fabianhu/ueberloader/README.md

# ueberloader

A RC Battery Charger with high power output and quite small footprint.

Capable of charging 6S at 10A with 24V power supply.

Core component is a "full bridge converter" which is controlled via software.
