fabianhu/ueberloader/LipoLoader/PCB/bom.ods

Sheet: Bestellung 1
1 |  | CON_BOX_10L | SV5 | Farnell 1099245 od 835993 | 2 | 1099245 | 1099245,2, CON_BOX_10L SV5 | CON_BOX_10L SV5
1 |  | LED5MM | LED1 |  | 2 |  |  | LED5MM LED1
1 | 0.1R | R-EU_R2010 | R51 | Farnell 1100053 | 2 | 1100053 | 1100053,2, R-EU_R2010 R51 | R-EU_R2010 R51
1 | 0.005R | R-EU_R2010 | R20 | Farnell 1621986 | 25 | 1621986 | 1621986,25, R-EU_R2010 R20 | R-EU_R2010 R20
10 | 0R | R-EU_R0603 | R1, R2, R3, R5, R9, R10, R100, R101, R501, R502 |  | 20 |  |  | R-EU_R0603 R1 R2 R3 R5 R9 R10 R100 R101 R501 R502
1 | 1k - 0.1% | R-EU_R0603 | R69 | Farnell 1653252 | 0 |  |  | R-EU_R0603 R69
8 | 1u | C-EUC1206K | C11, C13, C15, C30, C31, C32, C33, C35 | Farnell 1759446 | 20 | 1759446 | 1759446,20, C-EUC1206K C11 C13 C15 C30 C31 C32 C33 C35 | C-EUC1206K C11 C13 C15 C30 C31 C32 C33 C35
1 | 2k - 0.1% | R-EU_R0603 | R68 | Farnell 1653263 | 2 |  |  | R-EU_R0603 R68
2 | 2k2 | R-EU_R0603 | R11, R24 |  | 4 |  |  | R-EU_R0603 R11 R24
8 | 4k7 | R-EU_R0603 | R43, R44, R45, R46, R47, R48, R75, R77 |  | 16 |  |  | R-EU_R0603 R43 R44 R45 R46 R47 R48 R75 R77
4 | 10µF | C-EUC1206K | C12 | Farnell 1611967 | 20 | 1611967 | 1611967,20, C-EUC1206K C12 | C-EUC1206K C12
4 | 10 | R-EU_R0603 | R4, R8, R87, R88 |  | 8 |  |  | R-EU_R0603 R4 R8 R87 R88
6 | 10 | R-EU_R2512 | R17, R18, R19, R21, R22, R32 | Farnell 9235892 od 1100110 | 12 | 9235892 | 9235892,12, R-EU_R2512 R17 R18 R19 R21 R22 R32 | R-EU_R2512 R17 R18 R19 R21 R22 R32
18 | 10k | R-EU_R0603 | R6, R38, R39, R40, R41, R42, R49, R50, R79, R80, R81, R82, R83, R84, R85, R86, R89, R90 |  | 36 |  |  | R-EU_R0603 R6 R38 R39 R40 R41 R42 R49 R50 R79 R80 R81 R82 R83 R84 R85 R86 R89 R90
2 | 10k - 0.1% | R-EU_R0603 | R29, R31 | Farnell 1653253 | 4 | 1653253 | 1653253,4, R-EU_R0603 R29 R31 | R-EU_R0603 R29 R31
2 | 10p | C-EUC0603 | C21, C22 | Farnell 1414600 | 100 | 1414600 | 1414600,100, C-EUC0603 C21 C22 | C-EUC0603 C21 C22
1 | 15V BZT55C15 | ZENER-DIODESOD80C | D5 | Farnell 1621844 | 2 | 1621844 | 1621844,2, ZENER-DIODESOD80C D5 | ZENER-DIODESOD80C D5
1 | 16MHz | CRYSTALHC49U-V | QU | Farnell 1469641 | 0 |  |  | CRYSTALHC49U-V QU
1 | 18k - 0.1% | R-EU_R0603 | R67 | Farnell 1160373 od 1400600 | 2 |  |  | R-EU_R0603 R67
12 | 20k - 0.1% | R-EU_R0603 | R2B, R27, R34, R35, R52, R60, R61, R62, R63, R64, R65, R66 | Farnell 1653264 | 24 |  |  | R-EU_R0603 R2B R27 R34 R35 R52 R60 R61 R62 R63 R64 R65 R66
12 | 27k - 0.1% | R-EU_R0603 | R1B, R25, R33, R36, R37, R53, R54, R55, R56, R57, R58, R59 | Farnell 1692500 | 24 |  |  | R-EU_R0603 R1B R25 R33 R36 R37 R53 R54 R55 R56 R57 R58 R59
1 | 27nH | R-EU_R0603 | L7 | Farnell 1457815 | 2 | 1457815 | 1457815,2, R-EU_R0603 L7 | R-EU_R0603 L7
1 | 33k - 0.1% | R-EU_R0603 | R28 | Farnell 1653270 | 2 |  |  | R-EU_R0603 R28
1 | 43k - 0.1% | R-EU_R0603 | R30 | Farnell 1400610 od 1670198 | 2 |  |  | R-EU_R0603 R30
3 | 63k4 - 0.1% | R-EU_R0603 | R70, R71, R72 | Farnell 1353179 | 6 |  |  | R-EU_R0603 R70 R71 R72
1 | 78L05SMD | 78L05SMD | IC4 | Farnell 1087098 | 10 |  |  | 78L05SMD IC4
1 | 100k | R-EU_R0603 | R26 |  | 2 |  |  | R-EU_R0603 R26
20 | 100n | C-EUC0603K | C1, C2, C3, C4, C5, C6, C9, C14, C16, C17, C18, C23, C24, C25, C26, C27, C28, C29, C36, C37 |  | 40 |  |  | C-EUC0603K C1 C2 C3 C4 C5 C6 C9 C14 C16 C17 C18 C23 C24 C25 C26 C27 C28 C29 C36 C37
2 | 100u Tan | CPOL-EUSMCC | C19, C20 | Farnell 1754066 | 4 | 1754066 | 1754066,4, CPOL-EUSMCC C19 C20 | CPOL-EUSMCC C19 C20
2 | 330µF / 25V | CPOL-EUE3.5-8 | C7, C8 | Farnell 1219469 | 50 | 1219469 | 1219469,50, CPOL-EUE3.5-8 C7 C8 | CPOL-EUE3.5-8 C7 C8
2 | 330 | R-EU_R0603 | R74, R76 |  | 4 |  |  | R-EU_R0603 R74 R76
1 | 330 | R-EU_R0805 | R12 |  | 2 |  |  | R-EU_R0805 R12
2 | 1000µF/35V | CPOL | C10, C34 | Farnell 1219476 | 4 | 1219476 | 1219476,4, CPOL C10 C34 | CPOL C10 C34
1 | AVR_XMEGA_A4_44A | AVR_XMEGA_A4_44A | IC3 | http://shop.embedit.de/product__809.php | 2 |  |  | AVR_XMEGA_A4_44A IC3
5 | BC817-25SMD | BC817-25SMD | Q7, Q8, Q9, Q10, Q11 | Farnell 1081223 | 10 |  |  | BC817-25SMD Q7 Q8 Q9 Q10 Q11
1 | COILCRAFT_D333 | COILCRAFT_D333 | L1 |  | 2 |  |  | COILCRAFT_D333 L1
3 | FDC6401N | FDC6401N | T7, T8, T9 | Farnell 1467966 | 8 | 1467966 | 1467966,8, FDC6401N T7 T8 T9 | FDC6401N T7 T8 T9
2 | Fuse 10A | R-EU_WSC2515 | F1, F2 | RS 131-505 | 4 |  |  | R-EU_WSC2515 F1 F2
1 | ILD217 | ILD217 | OK1 | Farnell 1469512 | 4 | 1469512 | 1469512,4, ILD217 OK1 | ILD217 OK1
2 | IR2181=NCP5181 | IR2181=NCP5181 | U$5, U$6 | Farnell 1547140 | 10 | 1547140 | 1547140,10, IR2181=NCP5181 U$5 U$6 | IR2181=NCP5181 U$5 U$6
4 | LL43-GS08 | DIODE-SOD80C | D1, D2, D3, D4 | Farnell 1779222 oder alt. 9804226 | 25 | 1779222 | 1779222,25, DIODE-SOD80C D1 D2 D3 D4 | DIODE-SOD80C D1 D2 D3 D4
2 | LM224D | LM324D | IC1, IC2 | Farnell 1426352 Reichelt | 25 | 1426352 | 1426352,25, LM324D IC1 IC2 | LM324D IC1 IC2
1 | LM1117 | LM1117 | U$1 |  | 2 |  |  | LM1117 U$1
7 | MOSFET-NIRLR8743 | MOSFET-NIRLR8743 | T1, T2, T3, T4, T5, T6, T11 | Farnell 1551908 | 100 | 1551908 | 1551908,100, MOSFET-NIRLR8743 T1 T2 T3 T4 T5 T6 T11 | MOSFET-NIRLR8743 T1 T2 T3 T4 T5 T6 T11
2 | NB12K00103JBB | R-EU_R0603 | R7, R23 | Farnell 9528075 | 5 | 9528075 | 9528075,5, R-EU_R0603 R7 R23 | R-EU_R0603 R7 R23
6 | SOLPAD3MM | SOLPAD3MM | BATT+, BATT-, COIL1, COIL2, SUPP+, SUPP- |  | 12 |  |  | SOLPAD3MM BATT+ BATT- COIL1 COIL2 SUPP+ SUPP-
4 | TPTP15R | TPTP15R | TP1, TP2, TP3, TP4 |  | 8 |  |  | TPTP15R TP1 TP2 TP3 TP4
1 | aux1 | MA04-1 | SV2 |  | 2 |  |  | MA04-1 SV2
1 | comm | ML6L | SV4 | Farnell 1096979 Bu 1097021 | 2 | 1096979 | 1096979,2, ML6L SV4 | ML6L SV4
1 | encoder | MA04-1 | AUX2 |  | 2 |  |  | MA04-1 AUX2
1 | spare | MA07-1 | SV1 |  | 2 |  |  | MA07-1 SV1
 |  | IRLR8726PBF |  |  | 1 | 1698305 | 1698305,1, IRLR8726PBF | IRLR8726PBF
 |  | IRLR8721 |  |  | 1 | 1551907 | 1551907,1, IRLR8721 | IRLR8721
 |  | bu 6 |  |  | 4 | 1097021 | 1097021,4, bu 6 | bu 6
 |  | Bu10 |  |  | 3 | 1099236 | 1099236,3, Bu10 | Bu10
 |  | 100nf |  |  | 1000 | 1692286 (http://de.farnell.com/kemet/c0603c104k5rac-tu/capacitor-mlcc-0603-50v-0-1uf/dp/1692286) | 1692286,1000, 100nf | 100nf

Sheet: Bestellung 2
 |  |  |  |  |  | 4
Qty | Value | Device | Parts | BEST | vorhanden | zu Bestellen | Farnell importer
0 | aux | MA04-1 | AUX1 |  |  | 0 |  | aux
0 | encoder | MA04-1 | AUX2 |  |  | 0 |  | encoder
0 | SOLPAD3MM | SOLPAD3MM | BATT+, BATT-, COIL1, COIL2, SUPP+, SUPP- |  |  | 0 |  | SOLPAD3MM
21 | 100n | C-EUC0603K | C1, C2, C3, C4, C5, C6, C9, C13, C14, C16, C17, C18, C23, C24, C25, C26, C27, C28, C29, C36, C37 |  | 1000 | 0 |  | 100n
2 | 1000µF/35V | CPOL | C10, C34 | Farnell 1219476 | 8 | 0 |  | 1000µF/35V
9 | 1u | C-EUC1206K | C11, C15, C30, C31, C32, C33, C38, C39, C40 | Farnell 1759446 | 40 | 0 |  | 1u
5 | 10µF | C-EUC1206K | C12, C35, C41, C42, C43 | Farnell 1611967 | 20 | 0 |  | 10µF
2 | 100u Tan | CPOL-EUSMCC | C19, C20 | Farnell 1754066 | 10 | 0 |  | 100u Tan
2 | 10p | C-EUC0603 | C21, C22 | Farnell 1414600 | 100 | 0 |  | 10p
2 | 330µF / 25V | CPOL-EUE3.5-8 | C7, C8 | Farnell 1219469 | 50 | 0 |  | 330µF / 25V
6 | LL43-GS08 | DIODE-SOD80C | D1, D2, D3, D4, D6, D7 | Farnell 9804226 oder alt. 1779222 | 25 | 0 |  | LL43-GS08
1 | 15V BZT55C15 | ZENER-DIODESOD80C | D5 | Farnell 1621844 | 10 | 0 |  | 15V BZT55C15
0 | Fuse 10A | R-EU_WSC2515 | F1, F2 | RS 131-505 | 0 | 0 |  | Fuse 10A
2 | LM224D | LM324D | IC1, IC2 | Farnell 1426352 | 25 | 0 |  | LM224D
1 | AVR_XMEGA_A4_44A | AVR_XMEGA_A4_44A | IC3 | http://shop.embedit.de/product__809.php | 24 | 0 |  | AVR_XMEGA_A4_44A
1 | 78L10SMD | 78L10SMD | IC5 | Reichelt µA 78L10 SMD | 4 | 0 |  | 78L10SMD
1 | COILCRAFT_D333 | COILCRAFT_D333 | L1 |  | 5 | 0 |  | COILCRAFT_D333
1 | 27nH | R-EU_R0603 | L7 | Farnell 1457815 | 5 | 0 |  | 27nH
1 |  | LED5MM | LED1 |  | 10 | 0 |  | 0
1 | ILD217 | ILD217 | OK1 | Farnell 1469512 | 4 | 0 |  | ILD217
7 | BC817-25SMD | BC817-25SMD | Q1, Q2, Q7, Q8, Q9, Q10, Q11 | Reichelt BC 817-25 SMD |  | 28 | BC 817,28, BC817-25SMD | BC817-25SMD
1 | 16MHz | CRYSTALHC49U-V | QU | Farnell 1469641 | 4 | 0 |  | 16MHz | Achtung, Quarz ist für SMD, aber Thru hole im Design!
4 | 2k2 | R-EU_R0603 | R1, R11, R14, R24 | Farnell 1469765 | 50 | 0 |  | 2k2
1 | 330 | R-EU_R0805 | R12 | Farnell 1469803 | 50 | 0 |  | 330
6 | 10 | R-EU_R2512 | R17, R18, R19, R21, R22, R32 | Farnell 9235892 od 1100110 | 30 | 0 |  | 10
12 | 47k - 0.1% | R-EU_R0603 | R1B, R25, R33, R36, R37, R53, R54, R55, R56, R57, R58, R59 | Farnell 1653309 | 50 | 0 |  | 47k - 0.1% | Achtung, Widerstand ist 0806
23 | 10k | R-EU_R0603 | R2, R6, R38, R39, R40, R41, R42, R49, R50, R73, R77, R79, R80, R81, R82, R83, R84, R85, R86, R90, R91, R92, R100 | Farnell 1469749 | 100 | 0 |  | 10k
1 | 0.005R | R-EU_R2010 | R20 | Farnell 1621986 | 25 | 0 |  | 0.005R
1 | 100k | R-EU_R0603 | R26 | Farnell 1469649 | 50 | 0 |  | 100k
3 | 10k - 0.1% | R-EU_R0603 | R29, R31, R67 | Farnell 1653253 | 12 | 0 |  | 10k - 0.1%
12 | 22k - 0.1% | R-EU_R0603 | R2B, R27, R34, R35, R52, R60, R61, R62, R63, R64, R65, R66 | Farnell 1653299 | 50 | 0 |  | 22k - 0.1% | Achtung, Widerstand ist 0806
9 | 0R | R-EU_R0603 | R3, R5, R9, R10, R13, R15, R16, R101, R502 | Farnell 1469739 | 50 | 0 |  | 0R
4 | 4r7 | R-EU_R0603 | R4, R8, R87, R88 | Farnell 9332189 | 50 | 0 |  | 4r7
7 | 4k7 | R-EU_R0603 | R43, R44, R45, R46, R47, R48, R78 | Farnell 1469807 | 50 | 0 |  | 4k7
1 | 0.1R | R-EU_R2010 | R51 | Farnell 1100053 | 5 | 0 |  | 0.1R
3 | 2k - 0.1% | R-EU_R0603 | R68, R69, R95 | Farnell 1653263 | 12 | 0 |  | 2k - 0.1%
2 | NB12K00103JBB | R-EU_R0603 | R7, R23 | Farnell 9528075 | 10 | 0 |  | NB12K00103JBB
1 | 36k - 0.1% | R-EU_R0603 | R70 | Farnell 1400608 | 5 | 0 |  | 36k - 0.1%
3 | 120k - 0.1% | R-EU_R0603 | R71, R72, R97 | Farnell 1612041 | 12 | 0 |  | 120k - 0.1%
2 | 820 | R-EU_R0603 | R74, R76 | Farnell 1469841 | 50 | 0 |  | 820
0 | spare | MA07-1 | SV1 |  |  | 0 |  | spare
1 | comm | ML6L | SV4 | Farnell 1096979 Bu 1097021 | 4 | 0 |  | comm
1 |  | CON_BOX_10L | SV5 | Farnell 1099245 od 835993 | 2 | 2 | 1099245,2, 0 | 0
7 | MOSFET-NIRLR8743 | MOSFET-NIRLR8743 | T1, T2, T3, T4, T5, T6, T11 | Farnell 1551908 | 99 | 0 |  | MOSFET-NIRLR8743
1 | FDC6401N | FDC6401N | T10 | Farnell 1467966 | 8 | 0 |  | FDC6401N
3 | QS6J1=FDC6312P | QS6J1=FDC6312P | T8, T9, T14 | Farnell 1525470 od 1700713 | 12 | 0 |  | QS6J1=FDC6312P
0 | TPTP15R | TPTP15R | TP1, TP2, TP3, TP4, TP5, TP6 |  |  | 0 |  | TPTP15R
1 | LM1117 | LM1117 | U$1 |  | 80 | 0 |  | LM1117
2 | LM5106 | LM5106 | U$3, U$4 | Farnell 1312793 | 10 | 0 |  | LM5106
1 | bu 6 |  |  | Farnell 1097021 | 4 | 0 |  | bu 6
1 | Bu10 | Buchse 8! |  | Fischer s.u. | 4 | 0 |  | Bu10
 |  |  |  |  |  | 0 |  | 0
2 | L4941 | DPAK |  | Farnell 1703361 | 8 | 0 |  | L4941
 |  |  |  | Farnell 1324703 | 1 | 0
 | lm317 |  |  | Farnell 1469087 | 10 | 0
 | Gehäuse Lader |  |  | Fischer AKG 55 24 100 SA | 2
 | Gehäuse Display |  |  | Fischer AKG 55 16 80 SA | 1
 | Gehäuse Combi |  |  | Fischer AKG 55 28 100 SA | 2
 | Winkelstecker 8 Pol |  |  | Fischer ASLA 08 G | 10
 | Winkelstecker 6 Pol |  |  | Fischer ASLA 06 G | 15
 | Buchsen 8 Pol |  |  | Fischer FLMP 08 G | 20
 | Buchsen 6 Pol |  |  | Fischer FLMP 06 G | 15
 | Ringkern |  |  | http://www.spulen.com Artikelnummer:T24/011/9 Hersteller:Magnetics (55350-A2)
 | Draht | Durchmesser 1,4mm 25 Windungen |  | www.spulen.com
