fabianhu/ueberloader/LipoDisp/GEH.DXF

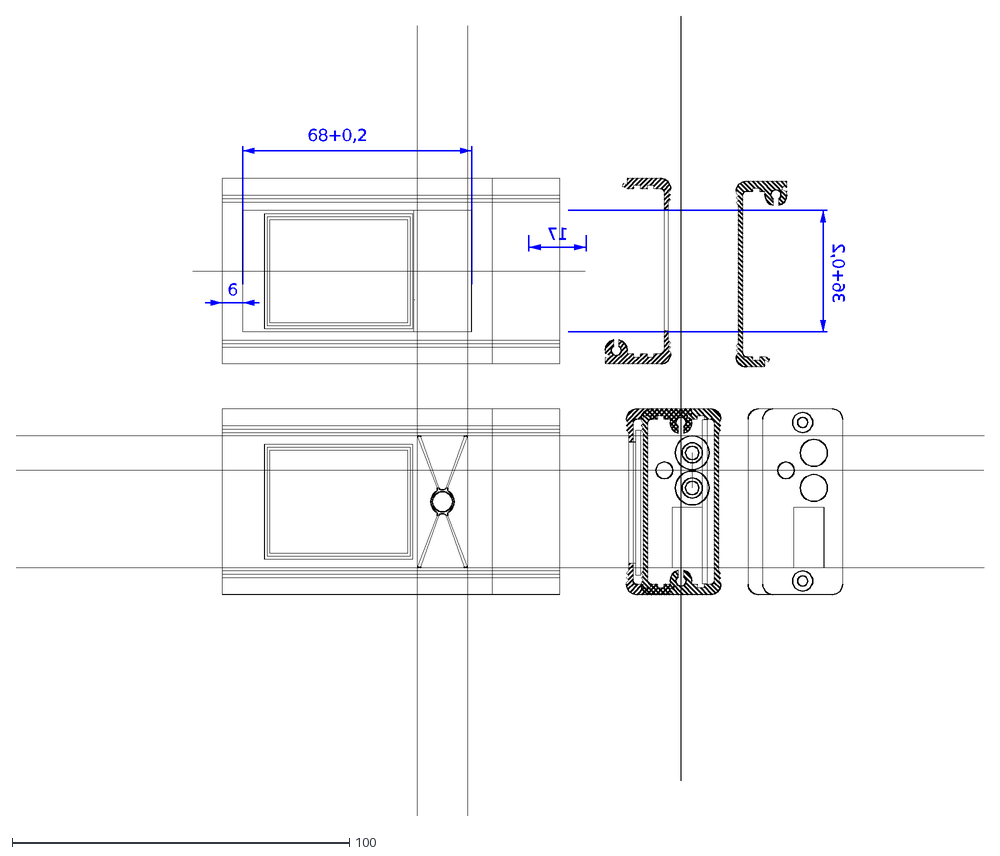
[picture p1: CAD file, 2011-10-27]
LipoDisp/GEH.DXF
68+0,2
36+0,2
6
17
