fabianhu/ueberloader/Calc/Voltage Measurement.ods

Adc-max-U | 2,06
ADC-Offset | 185
R1 | 120000
R2 | 10000
Uin | 12 | 1 | 20 | 24 | 26,8 | 0
Uout | 0,92307692 | 0,07692308 | 1,53846154 | 1,84615385 | 2,06153846 | 0,00000000 | 0,00000000
ADC | 0,45 | 0,04 | 0,75 | 0,9 | 1 | 0
 | 2018,17 | 337,76 | 3240,29 | 3851,35 | 4279,09 | 185
 | 1,96
 | 4,2
factor for cell measure | 2,13958
