fabianhu/ueberloader/Calc/NTC measure.ods

Type: | NB 12 K 0 0103, Farnell 1672286
R @25°C | 10000
B | 3630
alfa | -4
Rpar | 3300
Rvor | 2200
Usupp | 3,3
Theta | R | U2 | Bits | Rpar | U2 par
0 | 30475,01 | 3,08 | 3820,22 | 2977,57 | 1,9
2 | 27668,91 | 3,06 | 3794,31 | 2948,36 | 1,89
4 | 25156,24 | 3,03 | 3766,6 | 2917,31 | 1,88
6 | 22902,98 | 3,01 | 3737,03 | 2884,4 | 1,87
8 | 20879,39 | 2,99 | 3705,56 | 2849,62 | 1,86
10 | 19059,5 | 2,96 | 3672,13 | 2812,96 | 1,85
12 | 17420,5 | 2,93 | 3636,73 | 2774,43 | 1,84
14 | 15942,4 | 2,9 | 3599,31 | 2734,06 | 1,83
16 | 14607,62 | 2,87 | 3559,86 | 2691,88 | 1,82
18 | 13400,68 | 2,83 | 3518,38 | 2647,93 | 1,8
20 | 12307,94 | 2,8 | 3474,88 | 2602,28 | 1,79
22 | 11317,35 | 2,76 | 3429,36 | 2554,99 | 1,77
24 | 10418,24 | 2,72 | 3381,86 | 2506,17 | 1,76
26 | 9601,18 | 2,68 | 3332,42 | 2455,89 | 1,74
28 | 8857,81 | 2,64 | 3281,08 | 2404,28 | 1,72
30 | 8180,68 | 2,6 | 3227,93 | 2351,45 | 1,7
32 | 7563,2 | 2,56 | 3173,02 | 2297,53 | 1,69
34 | 6999,48 | 2,51 | 3116,47 | 2242,66 | 1,67
36 | 6484,26 | 2,46 | 3058,35 | 2186,99 | 1,65
38 | 6012,88 | 2,42 | 2998,8 | 2130,65 | 1,62
40 | 5581,15 | 2,37 | 2937,92 | 2073,81 | 1,6
42 | 5185,31 | 2,32 | 2875,85 | 2016,61 | 1,58
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
