fabianhu/ueberloader/doc/6300_RM-217_RM-222_schematics.pdf

# Customer Care / Service Operations / Content Creation Team

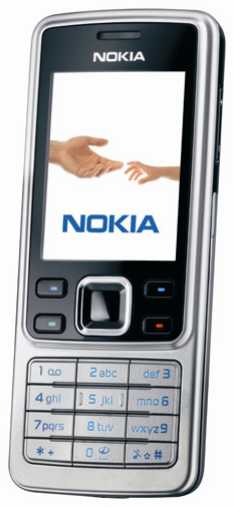
[picture p2: figure]

Confidential Copyright © 2006 NOKIA Only for training purposes | Version: 2.0 | | 19.12.2006 | 6300 | | Board version: 1ywa_32 | | | | Page (11)

# Service Schematics

# Introduction

# RM-217/RM-222

# Important:

This document is intended for use by authorized service centers only.

“Service Schematics“ was created with focus on customer care.

# The purpose of this document is to provide further technical repair information for

NOKIA mobile phones on Level 3/4 service activities.
It contains additional information such as e.g. “Component finder”,
“Frequency band table” or “Antenna switch table”.

# The “Signal overview” page gives a good and fast overview about the most

important signals and voltages on board.
Saving process time and improving the repair quality is the aim of this document.

# It is to be used additionaly to the service manual and other training

or service information such as Service Bulletins.

# All measurements were made using following equipment:

Nokia repair SW | : | Phoenix version 2006.34.2.156
Oscilloscope | : | Fluke PM 3380A/B
Spectrum Analyzer | : | Advanced R3162 with an analog probe
RF-Generator/GSM Tester : | Rhode & Schwarz CMU 200
Multimeter | : | Fluke 73 Series II

# While every endeavour has been made to ensure the accuracy of this document, some

errors may exist. If the reader finds any errors, NOKIA should be notified in writing.

# Please send E-Mail to: training.sace@nokia.com

# Table of contents

# Copyright © NOKIA This material , including documentation and any related computer programs is

protected by copyright, controlled by NOKIA. All rights are reserved. Copying,

# including reproducing, modifying, storing, adapting or translating any or all of this material requires the prior written consent of NOKIA. This material also contains confidential information, which may not be disclosed to others whitout the prior written

consent of NOKIA.

# Frontpage

Frontpage | 1

# AV connector, Mini USB, Charger jack 2

RETU, SIM, Audio | 3
TAHVO | 4
RAPGSM, Combo, microSD | 5
FM radio, Bluetooth | 6
User Interface | 7
Camera | 8
RF Part | 9
Signal overview | 10
Component finder | 11

# Charger jack

# AV connector

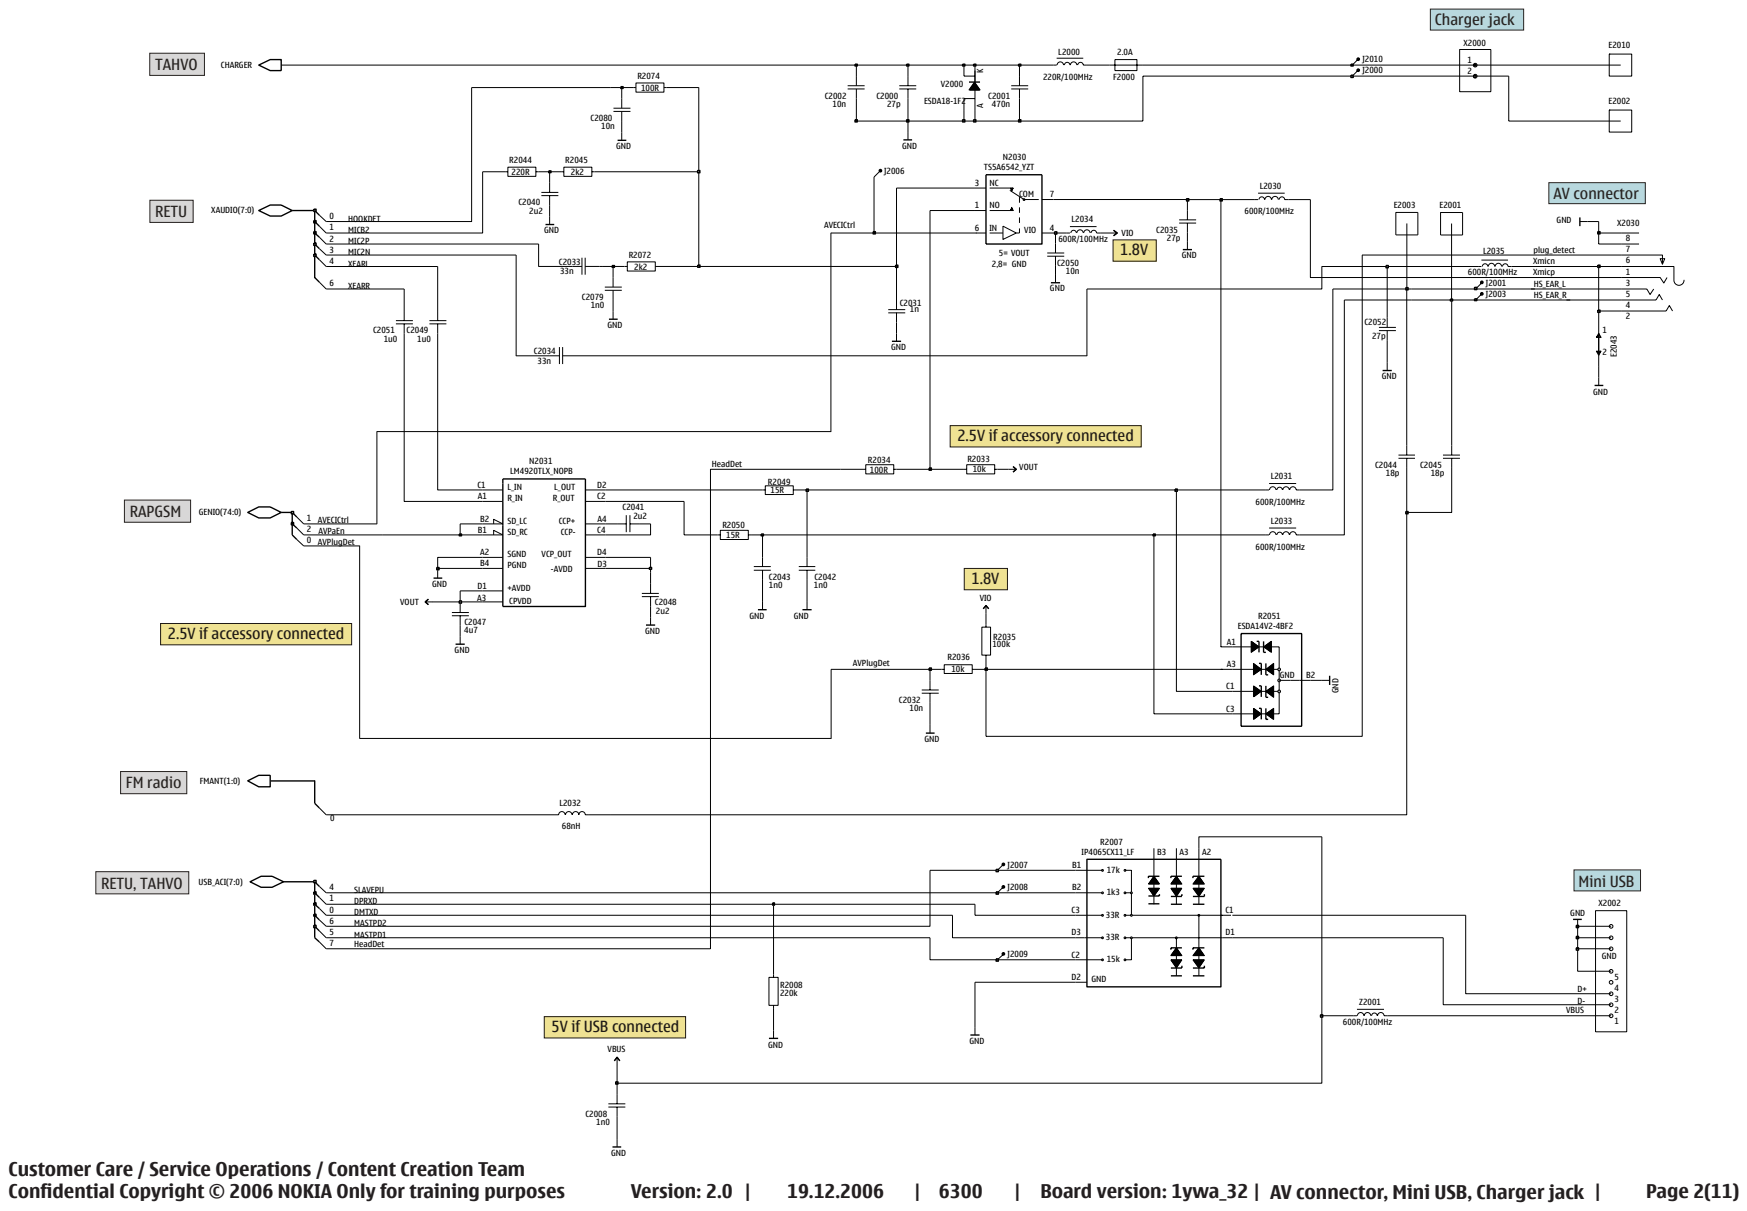
[picture p3: page 2]

L2270
L2102

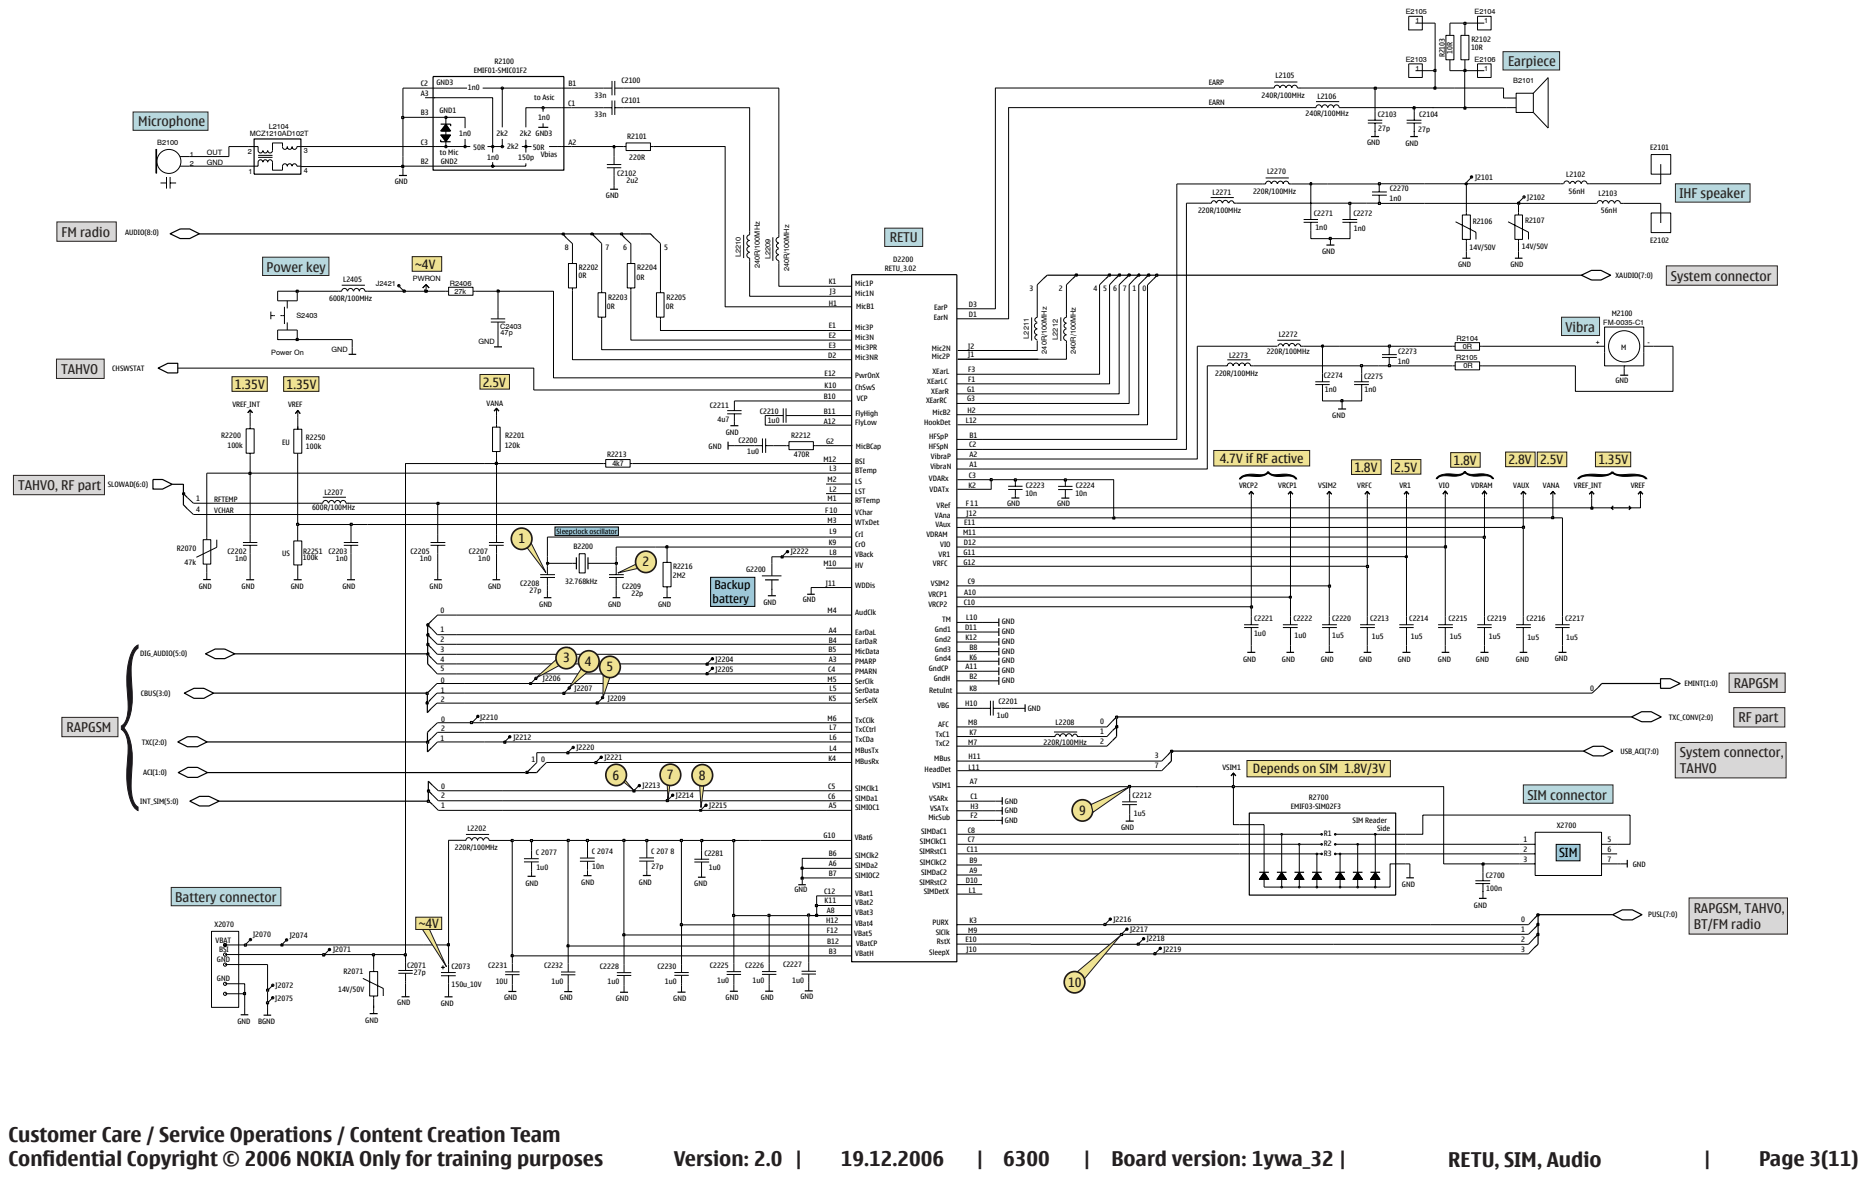
[picture p4: page 3]

VBat4 H12
F12

N2300

# TAHVO_V5.2_LF

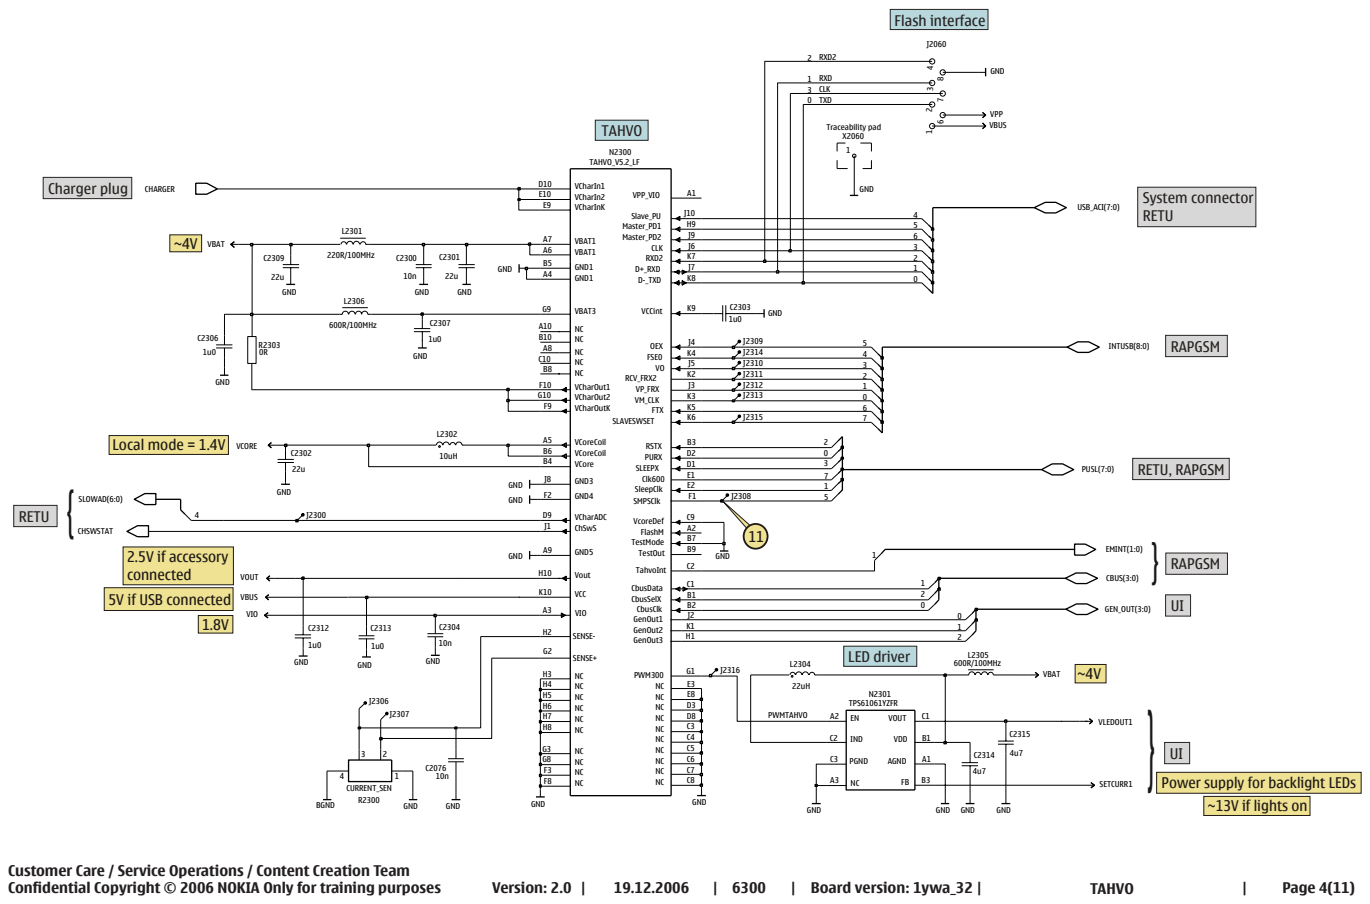
[picture p5: page 4]

Power supply for backlight LEDs
~13V if lights on

# microSD connector

# RAPGSM

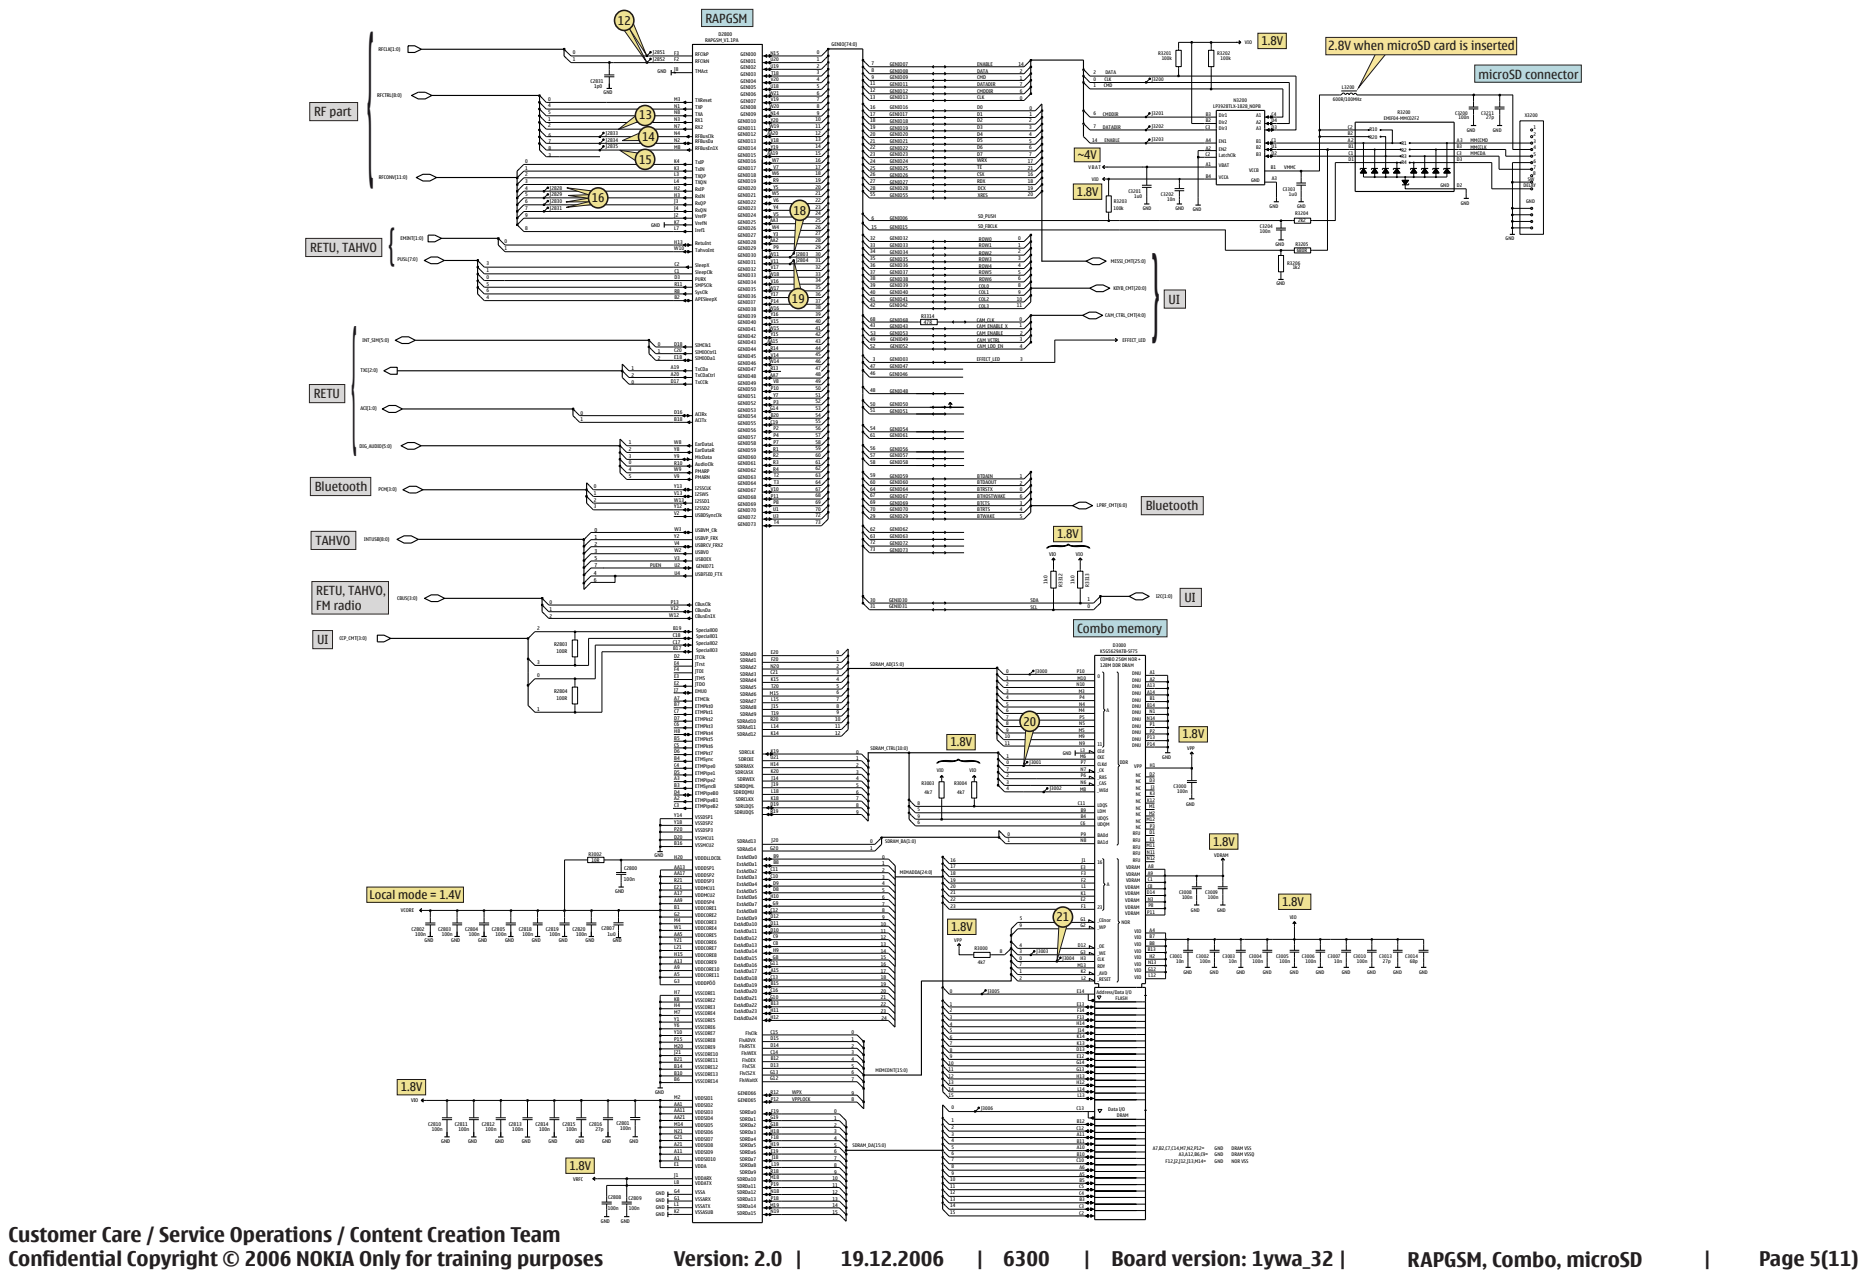
[picture p6: page 5]

2.8V when microSD card is inserted

# FM radio

# RAPGSM

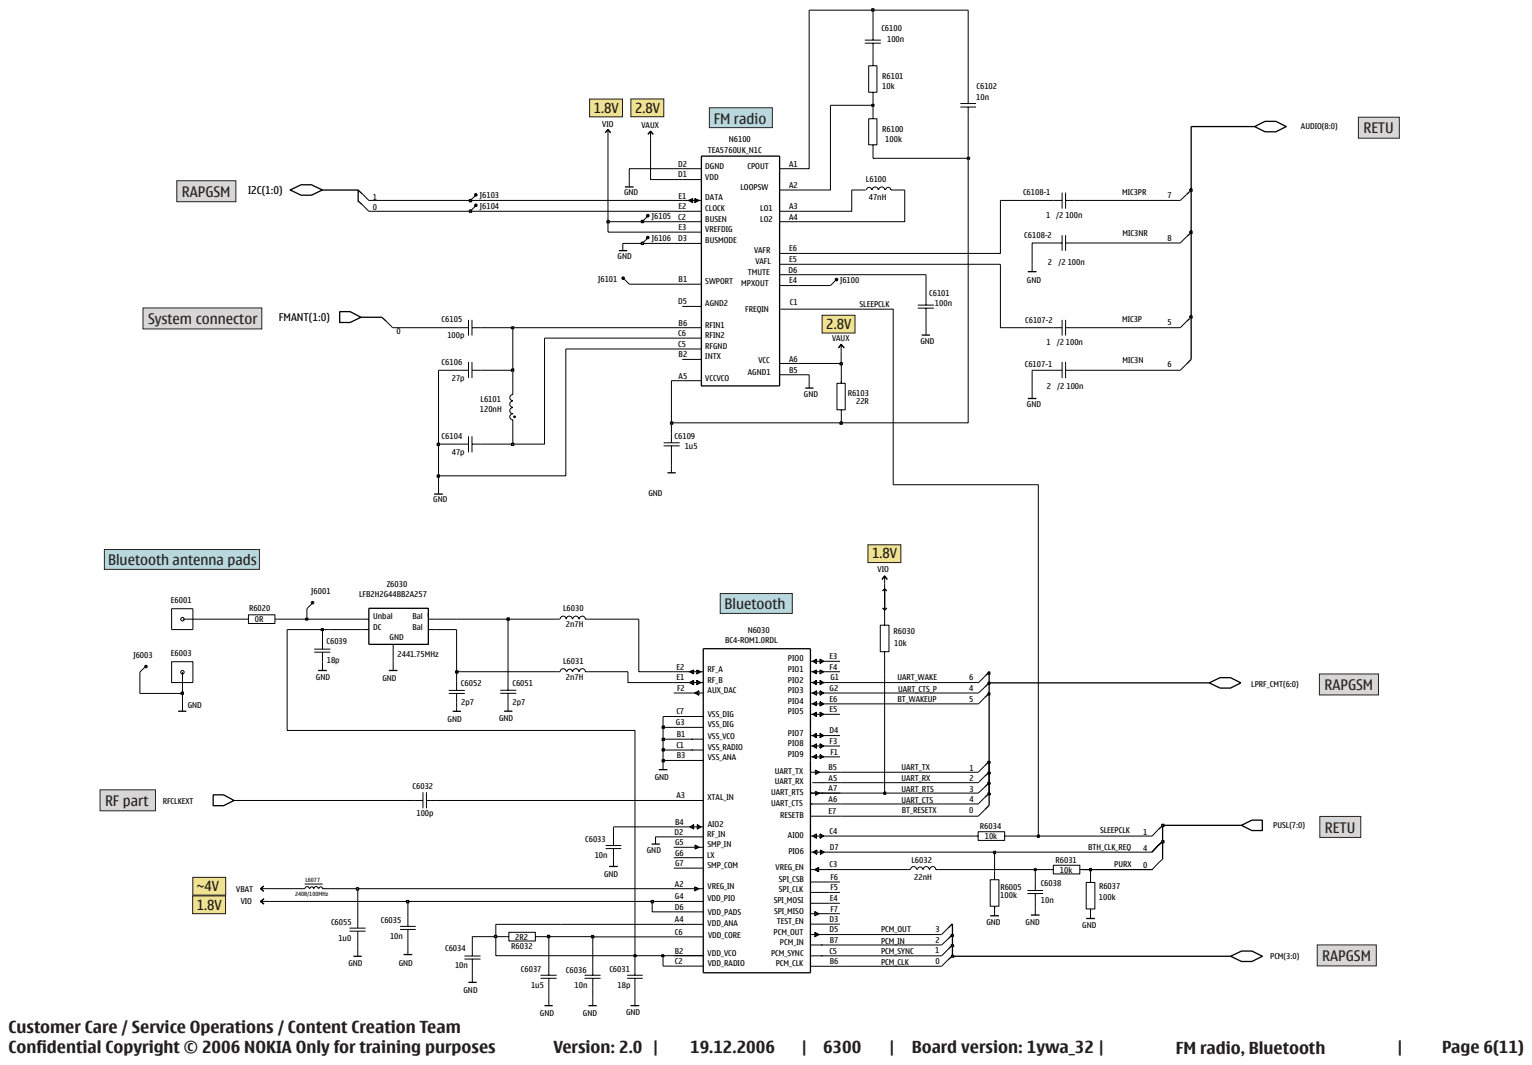
[picture p7: page 6]

# RAPGSM

# EMI filter

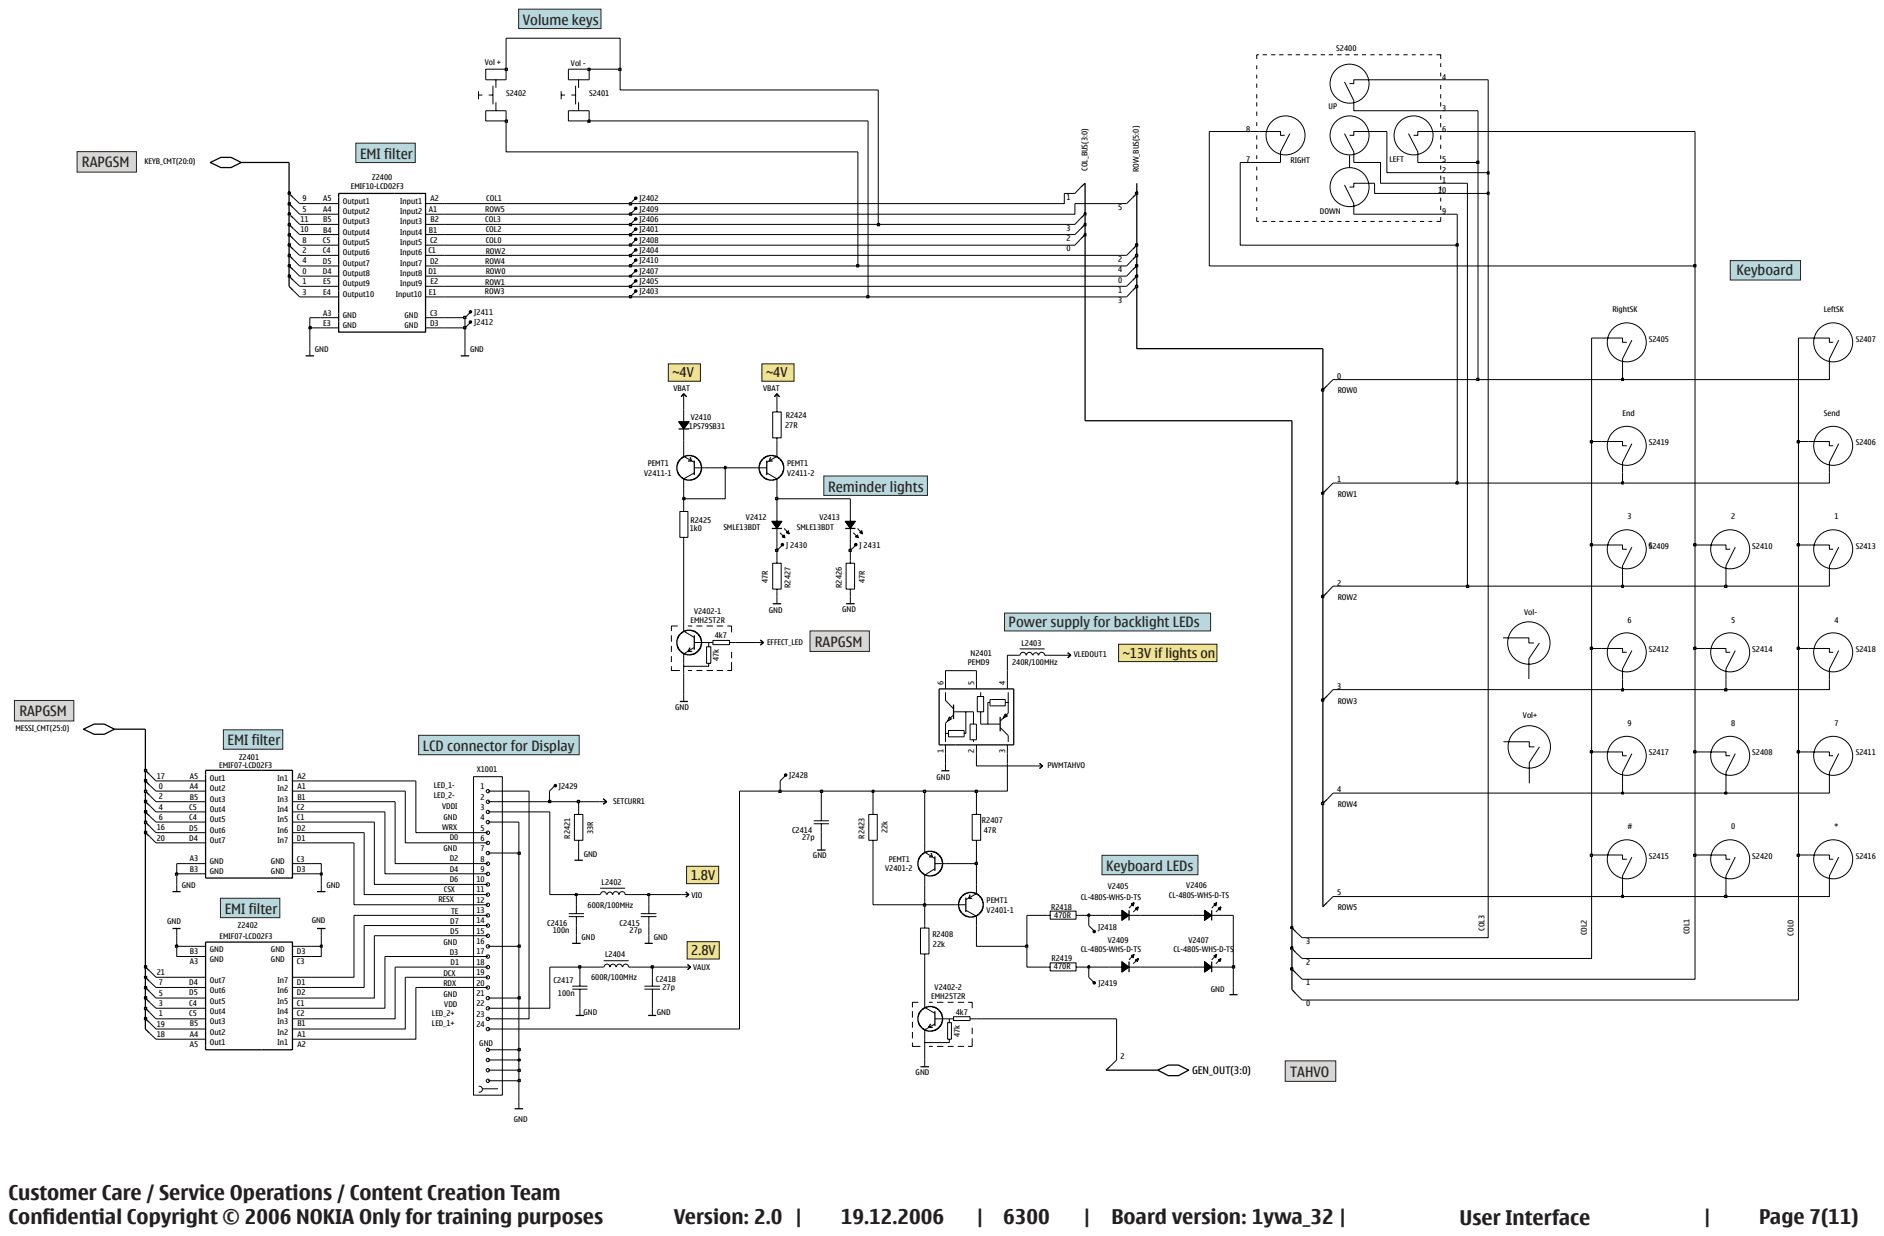
[picture p8: page 7]

Power supply for backlight LEDs

LCD connector for Display

3

# CAM_CTRL_CMT(4:0)

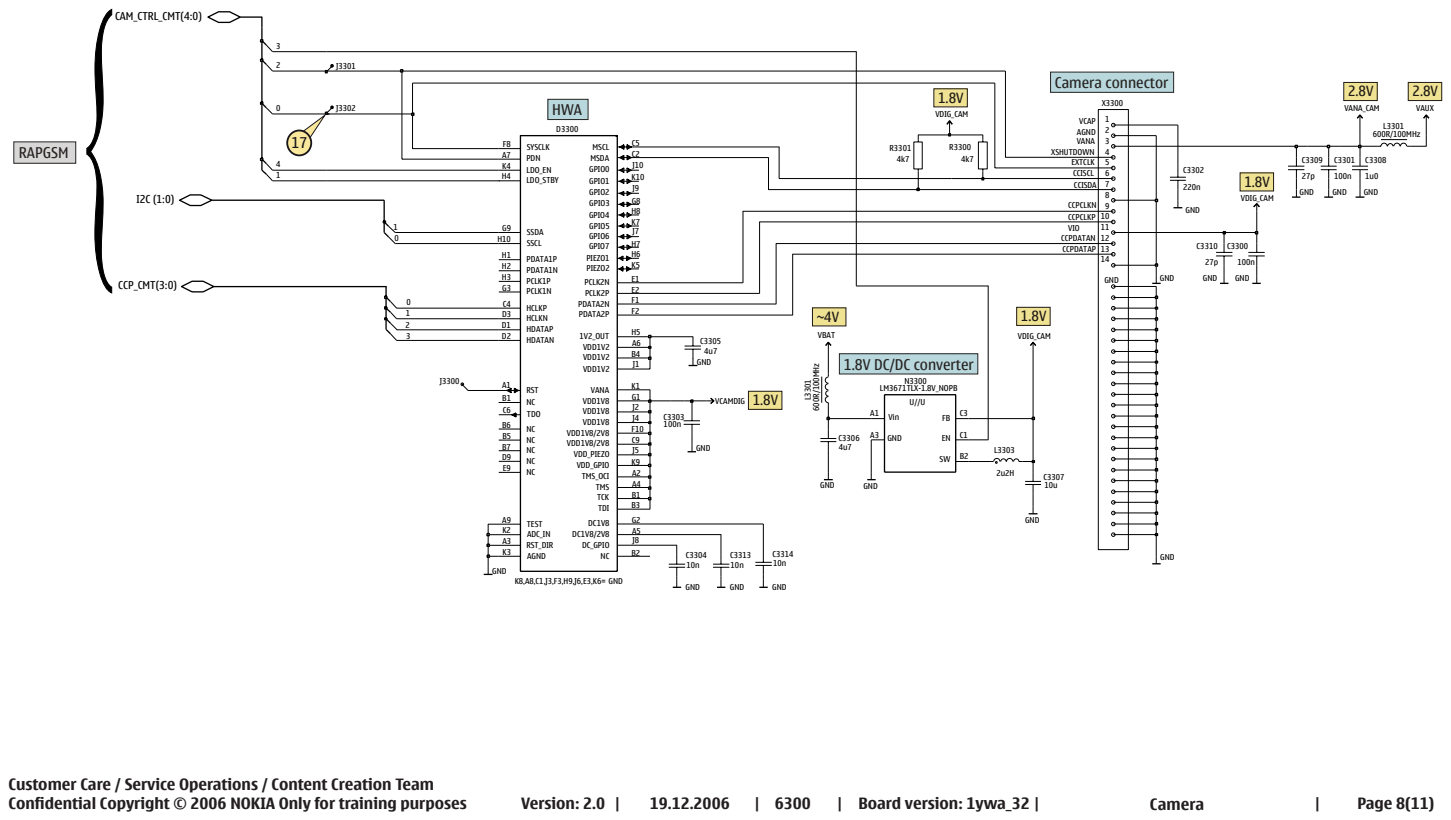
[picture p9: page 8]

## M11 VR2_TX

## M2 VCP

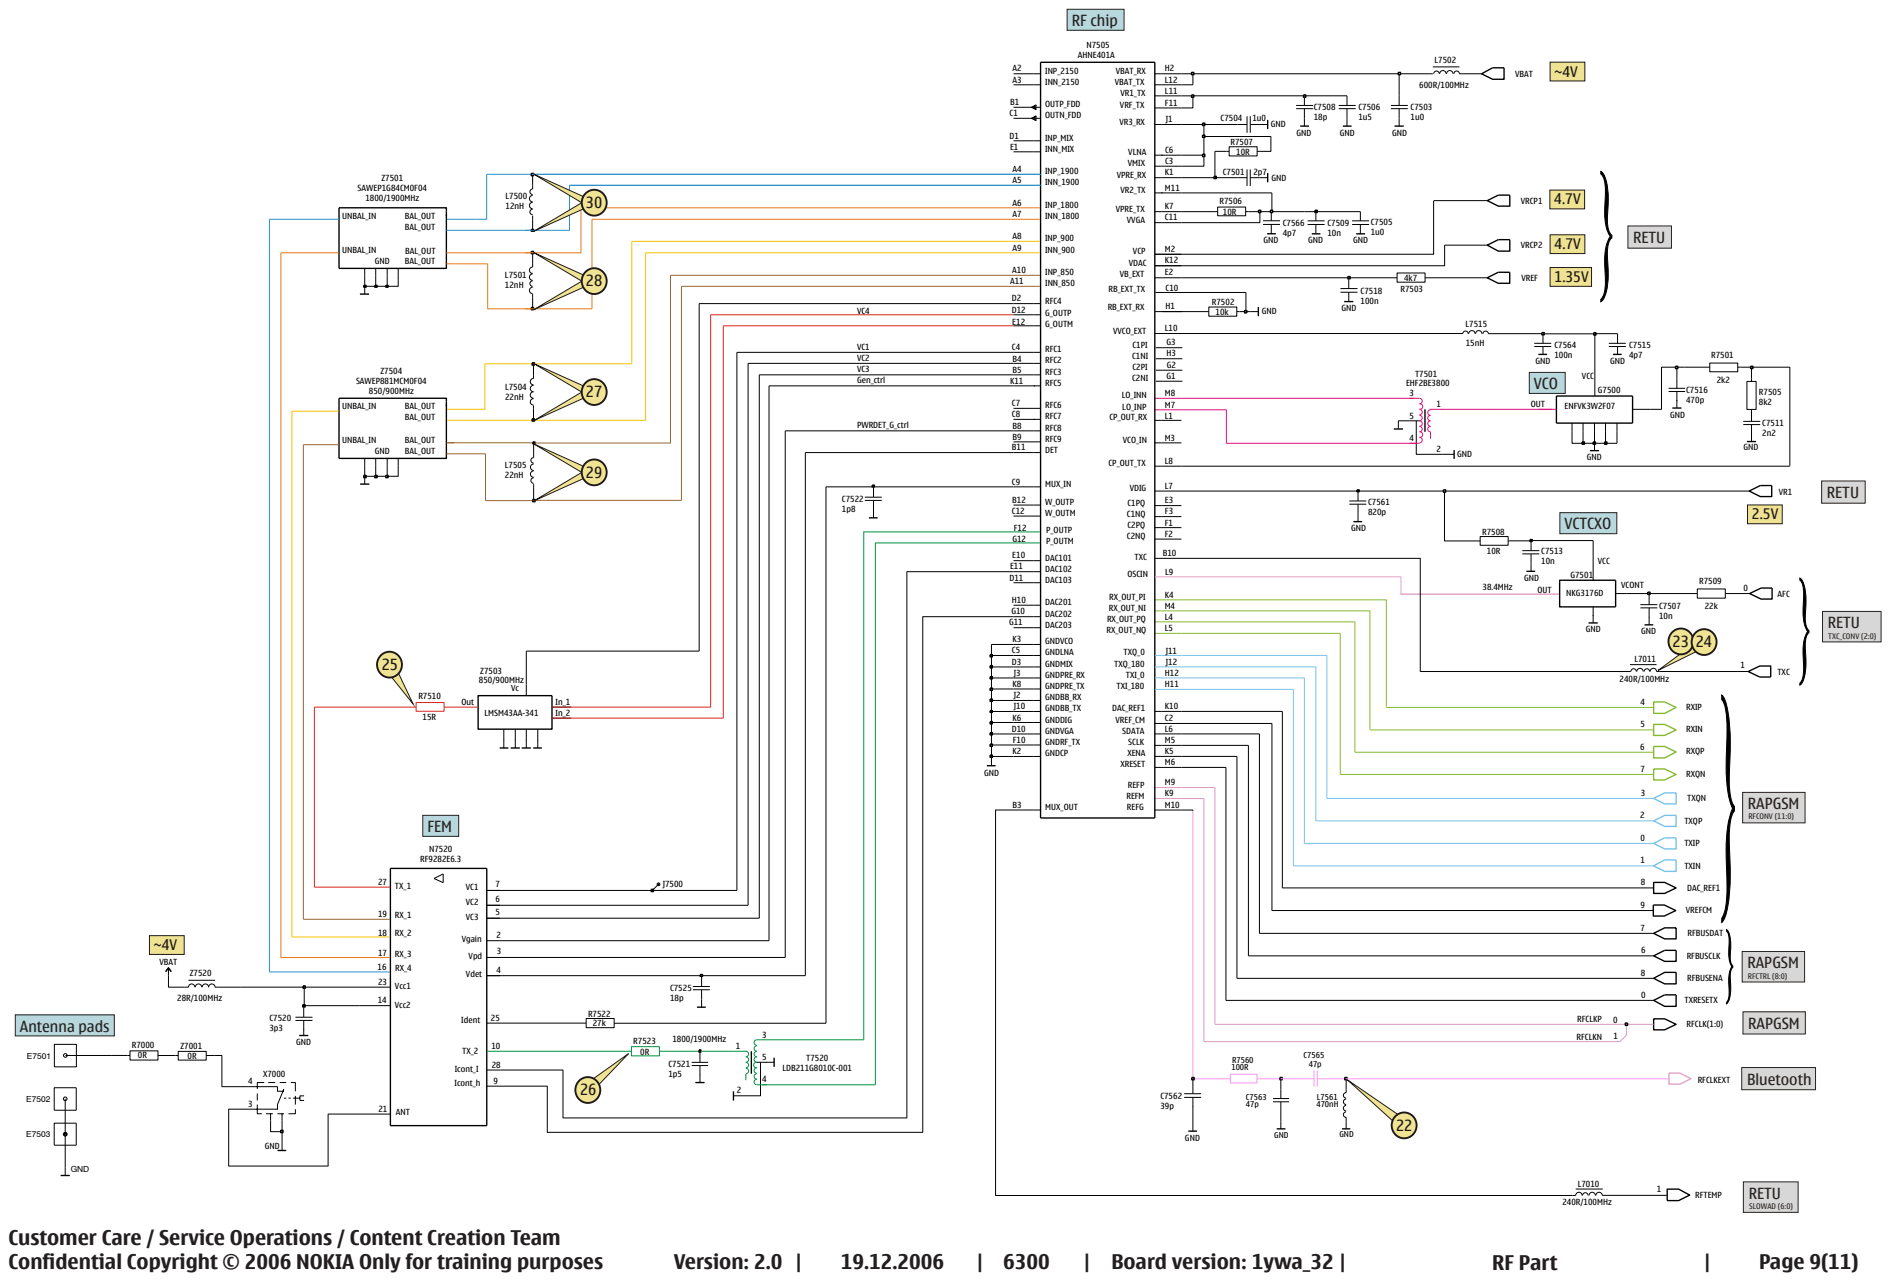
[picture p10: page 9]

# 5) SerSelX at J2209

1) 32kHz at C2208 in | 4) SerData at J2207

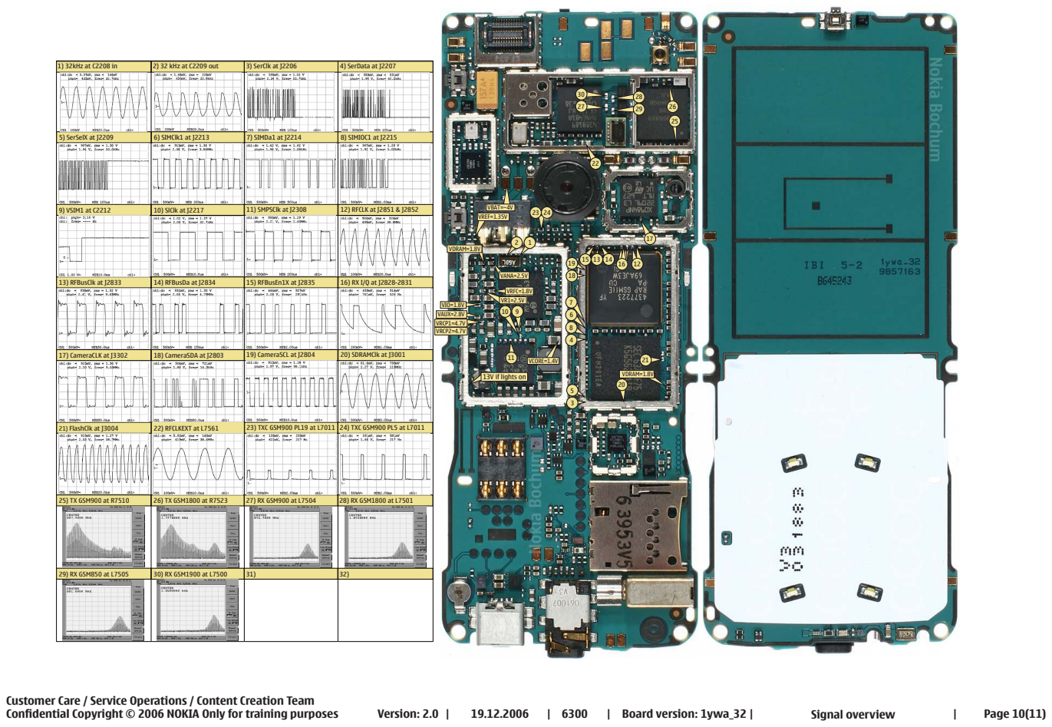
[picture p11: page 10]

B | C2272 | L5 | C3300 | P6 | D3300 | O7 | J2310 | J3 | J7500 | T8 | R2035 | D5 | R6100 | G7
B2100 | B8 | C2273 | K4 | C3301 | N5 | E | J2311 | K3 | L | R2036 | D5 | R6101 | G7

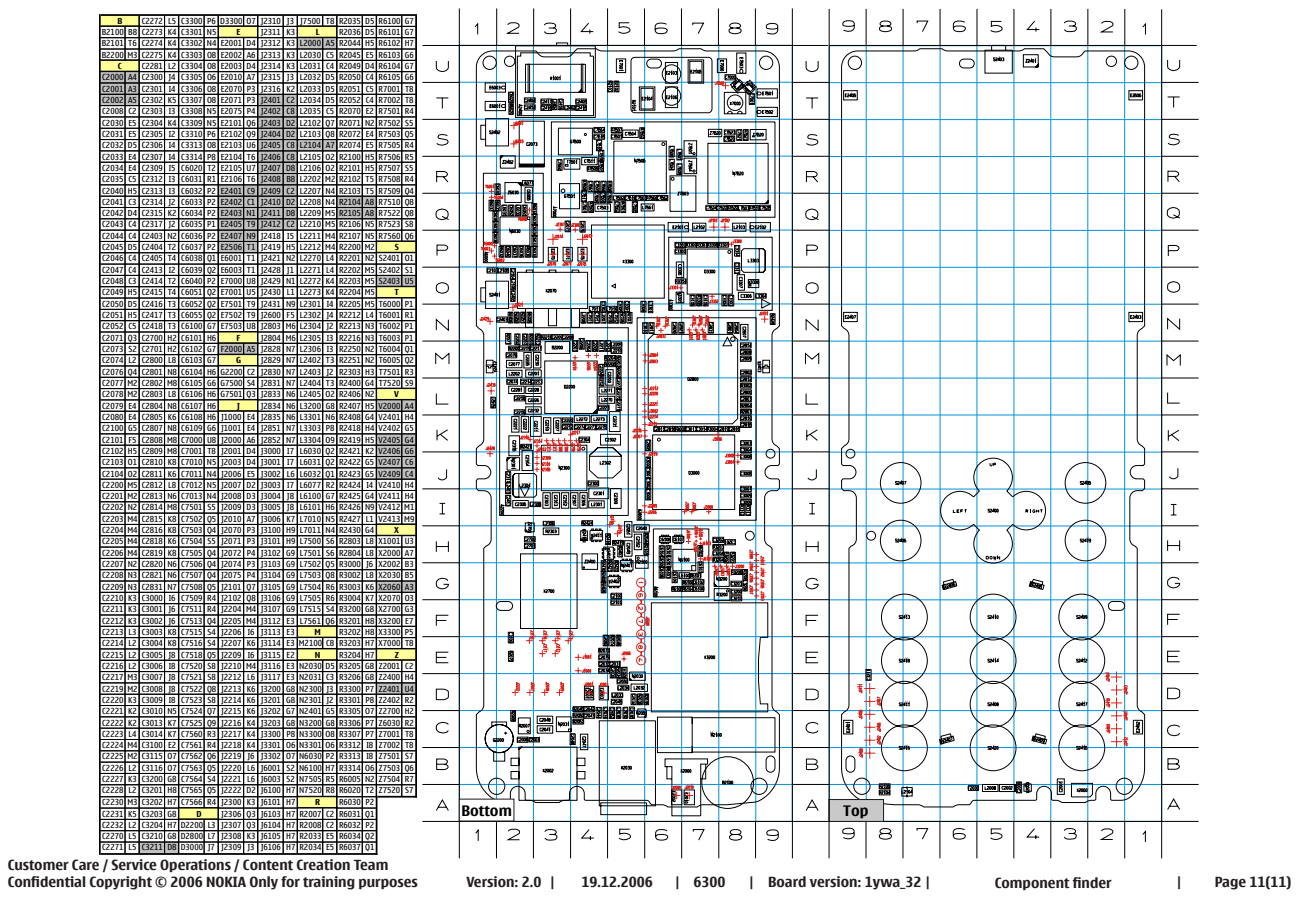
[picture p12: page 11]

B2101 | T6 | C2274 | K4 | C3302 | N4 | E2001 | D4 | J2312 | K3 | L2000 | A5 | R2044 | H5 | R6102 | H7
B2200 | M3 | C2275 | K4 | C3303 | O8 | E2002 | A6 | J2313 | K3 | L2030 | C5 | R2045 | E5 | R6103 | G6
C | | C2281 | L2 | C3304 | O8 | E2003 | D4 | J2314 | K3 | L2031 | C4 | R2049 | D4 | R6104 | G7
C2000 | A4 | C2300 | J4 | C3305 | O6 | E2010 | A7 | J2315 | J3 | L2032 | D5 | R2050 | C4 | R6105 | G6
C2001 | A3 | C2301 | I4 | C3306 | O8 | E2070 | P3 | J2316 | K2 | L2033 | D5 | R2051 | C5 | R7001 | T8
C2002 | A5 | C2302 | K5 | C3307 | O8 | E2071 | P3 | J2401 | C2 | L2034 | D5 | R2052 | C4 | R7002 | T8
C2008 | C2 | C2303 | I3 | C3308 | N5 | E2075 | P4 | J2402 | C8 | L2035 | C5 | R2070 | E2 | R7501 | R4
C2030 | E5 | C2304 | K4 | C3309 | N5 | E2101 | Q6 | J2403 | D2 | L2102 | Q7 | R2071 | N2 | R7502 | S5
C2031 | E5 | C2305 | I2 | C3310 | P6 | E2102 | Q9 | J2404 | D2 | L2103 | Q8 | R2072 | E4 | R7503 | Q5
C2032 | D5 | C2306 | I4 | C3313 | O8 | E2103 | U6 | J2405 | C8 | L2104 | A7 | R2074 | E5 | R7505 | R4
C2033 | E4 | C2307 | I4 | C3314 | P8 | E2104 | T6 | J2406 | C8 | L2105 | O2 | R2100 | H5 | R7506 | R5
C2034 | E4 | C2309 | I5 | C6020 | T2 | E2105 | U7 | J2407 | D8 | L2106 | O2 | R2101 | H5 | R7507 | S5
C2035 | C5 | C2312 | I3 | C6031 | R1 | E2106 | T6 | J2408 | B8 | L2202 | M2 | R2102 | T5 | R7508 | R4
C2040 | H5 | C2313 | I3 | C6032 | P2 | E2401 | C9 | J2409 | C2 | L2207 | N4 | R2103 | T5 | R7509 | Q4
C2041 | C3 | C2314 | J2 | C6033 | P2 | E2402 | C1 | J2410 | D2 | L2208 | N4 | R2104 | A8 | R7510 | Q8
C2042 | D4 | C2315 | K2 | C6034 | P2 | E2403 | N1 | J2411 | D8 | L2209 | M5 | R2105 | A8 | R7522 | Q8
C2043 | C4 | C2317 | J2 | C6035 | P1 | E2405 | T9 | J2412 | C2 | L2210 | M5 | R2106 | N5 | R7523 | S8
C2044 | C4 | C2403 | N2 | C6036 | P2 | E2407 | N9 | J2418 | I5 | L2211 | M4 | R2107 | N5 | R7560 | Q6
C2045 | D5 | C2404 | T2 | C6037 | P2 | E2506 | T1 | J2419 | H5 | L2212 | M4 | R2200 | M2 | S
C2046 | C4 | C2405 | T4 | C6038 | Q1 | E6001 | T1 | J2421 | N2 | L2270 | L4 | R2201 | N2 | S2401 | O1
C2047 | C4 | C2413 | I2 | C6039 | Q2 | E6003 | T1 | J2428 | J1 | L2271 | L4 | R2202 | M5 | S2402 | S1
C2048 | C3 | C2414 | T2 | C6040 | P2 | E7000 | U8 | J2429 | N1 | L2272 | K4 | R2203 | M5 | S2403 | U5
C2049 | H5 | C2415 | T4 | C6051 | Q2 | E7001 | U5 | J2430 | L1 | L2273 | K4 | R2204 | M5 | T
C2050 | D5 | C2416 | T3 | C6052 | Q2 | E7501 | T9 | J2431 | N9 | L2301 | I4 | R2205 | M5 | T6000 | P1
C2051 | H5 | C2417 | T3 | C6055 | Q2 | E7502 | T9 | J2600 | F5 | L2302 | J4 | R2212 | L4 | T6001 | R1
C2052 | C5 | C2418 | T3 | C6100 | G7 | E7503 | U8 | J2803 | M6 | L2304 | J2 | R2213 | N3 | T6002 | P1
C2071 | Q3 | C2700 | H2 | C6101 | H6 | F | | J2804 | M6 | L2305 | I3 | R2216 | N3 | T6003 | P1
C2073 | S2 | C2701 | H2 | C6102 | G7 | F2000 | A5 | J2828 | N7 | L2306 | I3 | R2250 | N2 | T6004 | Q1
C2074 | L2 | C2800 | L8 | C6103 | G7 | G | | J2829 | N7 | L2402 | T3 | R2251 | N2 | T6005 | Q2
C2076 | Q4 | C2801 | N8 | C6104 | H6 | G2200 | C2 | J2830 | N7 | L2403 | J2 | R2303 | H3 | T7501 | R3
C2077 | M2 | C2802 | M8 | C6105 | G6 | G7500 | S4 | J2831 | N7 | L2404 | T3 | R2400 | G4 | T7520 | S9
C2078 | M2 | C2803 | L8 | C6106 | H6 | G7501 | Q3 | J2833 | N6 | L2405 | O2 | R2406 | N2 | V
C2079 | E4 | C2804 | N8 | C6107 | H6 | J | | J2834 | N6 | L3200 | G8 | R2407 | H5 | V2000 | A4
C2080 | E4 | C2805 | K6 | C6108 | H6 | J1000 | E4 | J2835 | N6 | L3301 | N6 | R2408 | G4 | V2401 | H4
C2100 | G5 | C2807 | N8 | C6109 | G6 | J1001 | E4 | J2851 | N7 | L3303 | P8 | R2418 | H4 | V2402 | G5
C2101 | F5 | C2808 | M8 | C7000 | U8 | J2000 | A6 | J2852 | N7 | L3304 | O9 | R2419 | H5 | V2405 | G4
C2102 | H5 | C2809 | M8 | C7001 | T8 | J2001 | D4 | J3000 | I7 | L6030 | Q2 | R2421 | K2 | V2406 | G6
C2103 | O1 | C2810 | K8 | C7010 | N5 | J2003 | D4 | J3001 | I7 | L6031 | Q2 | R2422 | G5 | V2407 | C6
C2104 | O2 | C2811 | K6 | C7011 | N4 | J2006 | E5 | J3002 | L6 | L6032 | Q1 | R2423 | G5 | V2409 | C4
C2200 | M5 | C2812 | L8 | C7012 | N5 | J2007 | D2 | J3003 | I7 | L6077 | R2 | R2424 | I4 | V2410 | H4
C2201 | M2 | C2813 | N6 | C7013 | N4 | J2008 | D3 | J3004 | J8 | L6100 | G7 | R2425 | G4 | V2411 | H4
C2202 | N2 | C2814 | M8 | C7501 | S5 | J2009 | D3 | J3005 | J8 | L6101 | H6 | R2426 | N9 | V2412 | M1
C2203 | M4 | C2815 | K8 | C7502 | Q5 | J2010 | A7 | J3006 | K7 | L7010 | N5 | R2427 | L1 | V2413 | M9
C2204 | M4 | C2816 | K8 | C7503 | Q4 | J2070 | P3 | J3100 | H9 | L7011 | N4 | R2430 | G4 | X
C2205 | M4 | C2818 | K6 | C7504 | S5 | J2071 | P3 | J3101 | H9 | L7500 | S6 | R2803 | L8 | X1001 | U3
C2206 | M4 | C2819 | K8 | C7505 | Q4 | J2072 | P4 | J3102 | G9 | L7501 | S6 | R2804 | L8 | X2000 | A7
C2207 | N2 | C2820 | N6 | C7506 | Q4 | J2074 | P3 | J3103 | G9 | L7502 | Q5 | R3000 | J6 | X2002 | B3
C2208 | N3 | C2821 | N6 | C7507 | Q4 | J2075 | P4 | J3104 | G9 | L7503 | Q8 | R3002 | L8 | X2030 | B5
C2209 | N3 | C2831 | N7 | C7508 | Q5 | J2101 | Q7 | J3105 | G9 | L7504 | R6 | R3003 | K6 | X2060 | A3
C2210 | K3 | C3000 | I6 | C7509 | R4 | J2102 | Q8 | J3106 | G9 | L7505 | R6 | R3004 | K7 | X2070 | O3
C2211 | K3 | C3001 | J6 | C7511 | R4 | J2204 | M4 | J3107 | G9 | L7515 | S4 | R3200 | G8 | X2700 | G3
C2212 | K3 | C3002 | J6 | C7513 | Q4 | J2205 | M4 | J3112 | E3 | L7561 | Q6 | R3201 | H8 | X3200 | E7
C2213 | L3 | C3003 | K8 | C7515 | S4 | J2206 | I6 | J3113 | E3 | M | | R3202 | H8 | X3300 | P5
C2214 | L2 | C3004 | K8 | C7516 | S4 | J2207 | K6 | J3114 | E3 | M2100 | C8 | R3203 | H7 | X7000 | T8
C2215 | L2 | C3005 | J8 | C7518 | Q5 | J2209 | I6 | J3115 | E2 | N Z | | R3204 | H7
C2216 | L2 | C3006 | I8 | C7520 | S8 | J2210 | M4 | J3116 | E3 | N2030 | D5 | R3205 | G8 | Z2001 | C2
C2217 | M3 | C3007 | J8 | C7521 | S8 | J2212 | L6 | J3117 | E3 | N2031 | C3 | R3206 | G8 | Z2400 | H4
C2219 | M2 | C3008 | J8 | C7522 | Q8 | J2213 | K6 | J3200 | G8 | N2300 | J3 | R3300 | P7 | Z2401 | U4
C2220 | K3 | C3009 | I8 | C7523 | S8 | J2214 | K6 | J3201 | G8 | N2301 | J2 | R3301 | P8 | Z2402 | R2
C2221 | K2 | C3010 | N5 | C7524 | Q7 | J2215 | K6 | J3202 | G7 | N2401 | G5 | R3305 | O7 | Z2700 | H2
C2222 | K2 | C3013 | K7 | C7525 | Q9 | J2216 | K4 | J3203 | G8 | N3200 | G8 | R3306 | P7 | Z6030 | R2
C2223 | L4 | C3014 | K7 | C7560 | R3 | J2217 | K4 | J3300 | P8 | N3300 | O8 | R3307 | P7 | Z7001 | T8
C2224 | M4 | C3100 | E2 | C7561 | R4 | J2218 | K4 | J3301 | O6 | N3301 | O6 | R3312 | I8 | Z7002 | T8
C2225 | M2 | C3115 | O7 | C7562 | Q6 | J2219 | J6 | J3302 | O7 | N6030 | P2 | R3313 | I8 | Z7501 | S7
C2226 | L2 | C3116 | O7 | C7563 | Q5 | J2220 | L6 | J6001 | S2 | N6100 | H7 | R3314 | O6 | Z7503 | Q6
C2227 | K3 | C3200 | G8 | C7564 | S4 | J2221 | L6 | J6003 | S2 | N7505 | R5 | R6005 | N2 | Z7504 | R7
C2228 | L2 | C3201 | H8 | C7565 | Q5 | J2222 | D2 | J6100 | H7 | N7520 | R8 | R6020 | T2 | Z7520 | S7
C2230 | M3 | C3202 | H7 | C7566 | R4 | J2300 | K3 | J6101 | H7 | R | | R6030 | P2
C2231 | K5 | C3203 | G8 | D | | J2306 | Q3 | J6103 | H7 | R2007 | C2 | R6031 | Q1
C2232 | L2 | C3204 | H7 | D2200 | L3 | J2307 | Q3 | J6104 | H7 | R2008 | C2 | R6032 | P2
C2270 | L5 | C3210 | G8 | D2800 | L7 | J2308 | K3 | J6105 | H7 | R2033 | E5 | R6034 | Q2
C2271 | L5 | C3211 | D8 | D3000 | J7 | J2309 | J3 | J6106 | H7 | R2034 | E5 | R6037 | Q1
