fabianhu/ueberloader/doc/Schematic.pdf

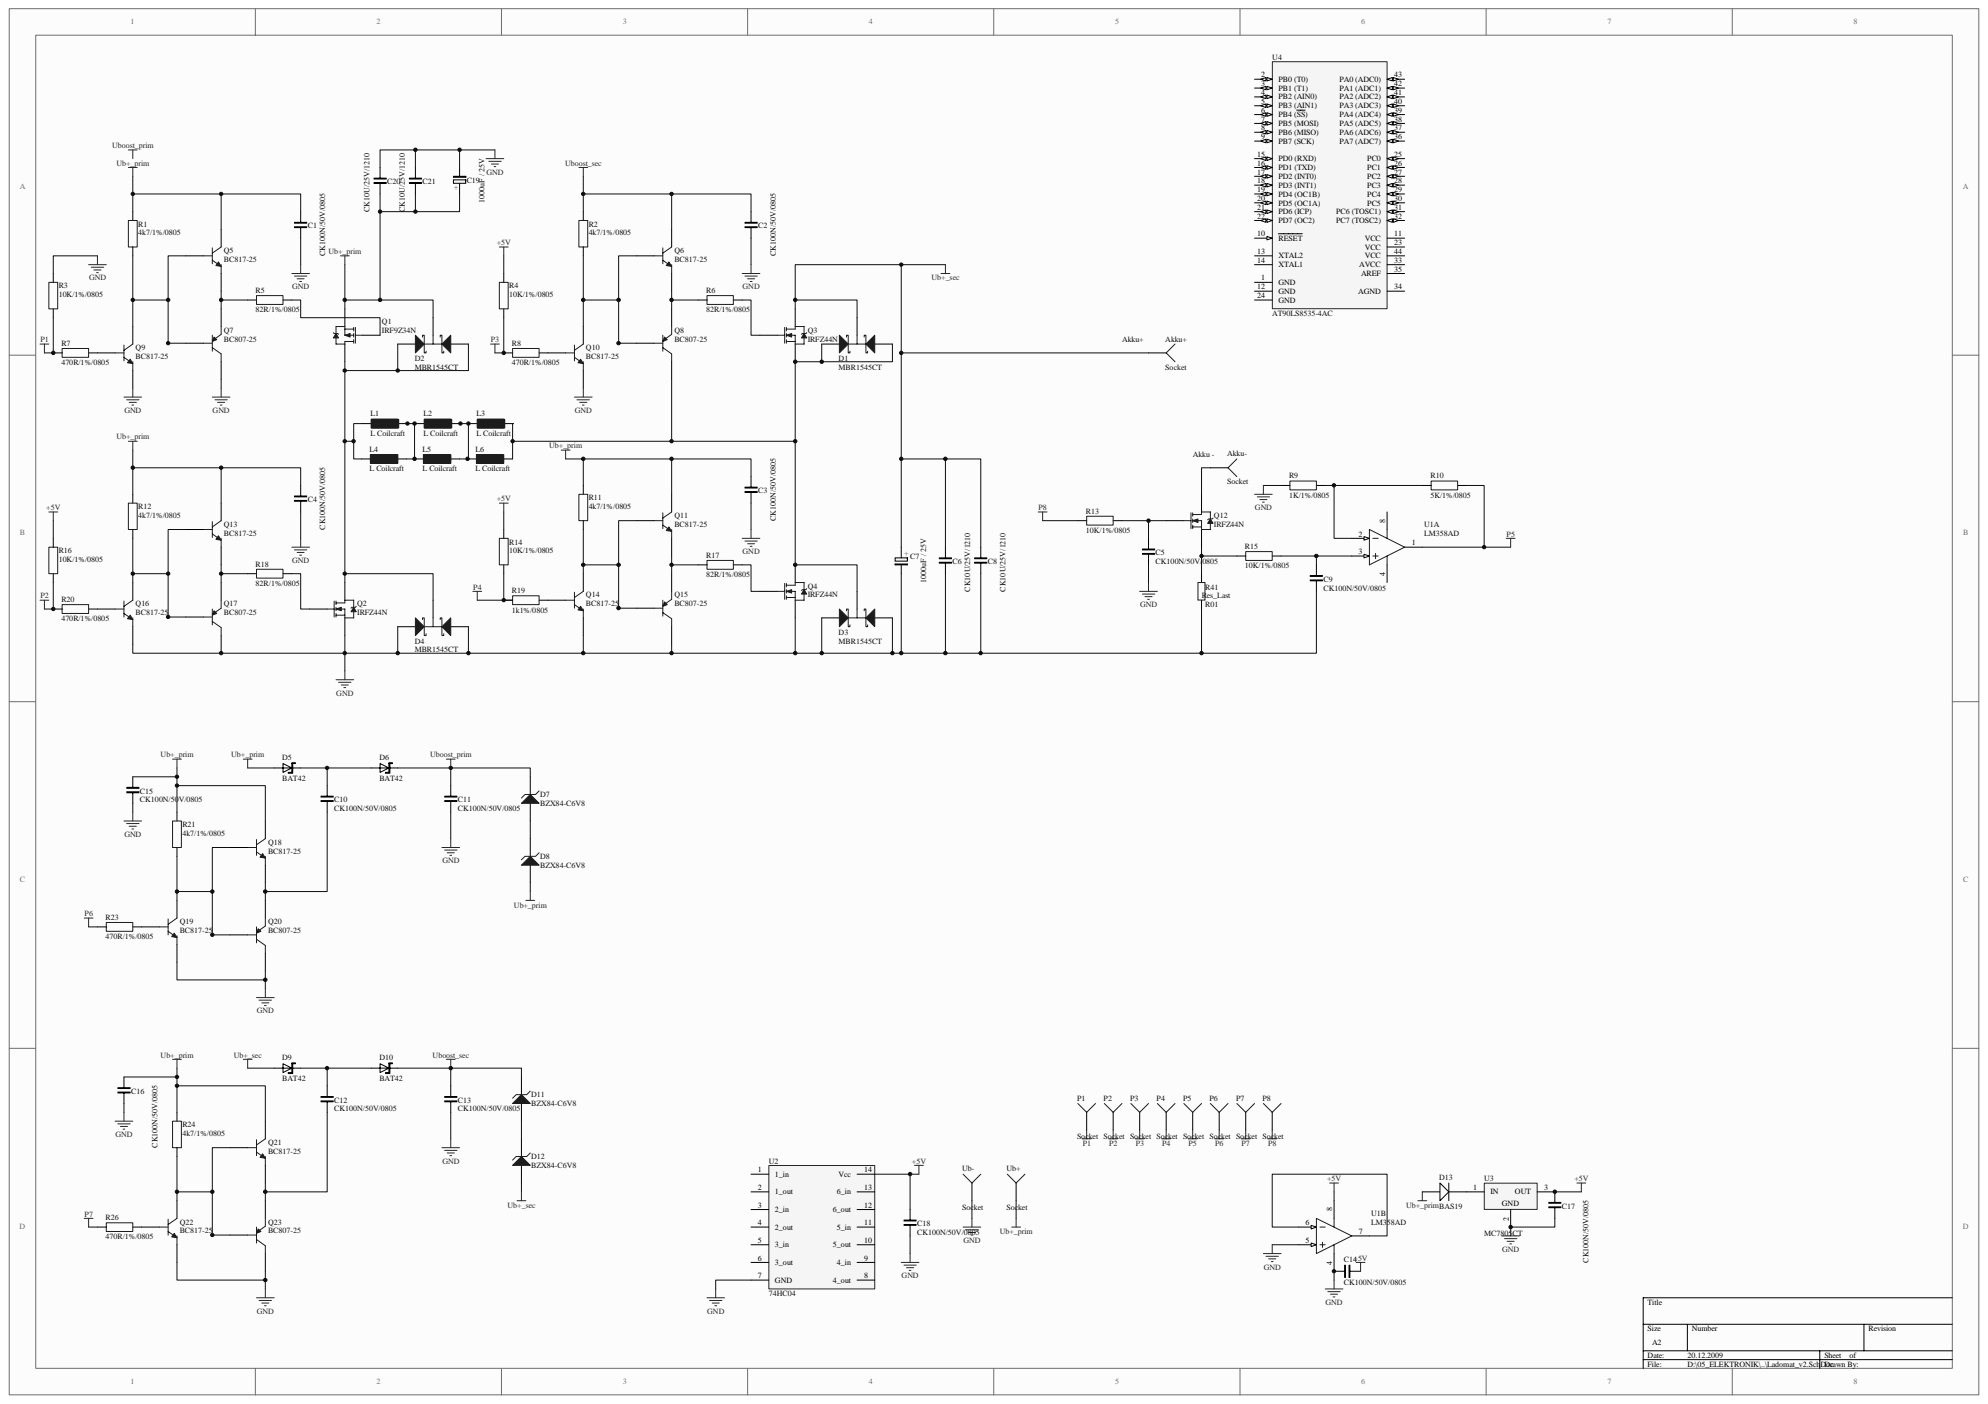
[picture p13: page 1]

Uboost_prim | Uboost_sec | | Akku+ | U4

Ub+_sec

B | | D2 MBR1545CT | D1 | Socket Akku -Akku-Socket | R9 R10 | P5 | B

Size A2 | Number | | Revision

Date: 20.12.2009 | | Sheet of
File: D:\05_ELEKTRONIK\..\Ladomat_v2.SchDoc Drawn By:
