fabianhu/ueberloader/LipoDisp/PCB/LiPoDisp_td.pdf

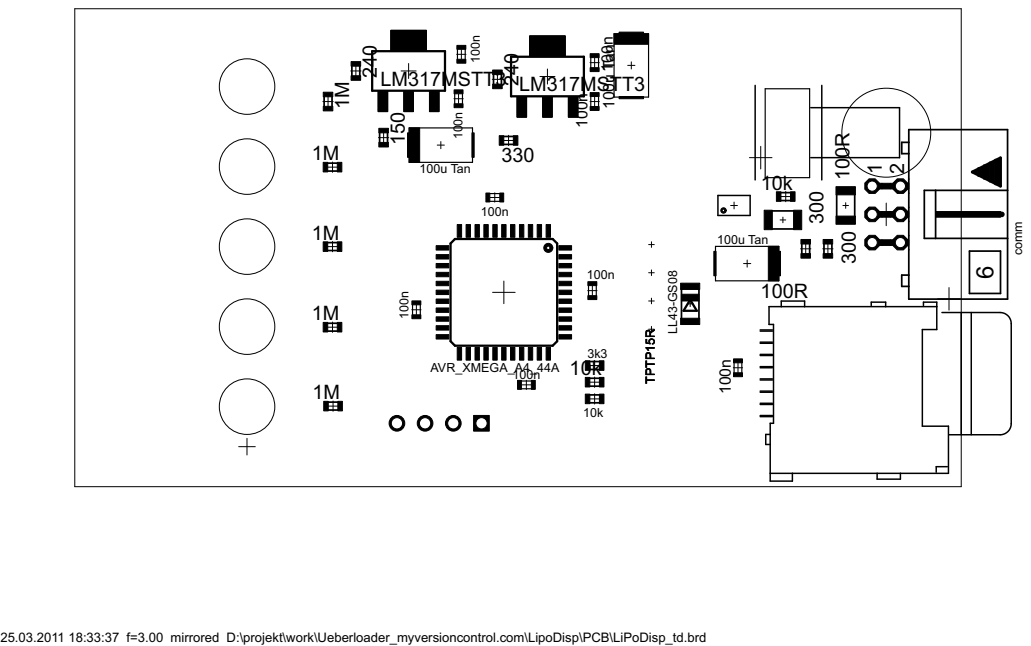
[picture p14: page 1]

25.03.2011 18:33:37 f=3.00 mirrored D:\projekt\work\Ueberloader_myversioncontrol.com\LipoDisp\PCB\LiPoDisp_td.brd
