fabianhu/ueberloader/LipoLoader/PCB/LiPoLoader_td_B.pdf

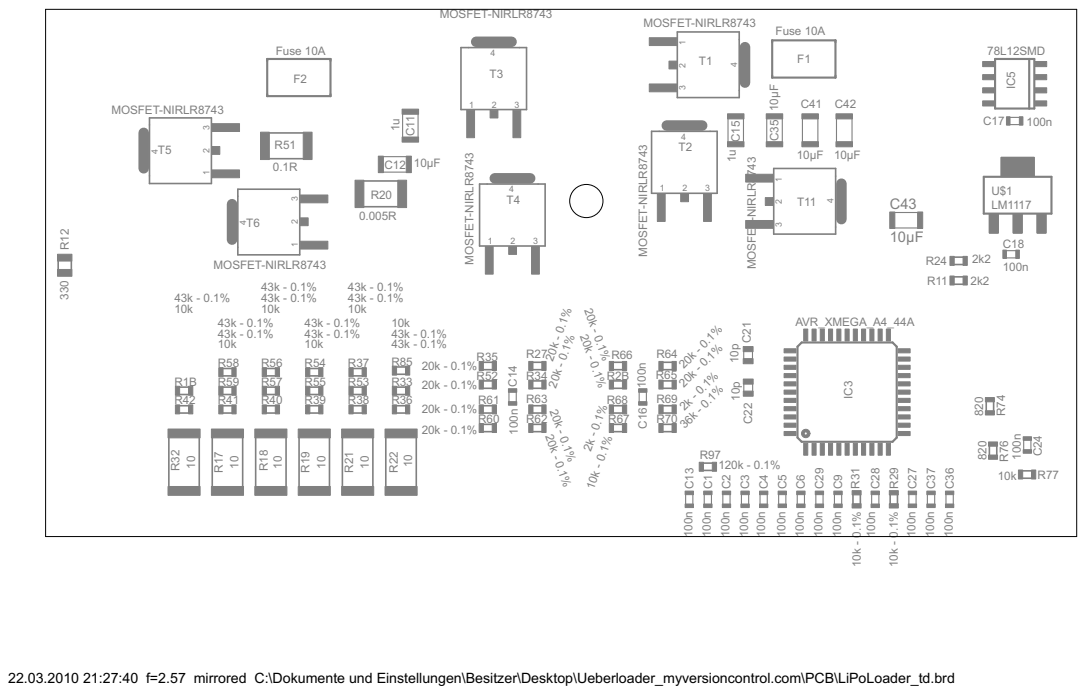
[picture p15: page 1]

22.03.2010 21:27:40 f=2.57 mirrored C:\Dokumente und Einstellungen\Besitzer\Desktop\Ueberloader_myversioncontrol.com\PCB\LiPoLoader_td.brd
