fabianhu/ueberloader/LipoLoader/PCB/LiPoLoader_td_T.pdf

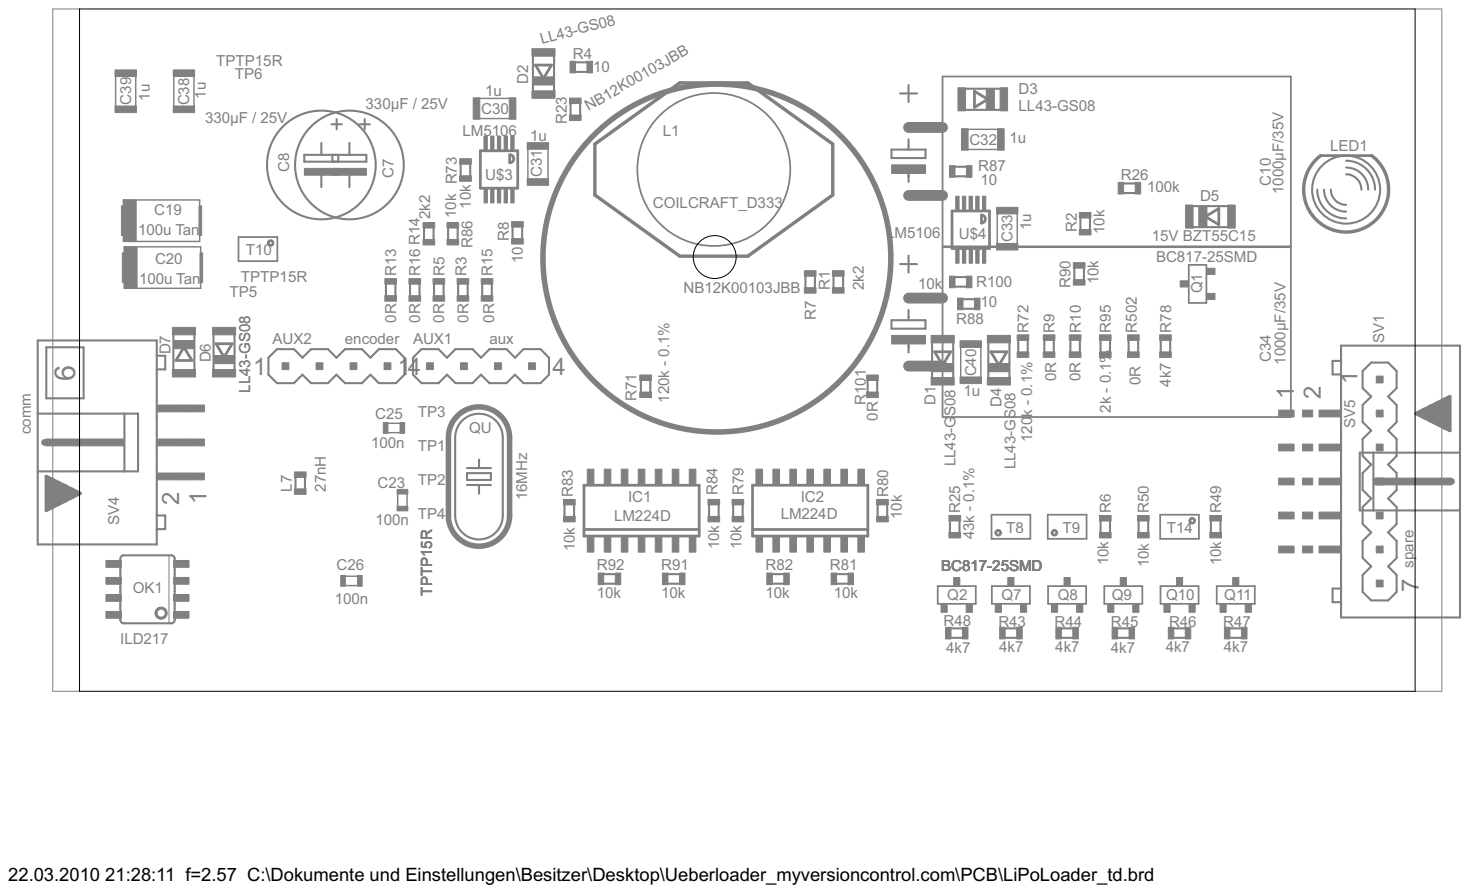
[picture p16: page 1]

22.03.2010 21:28:11 f=2.57 C:\Dokumente und Einstellungen\Besitzer\Desktop\Ueberloader_myversioncontrol.com\PCB\LiPoLoader_td.brd
