fabianhu/ueberloader/LipoDisp/PCB/disp_adapter.pdf

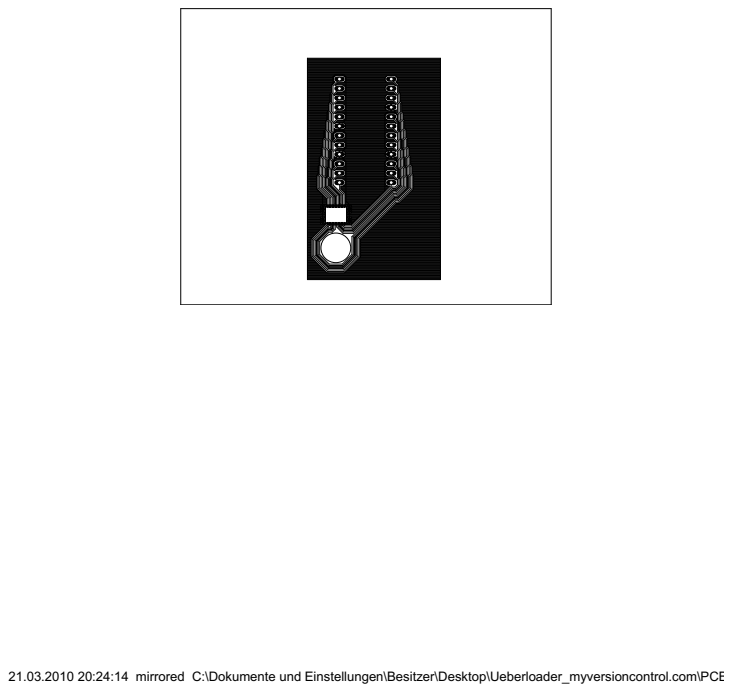
[picture p17: page 1]

21.03.2010 20:24:14 mirrored C:\Dokumente und Einstellungen\Besitzer\Desktop\Ueberloader_myversioncontrol.com\PCB\disp_adapter.brd
