fabianhu/ueberloader/LipoLoader/PCB/xmegaproto.pdf

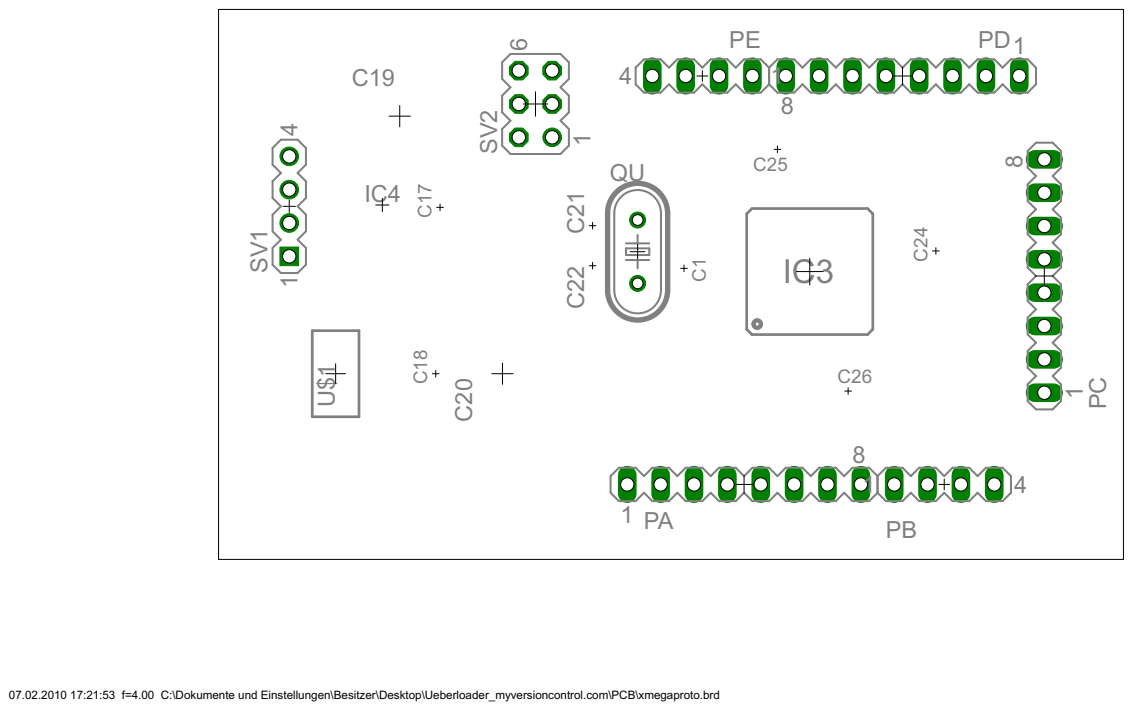
[picture p18: page 1]

07.02.2010 17:21:53 f=4.00 C:\Dokumente und Einstellungen\Besitzer\Desktop\Ueberloader_myversioncontrol.com\PCB\xmegaproto.brd
