fabianhu/ueberloader/LipoLoader/PCB/xmegaprotobk_mirr.pdf

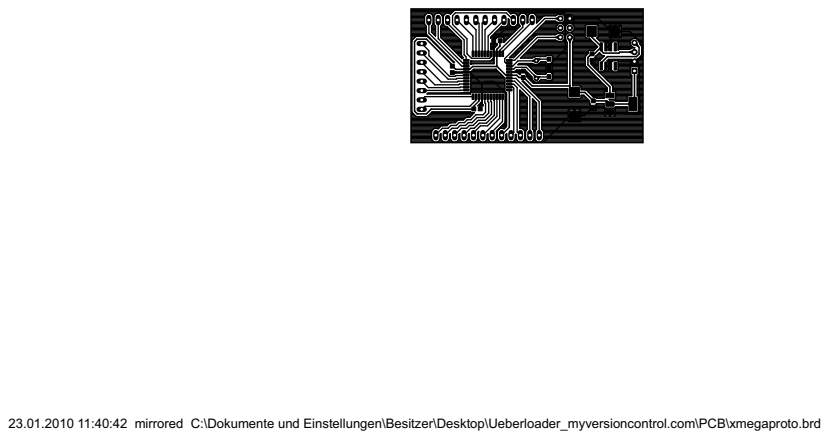
[picture p19: page 1]

23.01.2010 11:40:42 mirrored C:\Dokumente und Einstellungen\Besitzer\Desktop\Ueberloader_myversioncontrol.com\PCB\xmegaproto.brd
