fabianhu/ueberloader/doc/GEH.VLM.pdf

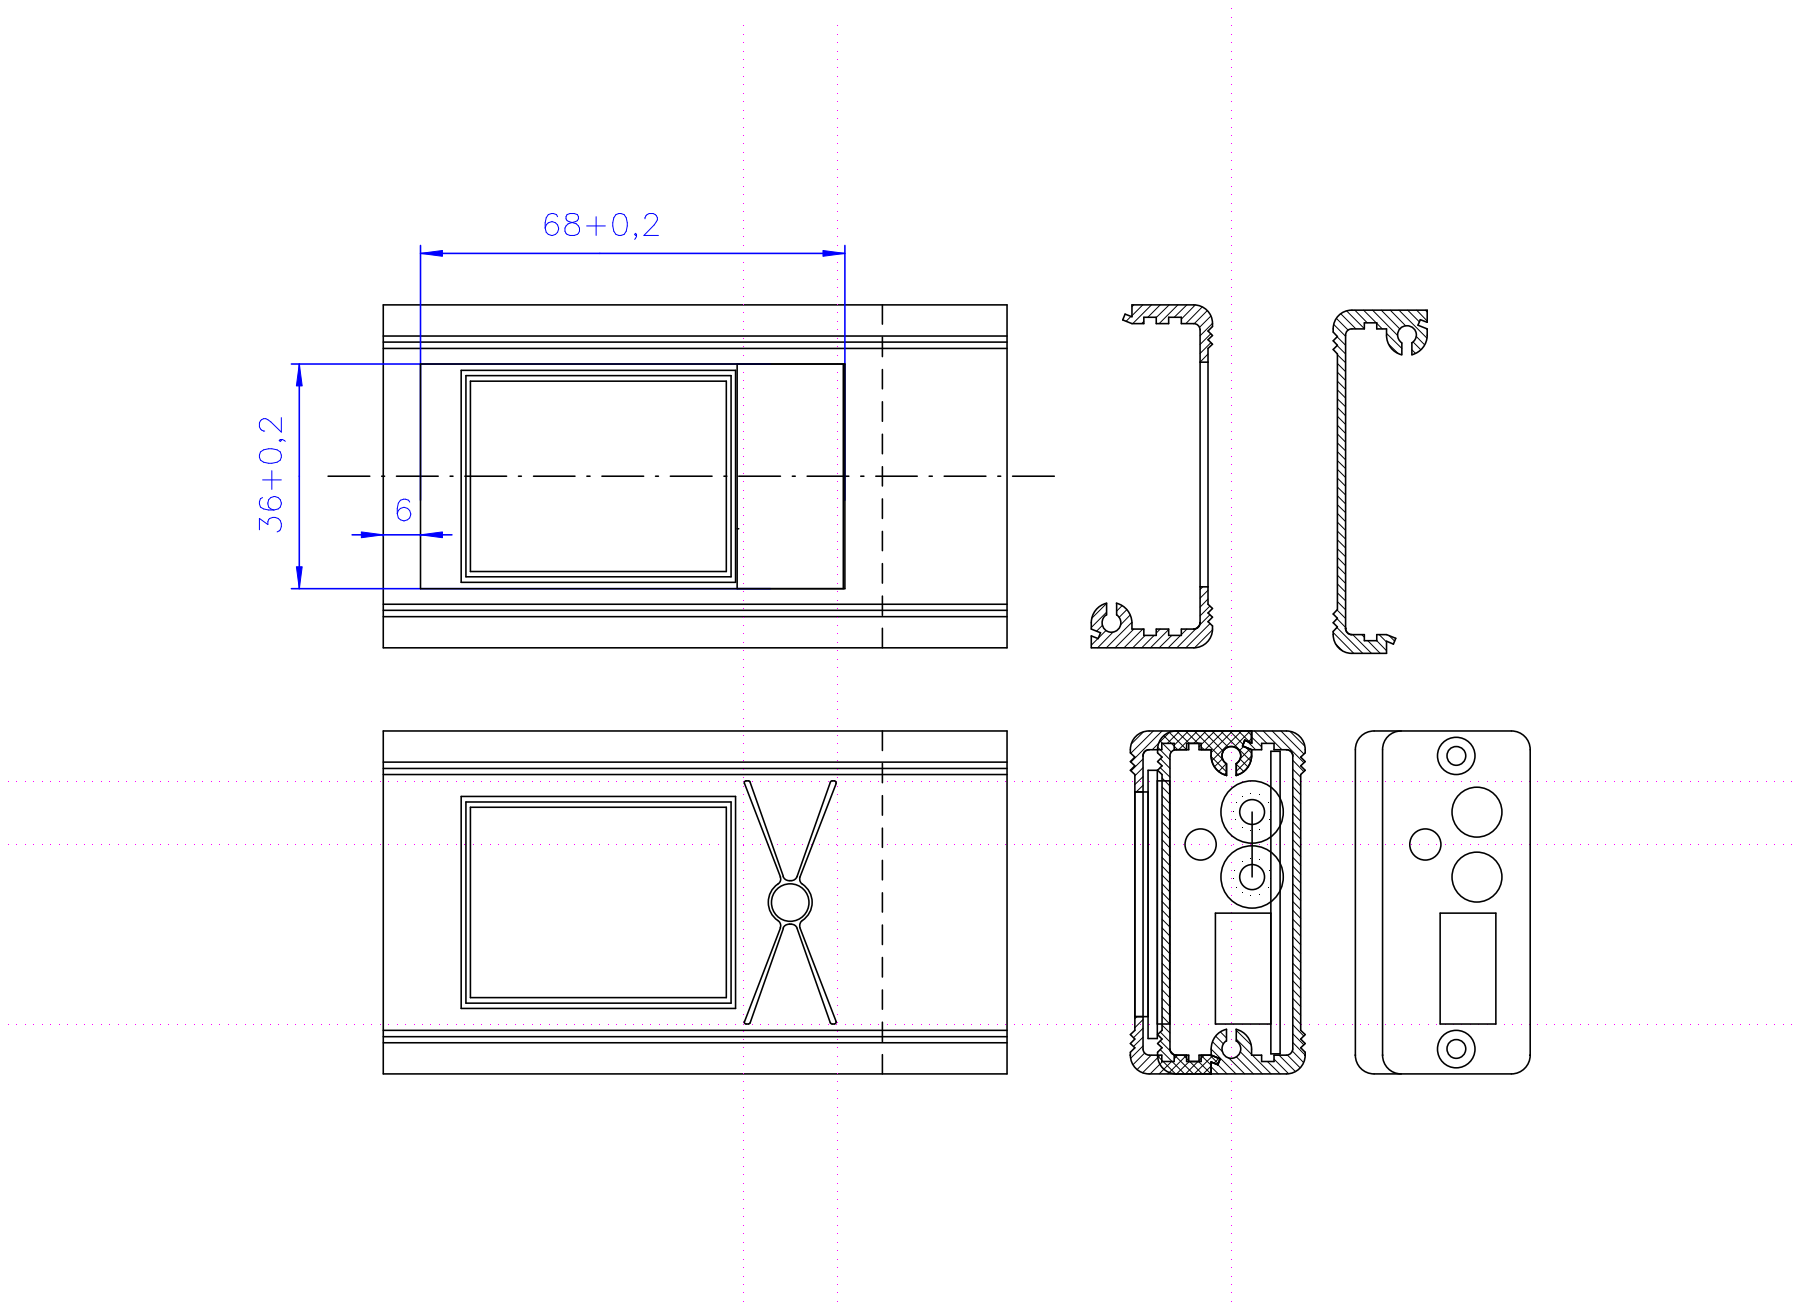
[picture p20: page 1]
