fabianhu/ueberloader/doc/top.pdf

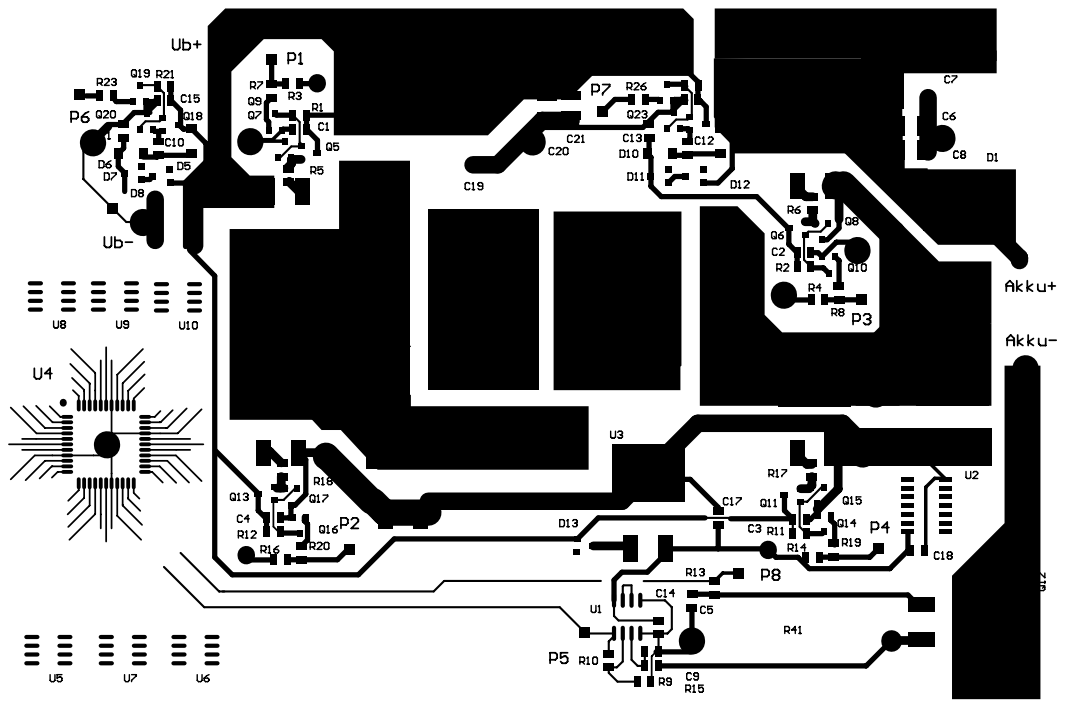
[picture p21: page 1]
