fabianhu/ueberloader/LipoDisp/PCB/touch.pdf

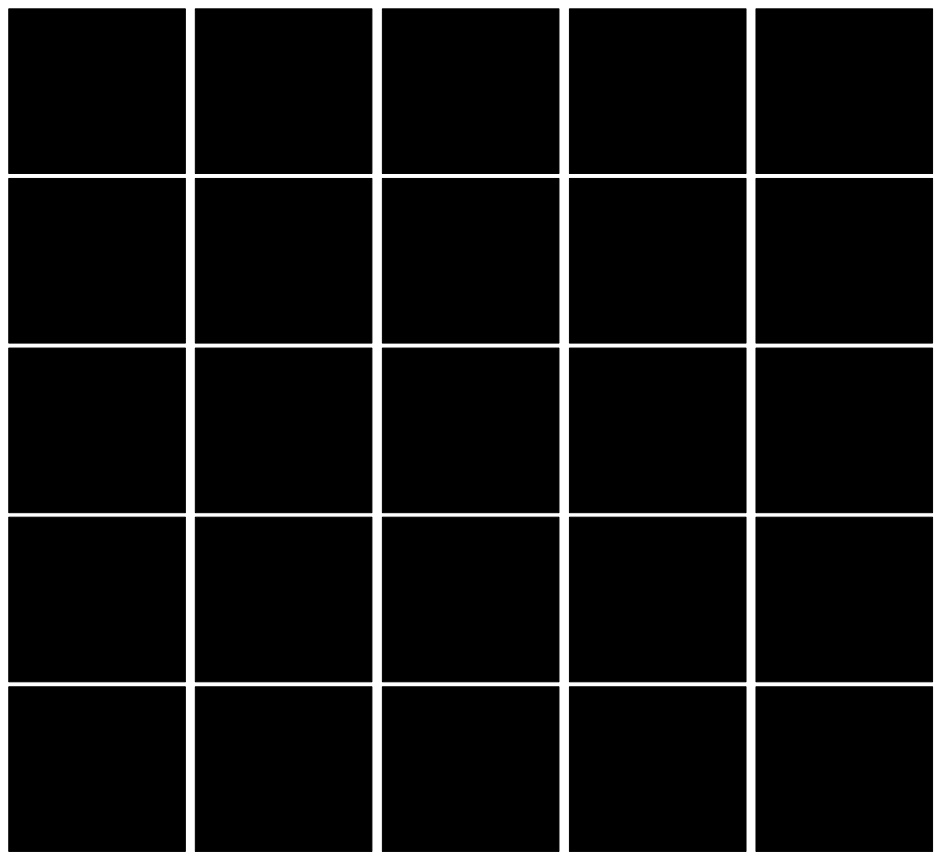
[picture p22: page 1]
