fabianhu/ueberloader/doc/kalibrator.asc

R1: res; 1k
R2: res; 4k7
R3: res; 1k
R4: res; 4k7
R5: res; 1k
R6: res; 4k7
R7: res; 1k
R8: res; 4k7
R9: res; 1k
R10: res; 4k7
R11: res; 1k
R12: res; 4k7
R13: res; 15k
R14: res; 15k
R15: res; 10k
R16: res; 4k7
R17: res; 2k2
U1: opamp
U2: opamp
U3: opamp
U4: opamp
U5: opamp
U6: opamp
U7: LT1021-5
U8: LT1021-5
U9: LT1021-5
U10: LT1021-5
U11: LT1021-5
U12: LT1021-5
V1: voltage; 30
Named nets: 0
.lib opamp.sub
.tran 1
