fabianhu/ueberloader/Calc/Differential measure.asc

R1: res; 47k
R2: res; 22k
R3: res; 47k
R4: res; 22k
U1: opamp
V1: voltage; SINE(2.1 2.1 10)
V2: voltage; SINE(5 4 3)
Named nets: 0
.lib opamp.sub
.tran 1
