fabianhu/ueberloader/Calc/Current measure.asc

I1: current; SINE(3 0.01 10)
I2: current; SINE(0 10 10)
R1: res; 0.105
R2: res; 10k
R3: res; 0.005
R4: res; 2k
R5: res; 36k
R6: res; 2k
R7: res; 2k
R8: res; 120k
U1: opamp
U2: opamp
V1: voltage; 3.3
Named nets: 0
.lib opamp.sub
.tran 1
