fabianhu/ueberloader/Calc/Volt measure.asc

R1: res; 120k
R2: res; 10k
R3: res; 120k
R4: res; 10k
V1: voltage; PWL(0 12 0.1 21.5)
V2: voltage; PWL(0 26 0.1 26.5)
Named nets: 0
.tran .1
