fabianhu/ueberloader/Calc/serial bus.asc

R1: res; 10k
R2: res; 820
U1: PC817A
V1: voltage; 3
V2: voltage; SINE(1.5 1.5 20)
Named nets: 0
.tran .1
