fabianhu/ueberloader/Calc/LTC3780.asc

C1: cap; 4.7µ
C2: cap; 100µ
C3: cap; .1µ
C4: cap; .1µ
C5: cap; .001µ
C6: cap; 2200p
C7: cap; .01µ
D1: schottky; BAT54
D2: schottky; BAT54
D3: schottky; 1N5817
D4: schottky; 1N5817
L1: ind; 2µ
Q1: nmos; IRF7831
Q2: nmos; IRF7831
Q3: nmos; IRF7831
Q4: nmos; IRF7831
R1: res; 7.5K
R2: res; 105K
R3: res; 10m
R4: res; 20K
R5: res; 10K
Rload: res; 5
U1: LTC3780
V1: voltage; PWL(0 0 0.2ms 5 1.0ms 5 1.4ms 15)
V2: voltage; SIN(1 1 250K)
V3: voltage; 10
Named nets: 0, IN, OUT
.tran 2m startup
