fabianhu/ueberloader/Calc/FET driver.asc

M1: pmos; IRF9Z24S_L
M2: nmos; IRF7832
Q1: pnp; BC807-25
Q2: npn; BC817-25
Q3: npn; BC817-25
Q4: pnp; BC807-25
Q5: npn; BC817-25
Q6: npn; BC817-25
R1: res; 4k7
R2: res; 470
R3: res; 3
R4: res; 4k7
R5: res; 470
R6: res; 3
V1: voltage; 12
V2: voltage; PULSE(0 5 0.01 10n 10n 0.01 .02)
V3: voltage; 12
V4: voltage; PULSE(0 5 0.01 10n 10n 0.01 .02)
Named nets: 0
.tran .1
