fabianhu/ueberloader/Calc/balancer_p.asc

M3: nmos; IRLR3802
M4: pmos; IRF7220
M5: pmos; IRF7220
Q1: npn
Q2: npn
R1: res; 10
R2: res; 10
R3: res; 10
R4: res; 10k
R5: res; 10k
R7: res; 4k7
R8: res; 4k7
V1: voltage; 3.8; Rser=0.1
V2: voltage; 3.8; Rser=0.1
V3: voltage; 3.8; Rser=0.1
V4: voltage; PULSE(0 5 0.05); Rser=0.1
Named nets: 0
.tran 0.1
