fabianhu/ueberloader/LipoLoader/PCB/LiPoLoader.brd

## EAGLE design LipoLoader/PCB/LiPoLoader.brd (2015-10-18)

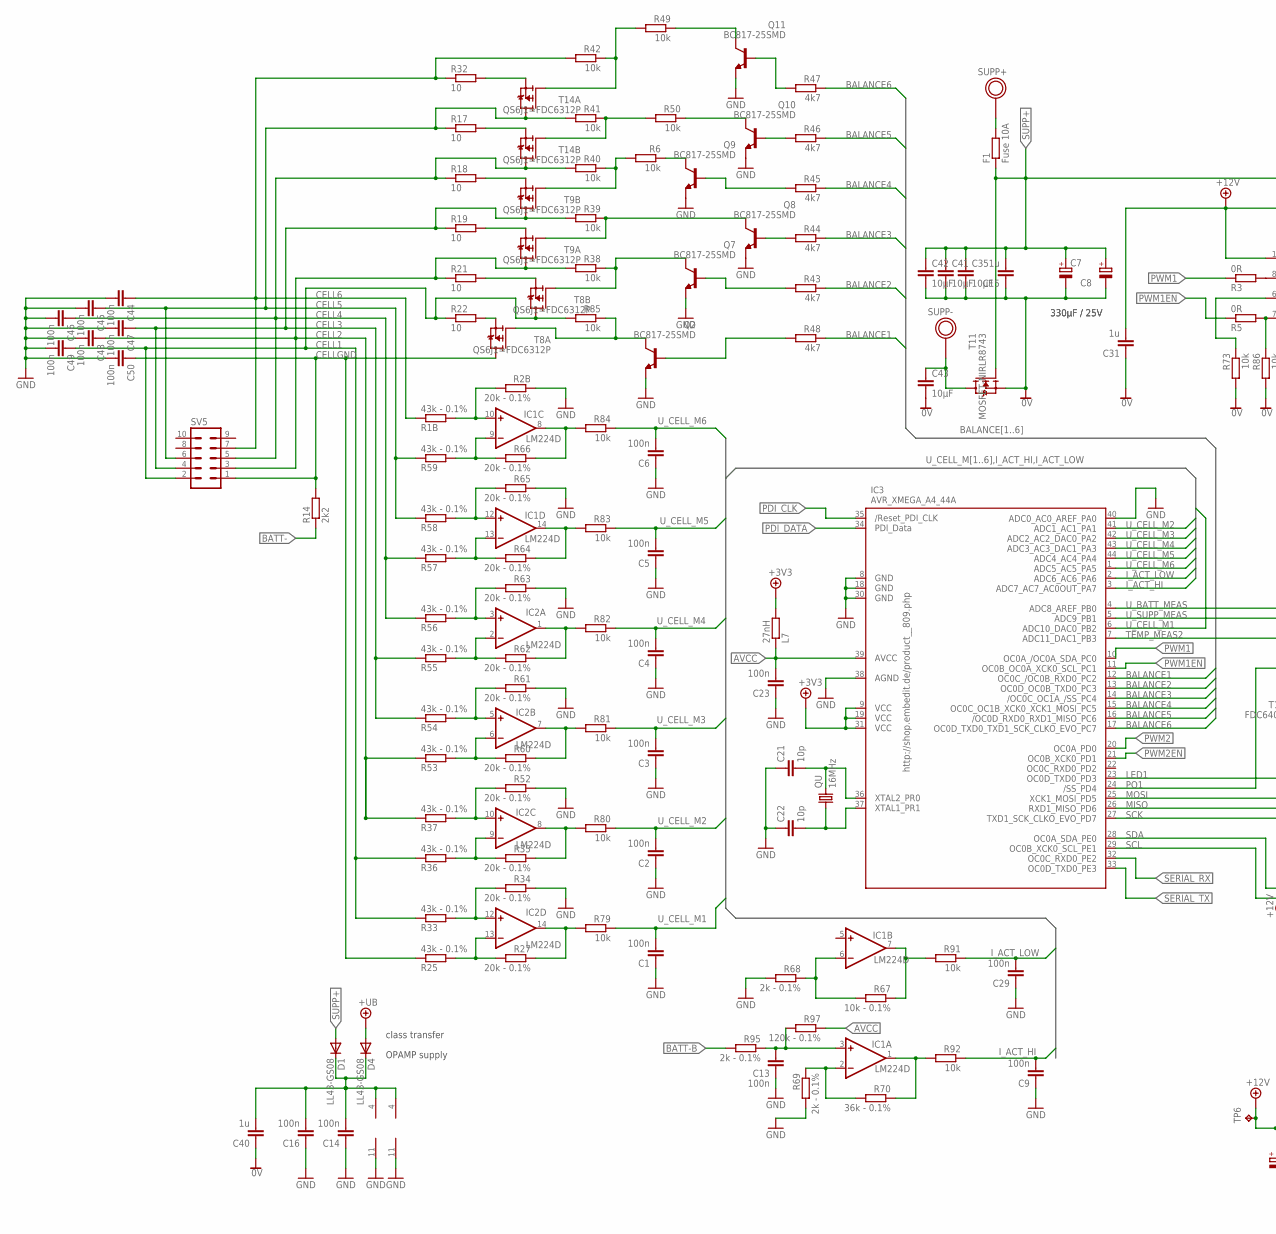
[picture p23: schematic LiPoLoader.sch, part in row 1, column 1]

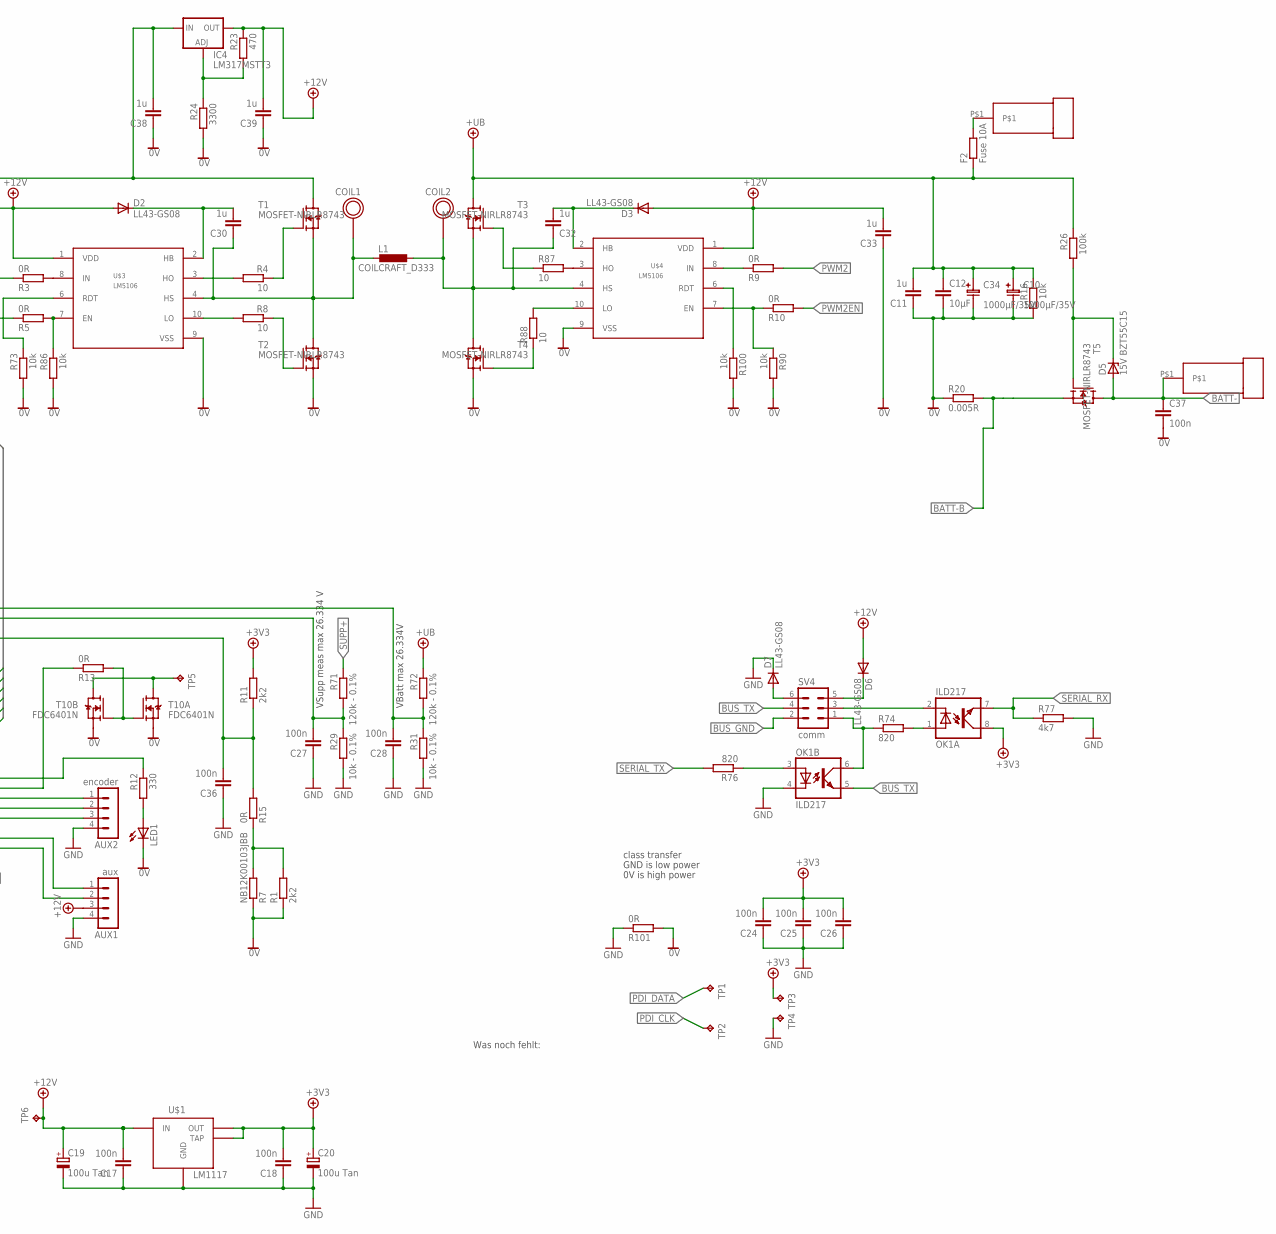
[picture p24: schematic LiPoLoader.sch, part in row 1, column 2]

Parts:
AUX1: aux; MA04-1
AUX2: encoder; MA04-1
C1, C2, C3, C4, C5, C6, C9, C13, C14, C16, C17, C18, C23, C24, C25, C26, C27, C28, C29, C36, C37, C44, C45, C46, C47, C48, C49, C50: 100n; C0603K
C7, C8: 330µF / 25V; E3,5-8
C10, C34: 1000µF/35V; E5-13-L
C11, C15, C30, C31, C32, C33, C38, C39, C40: 1u; C1206K
C12, C35, C41, C42, C43: 10µF; C1206K
C19, C20: 100u Tan; SMC_C
C21, C22: 10p; C0603
COIL1, COIL2: SOLPAD3MM
D1, D2, D3, D4, D6, D7: LL43-GS08; SOD80C
D5: 15V BZT55C15; SOD80C
F1, F2: Fuse 10A; WSC2515
IC1, IC2: LM224D; SO14
IC3: AVR_XMEGA_A4_44A; TQFP44
IC4: LM317MSTT3; SOT223
L1: COILCRAFT_D333; D333
L7: 27nH; R0603
LED1: LED5MM
OK1: ILD217; SOIC08
Q2, Q7, Q8, Q9, Q10, Q11: BC817-25SMD; SOT23-BEC
QU: 16MHz; HC49U-V
R1, R11, R14: 2k2; R0603
R1B, R25, R33, R36, R37, R53, R54, R55, R56, R57, R58, R59: 43k - 0.1%; R0603
R2B, R27, R34, R35, R52, R60, R61, R62, R63, R64, R65, R66: 20k - 0.1%; R0603
R3, R5, R9, R10, R13, R15, R101: 0R; R0603
R4, R8, R87, R88: 10; R0603
R6, R16, R38, R39, R40, R41, R42, R49, R50, R73, R79, R80, R81, R82, R83, R84, R85, R86, R90, R91, R92, R100: 10k; R0603
R7: NB12K00103JBB; R0603
R12: 330; R0805
R17, R18, R19, R21, R22, R32: 10; R2512
R20: 0.005R; R2010
R23: 470; R0603
R24: 3300; R0603
R26: 100k; R0603
R29, R31, R67: 10k - 0.1%; R0603
R43, R44, R45, R46, R47, R48, R77: 4k7; R0603
R68, R69, R95: 2k - 0.1%; R0603
R70: 36k - 0.1%; R0603
R71, R72, R97: 120k - 0.1%; R0603
R74, R76: 820; R0603
SUPP+: SOLPAD3MM
SUPP-: SOLPAD3MM
SV4: comm; ML6L
SV5: CON_BOX_10L; ML10L
T1, T2, T3, T4, T5, T11: MOSFET-NIRLR8743; DPAK
T8, T9, T14: QS6J1=FDC6312P; SUPERSOT-6
T10: FDC6401N; SUPERSOT-6
TP1, TP2, TP3, TP4, TP5, TP6: TPTP15R; TP15R
U$1: LM1117; SOT223
U$3, U$4: LM5106; MSOP10W
U$5, U$6: BUCHSE4MM; BUCHSE4MML

Connections:
0V: C7.-, C8.-, C10.-, C11.1, C12.2, C15.1, C31.1, C33.1, C34.-, C35.2, C37.2, C38.1, C39.1, C40.1, C41.2, C42.2, C43.2, LED1.K (C), R1.1, R7.1, R16.2, R20.1, R24.2, R73.2, R86.2, R90.2, R100.2, R101.2, T2.3 (S), T4.3 (S), T10.P$2 (S), T10.P$5 (S), T11.3 (S), U$3.9 (VSS), U$4.9 (VSS)
+3V3: C18.2, C20.+, C24.2, C25.2, C26.2, IC3.9 (VCC1), IC3.19 (VCC2), IC3.31 (VCC3), L7.2, OK1.8 (COL), R11.2, TP3.TP, U$1.MID (OUT), U$1.TAP
+12V: AUX1.3, C17.2, C19.+, C31.2, C33.2, C39.2, D2.A, D3.A, D6.A, IC4.4 (OUT), R23.1, TP6.TP, U$1.RIGHT (IN), U$3.1 (VDD), U$4.1 (VDD)
+UB: C10.+, C11.2, C12.1, C34.+, D4.A, F2.1, R16.1, R26.1, R72.1, T3.4 (D)
AVCC: C23.2, IC3.39 (AVCC), L7.1, R97.1
BALANCE1: IC3.12 (PC2), R48.1
BALANCE2: IC3.13 (PC3), R43.1
BALANCE3: IC3.14 (PC4), R44.1
BALANCE4: IC3.15 (PC5), R45.1
BALANCE5: IC3.16 (PC6), R46.1
BALANCE6: IC3.17 (PC7), R47.1
BATT-: C37.1, D5.A, R14.1, T5.4 (D), U$6.P$1
BATT-B: R20.2, R95.2, T5.3 (S)
BUS_GND: SV4.2
BUS_RX: OK1.2 (C), SV4.3
BUS_SUPP: OK1.6 (COL), R74.1, SV4.1
BUS_TX: OK1.5 (EMIT), SV4.4
CELL1: C49.1, R22.1, R33.1, R36.1, R85.2, SV5.2, T8.P$4 (D)
CELL2: C48.1, R21.1, R37.1, R38.2, R53.1, SV5.3, T9.P$6 (D)
CELL3: C47.1, R19.1, R39.2, R54.1, R55.1, SV5.4, T9.P$4 (D)
CELL4: C46.1, R18.1, R40.2, R56.1, R57.1, SV5.5, T14.P$4 (D)
CELL5: C45.1, R17.1, R41.2, R58.1, R59.1, SV5.6, T14.P$6 (D)
CELL6: C44.1, R1B.1, R32.1, R42.2, SV5.7
CELLGND: C50.1, R14.2, R25.1, SV5.1, T8.P$6 (D)
GND: AUX1.4, AUX2.4, C1.1, C2.1, C3.1, C4.1, C5.1, C6.1, C9.1, C13.1, C14.1, C16.1, C17.1, C18.1, C19.-, C20.-, C21.1, C22.1, C23.1, C24.1, C25.1, C26.1, C27.1, C28.1, C29.1, C36.1, C44.2, C45.2, C46.2, C47.2, C48.2, C49.2, C50.2, D7.C, IC1.11 (V-), IC2.11 (V-), IC3.8 (GND1), IC3.18 (GND2), IC3.30 (GND3), IC3.38 (AGND), IC3.40 (PA0), OK1.4 (C), Q2.E, Q7.E, Q8.E, Q9.E, Q10.E, Q11.E, R2B.1, R29.2, R31.2, R34.1, R52.1, R61.1, R63.1, R65.1, R68.2, R69.2, R77.2, R101.1, TP4.TP, U$1.LEFT (GND)
I_ACT_HI: C9.2, IC3.3 (PA7), R92.1
I_ACT_LOW: C29.2, IC3.2 (PA6), R91.1
I_RAW_HI_R: C13.2, IC1.3 (+IN), R95.1, R97.2
LED1: IC3.23 (PD3), R12.1
MISO: AUX2.2, IC3.26 (PD6)
MOSI: AUX2.1, IC3.25 (PD5)
unnamed: IC1.10 (+IN), R1B.2, R2B.2
unnamed: IC1.12 (+IN), R58.2, R65.2
unnamed: IC1.9 (-IN), R59.2, R66.2
unnamed: R8.1, T2.1 (G)
unnamed: R87.2, U$4.3 (HO)
unnamed: IC1.13 (-IN), R57.2, R64.2
unnamed: IC1.6 (-IN), R67.2, R68.1
unnamed: R100.1, U$4.6 (RDT)
unnamed: OK1.3 (A), R76.1
unnamed: IC2.3 (+IN), R56.2, R63.2
unnamed: IC2.2 (-IN), R55.2, R62.2
unnamed: R88.1, T4.1 (G)
unnamed: F2.2, U$5.P$1
unnamed: R4.2, U$3.3 (HO)
unnamed: IC2.5 (+IN), R54.2, R61.2
unnamed: IC2.6 (-IN), R53.2, R60.2
unnamed: IC2.12 (+IN), R33.2, R34.2
unnamed: D7.A, SV4.6
unnamed: LED1.A, R12.2
unnamed: IC2.10 (+IN), R37.2, R52.2
unnamed: IC2.9 (-IN), R35.2, R36.2
unnamed: IC2.13 (-IN), R25.2, R27.2
unnamed: OK1.1 (A), R74.2
unnamed: C32.1, COIL2.P$1, L1.2, T3.3 (S), T4.4 (D), U$4.4 (HS)
unnamed: R22.2, T8.P$5 (S)
unnamed: IC4.1 (ADJ), R23.2, R24.1
unnamed: IC1.2 (-IN), R69.1, R70.2
unnamed: IC1.8 (OUT), R66.1, R84.2
unnamed: C21.2, IC3.36 (PR0), QU.2
unnamed: C22.2, IC3.37 (PR1), QU.1
unnamed: T10.P$4 (D), T10.P$6 (D), TP5.TP
unnamed: IC1.7 (OUT), R67.1, R91.2
unnamed: C30.1, COIL1.P$1, L1.1, T1.3 (S), T2.4 (D), U$3.4 (HS)
unnamed: F1.2, SUPP+.P$1
unnamed: D5.C, R26.2, T5.1 (G)
unnamed: Q8.C, R39.1, T9.P$1 (G)
unnamed: Q9.C, R6.1
unnamed: R5.2, R86.1, U$3.7 (EN)
unnamed: R9.1, U$4.8 (IN)
unnamed: R13.2, T10.P$1 (G), T10.P$3 (G)
unnamed: R21.2, T8.P$2 (S)
unnamed: R19.2, T9.P$5 (S)
unnamed: IC1.14 (OUT), R64.1, R83.2
unnamed: R18.2, T9.P$2 (S)
unnamed: R17.2, T14.P$2 (S)
unnamed: R32.2, T14.P$5 (S)
unnamed: Q2.C, R85.1, T8.P$1 (G)
unnamed: Q7.B, R43.2
unnamed: Q8.B, R44.2
unnamed: Q9.B, R45.2
unnamed: Q10.B, R46.2
unnamed: Q11.B, R47.2
unnamed: IC2.1 (OUT), R62.1, R82.2
unnamed: R6.2, R40.1, T9.P$3 (G)
unnamed: R41.1, R50.2, T14.P$3 (G)
unnamed: R42.1, R49.2, T14.P$1 (G)
unnamed: Q7.C, R38.1, T8.P$3 (G)
unnamed: IC2.7 (OUT), R60.1, R81.2
unnamed: Q11.C, R49.1
unnamed: Q10.C, R50.1
unnamed: IC2.8 (OUT), R35.1, R80.2
unnamed: IC2.14 (OUT), R27.1, R79.2
unnamed: R1.2, R7.2, R15.1
unnamed: R8.2, U$3.10 (LO)
unnamed: R4.1, T1.1 (G)
unnamed: R3.2, U$3.8 (IN)
unnamed: R73.1, U$3.6 (RDT)
unnamed: C30.2, D2.C, U$3.2 (HB)
unnamed: IC1.1 (OUT), R70.1, R92.2
unnamed: R88.2, U$4.10 (LO)
unnamed: R87.1, T3.1 (G)
unnamed: R10.1, R90.1, U$4.7 (EN)
unnamed: C32.2, D3.C, U$4.2 (HB)
unnamed: D6.C, SV4.5
unnamed: Q2.B, R48.2
OPAMP_SUPP: C14.2, C16.2, C40.2, D1.C, D4.C, IC1.4 (V+), IC2.4 (V+)
PDI_CLK: IC3.35 (RESET), TP2.TP
PDI_DATA: IC3.34 (PDI_DATA), TP1.TP
PO1: IC3.24 (PD4), R13.1
PWM1: IC3.10 (PC0), R3.1
PWM1EN: IC3.11 (PC1), R5.1
PWM2: IC3.20 (PD0), R9.2
PWM2EN: IC3.21 (PD1), R10.2
SCK: AUX2.3, IC3.27 (PD7)
SCL: AUX1.2, IC3.29 (PE1)
SDA: AUX1.1, IC3.28 (PE0)
SERIAL_RX: IC3.32 (PE2), OK1.7 (EMIT), R77.1
SERIAL_TX: IC3.33 (PE3), R76.2
SUPP+: C7.+, C8.+, C15.2, C35.1, C38.2, C41.1, C42.1, D1.A, F1.1, IC4.3 (IN), R71.1, T1.4 (D), T11.1 (G)
SUPP-A: C43.1, SUPP-.P$1, T11.4 (D)
TEMP_MEAS2: C36.2, IC3.7 (PB3), R11.1, R15.2
U_BATT_MEAS: C28.2, IC3.4 (PB0), R31.1, R72.2
U_CELL_M1: C1.2, IC3.6 (PB2), R79.1
U_CELL_M2: C2.2, IC3.41 (PA1), R80.1
U_CELL_M3: C3.2, IC3.42 (PA2), R81.1
U_CELL_M4: C4.2, IC3.43 (PA3), R82.1
U_CELL_M5: C5.2, IC3.44 (PA4), R83.1
U_CELL_M6: C6.2, IC3.1 (PA5), R84.1
U_SUPP_MEAS: C27.2, IC3.5 (PB1), R29.1, R71.2

Notes on the sheet:
class transfer
0V is high power
GND is low power
OPAMP supply
Was noch fehlt:
VSupp meas max 26.334 V
VBatt max 26.334V

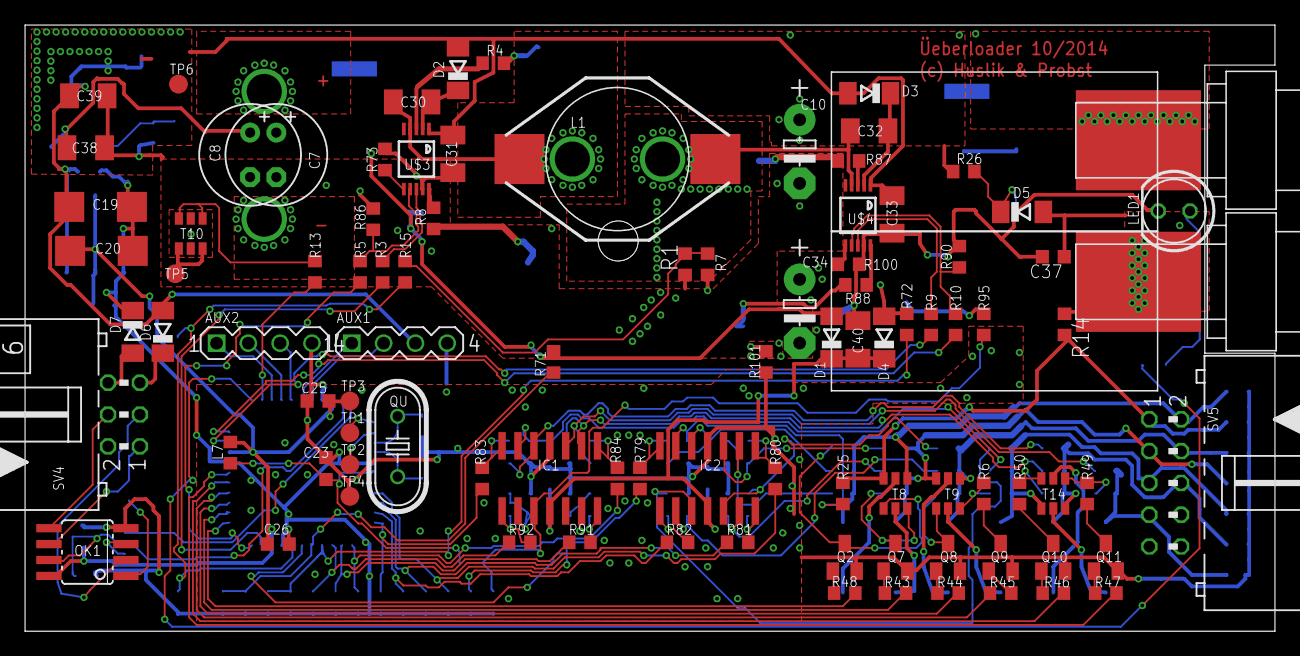
[picture p25: board LiPoLoader.brd from above]

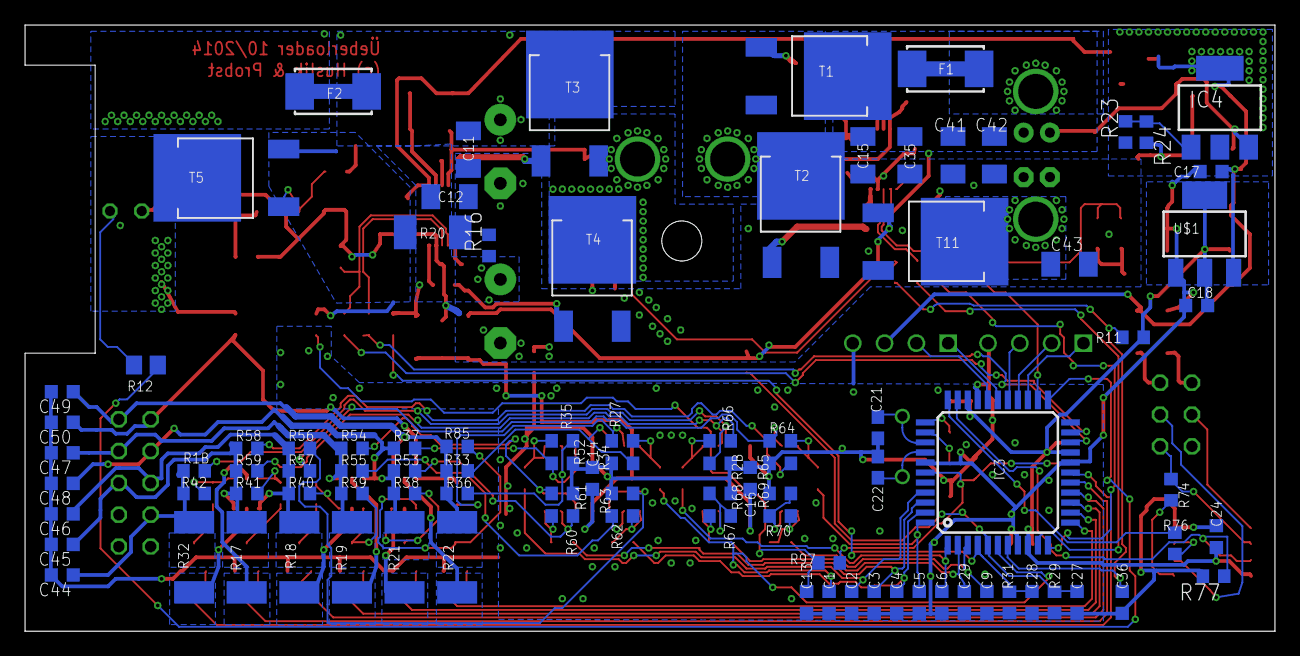
[picture p26: board LiPoLoader.brd from below]

Board: 2 copper layers, 99.8 x 48.4 mm, 195 parts (95 on the bottom side), 129 nets.

Other parts of the board:
U$2: GEH_FISCHER_AKG55XX100_BODEN
