fabianhu/ueberloader/LipoDisp/AVR/FabOS_config.h

/*
	FabOS for ATMEL AVR user configuration file
	
	(c) 2008-2010 Fabian Huslik
*/

// *********  USER Configurable Block BEGIN

#define OS_NUMTASKS 3 // Number of (OS_Create)Tasks ; never >8 (idle task is not counted here!)
#define OS_NUMMUTEX 3 // Number of Mutexes
#define OS_NUMALARMS 6 // Number of Alarms

#if defined (__AVR_ATmega32__)
	#define OS_ScheduleISR 			TIMER1_COMPA_vect // Interrupt Vector used for OS-tick generation (check out CustomOS_ISRCode if you want to add isr code)
	#define OS_ALLOWSCHEDULING 		TIMSK |= (1<<OCIE1A);	// turn Timer Interrupt ON
	#define OS_PREVENTSCHEDULING 	TIMSK &= ~(1<<OCIE1A); // turn Timer Interrupt OFF
#elif defined (__AVR_ATmega644P__)
	#define OS_ScheduleISR 			TIMER1_COMPA_vect
	#define OS_ALLOWSCHEDULING 		TIMSK1 |= (1<<OCIE1A);	// turn Timer Interrupt ON
	#define OS_PREVENTSCHEDULING 	TIMSK1 &= ~(1<<OCIE1A); // turn Timer Interrupt OFF
#elif defined (__AVR_ATxmega32A4__)
	#define OS_ScheduleISR 			TCC1_CCA_vect
//	#define OS_ALLOWSCHEDULING 		TCC1_INTCTRLB |= 3 ;//;	// turn Timer Interrupt ON
//	#define OS_PREVENTSCHEDULING 	TCC1_INTCTRLB &= ~3 ; // turn Timer Interrupt OFF
	#define OS_ALLOWSCHEDULING 		sei();//glTest = 0; TCC1.INTCTRLB |= 3 ;//;	// turn Timer Interrupt ON
	#define OS_PREVENTSCHEDULING 	cli();//glTest = 1; TCC1.INTCTRLB &= ~3 ; // turn Timer Interrupt OFF
	#define OS_XMEGA_OPT 0// only for larger (>128k parts)
#else
	#error "MCU Timer ISR not defined. Set correct ISR vector in FabOS_config.h"
#endif

#define OS_USECLOCK 1 		// Use "OS_GetTicks()" which returns a 32bit timer tick
#define OS_USECOMBINED 1 	// Use "OS_WaitEventTimeout()" which is easier to use, than combining alarms and events to get the functionality.
#define OS_USEEXTCHECKS 1	// prevent false use of API -> does not work, but no damage to OS stability.
#define OS_USEMEMCHECKS 1 	// Enable "OS_get_unused_Stack()" and "OS_GetQueueSpace()"
#define OS_UNUSEDMASK 0xAA  // unused Stack RAM will be filled with this byte, if OS_USEMEMCHECKS == 1.
#define OS_TRACE_ON  0 		// enable trace to OS_Tracebuffer[]
#define OS_TRACESIZE 100	// size of OS_Tracebuffer[] (depending on memory left ;-)

#define OS_TypeAlarmTick_t uint16_t // change this type to uint32_t, if you need longer wait time than 65535 OS ticks.

// Task definitions

#define OSTSKTouch  0
#define OSTSKCommand  1
#define OSTSKDisplay   2

// Event Names

#define OSEVTDataRecvd 1

// Mutex Names

#define OSMTXBattInfo 0
#define OSMTXCommand  1
#define OSMTXMENU	  2

// Alarm Names

#define OSALMWaitDisp     	0
#define OSALMCommandRepeat	1
#define OSALMCommandTimeout	2
#define OSALTouchRepeat 	3
#define OSALTouchPause	 	4


// *********  USER Configurable Block END 

#define OS_DO_TESTSUITE 0	// compile and execute the automated software tests. set to 0 for production use of OS.
