fabianhu/ueberloader/LipoLoader/AVR/ueberloader.c

/*
 This is the Üeberloader
 with N-channel high side driver

 (c) 2010 Fabian Huslik
 */

// Festlegung auf 25 Windungen bei 60kHz mit Spule aus BOM

// fixme Strommessung / Bereichsumschaltung HI ist FALSCH!
// fixme Beim Abschalten den Strom auf der Low-Side im Kreis laufen lassen, nicht alles abschalten
// fixme over voltage / disconnect of battery muss schneller abregeln!
// fixme Spannungs/strommessung über ISR - richtig schnell.
// fixme brown out fuse???
// fixme refresh erzeugt ripple auf dem EIngangsstrom. (sync und/oder shiften)

// todo kalibrierung der Gesamtspannungsmessung / Spannungsabfall über Shunt berücksichtigen -> war schon drin, checken.
// todo Frequenz auf 60kHz festnageln
// todo Leistungslimitierung auf 100W Ladeleistung / 10A
// todo Temperaturmessung / Limit
// todo balance only mode

// check refresh kürzer
// check Spannungs plausibilisierung unempfindlicher : OK
// check Balancer Limit aktiviert:
// check Balancer Algo verbessert:
// check refresh periode einstellbar
// check keine Kommandos während dem Laden möglich.
#include "OS/FabOS.h"
#include "ueberloader.h"
#include "adc.h"
#include "cal.h"
#include "pwm.h"
#include "usart.h"
#include "serial.h"
#include "eeprom.h"
#include "crc.h"
#include "filter.h"
#include "balancer.h"

//OS_DeclareQueue(DemoQ,10,4);
// Prototypes

// ******** Globals

Command_t g_tCommand;
Battery_Info_t g_tBattery_Info;

//uint16_t I_Max_ABS = 25000;
//volatile uint16_t g_I_filt;
extern uint8_t g_ParReady;
extern uint16_t pwm_us_period_H;
extern volatile uint8_t ADCwatchdog;

ChargerMode_t g_eChargerMode = eModeAuto;

// *********  Prototypes
uint8_t GetCellcount(void);
extern void emstop(uint8_t e);


#define GOVTEST 0



// ********* Stuff
void TaskGovernor(void)
{
	int16_t sU_in_act, sU_out_act;
	static int16_t sU_in_act_flt,sU_out_act_flt;
	static int16_t sI_out_act, sI_out_act_flt; // mV / mA
	static int16_t sZeroHiMeas;

	if(sizeof(Command_t) % 2 == 1) // Uli: fixme das scheint nicht zu funktionieren, weil unQ_max_mAs 32 bit war und deshalb nicht richtig gespeichert wurde
	{
		emstop( 4 ); // Command_t is not 16bit aligned. Not checkable at compile time.
	}

	if(eeprom_ReadBlockWCRC( (uint8_t*)&g_tCommand, EEPROM_COMMAND_START,
			sizeof(Command_t) ))
	{
		// set defaults: todo fill with useful values
		g_eChargerMode = eModeAuto;
		
		g_tCommand.sCurrentSetpoint = 1000;
		g_tCommand.ucUserCellCount = 6;
		g_tCommand.usVoltageSetpoint_mV = 3850;
		g_tCommand.unQ_max_mAh = 10000;
		g_tCommand.usT_max_min = 6000;
		g_tCommand.usMinBalanceVolt_mV = 3000;
		g_tCommand.refreshrate = 10;
		g_tCommand.SuppMin_mV = 10000;
	}

	g_ParReady = 1;

	vPWM_Init();
	ADCinit(); // call only in governor task

	OS_WaitTicks( OSALMWaitGov, 1 );
	// wait during timer sync

	PORTD.PIN1CTRL = 0b01000000; // invert Waveform at PORTD Pin1
	PORTC.DIRSET = 0b00000011; // set Port C as output
	PORTD.DIRSET = 0b00001011; // set Port D as output with LED

	ADC_ActivateHiCurrentMeas();

	//EVSYS.STROBE = ( 1 << 7 ); //fire event 7, which triggers the ADC
	OS_WaitTicks( OSALMWaitGov, 100 );
	// wait during first ADC conversion

	sZeroHiMeas = ADC_GetISRValue(2); // todo filter over several samples

	//ADC_ActivateLoCurrentMeas();
	Cal_init();

	OS_WaitTicks( OSALMWaitGov, 200 );
	// wait for first slow ADC loop...

	while(1)
	{
		if(ADCwatchdog == 0)
		{
			// re-enable the adc, which is (not) re-triggered by dma-isr
			EVSYS.STROBE = ( 1 << 7 ); //fire event 7, which triggers the ADC
			// or
			emstop(5);
		}
		ADCwatchdog = 0;


		OS_WaitTicks( OSALMWaitGov, 1 ); 
		// wait during ADC conversion

		sU_in_act = ADC_ScaleVolt_mV( ADC_GetISRValue(0) );
		sU_out_act = ADC_ScaleVolt_mV( ADC_GetISRValue(1) ); // corrected below!

						

						
		
		if(( ADCA.CH2.MUXCTRL & ( 0xf << 3 ) ) == ADC_CH_MUXPOS_PIN7_gc) // is high current config...
		{
			if (g_tBattery_Info.eState == eBattWaiting)		// zero wert setzen, wenn kein strom fließt
			sZeroHiMeas = ((sZeroHiMeas*5) + ADC_GetISRValue(2) +3)/6;
			
			// high current
			sI_out_act = ADC_ScaleHighAmp_mA( ADC_GetISRValue(2), sZeroHiMeas );
			// voltage measurement correction
			sU_out_act -= sI_out_act * 1 / 125; // High current resistor value (0.005R)(+3mR MosFet) * Current
			
		}
		else
		{
			// low current
			sI_out_act = ADC_ScaleLowAmp_mA( ADC_GetISRValue(2) )/2;
			// voltage measurement correction
			sU_out_act -= sI_out_act * 6 / 19; // Low current resistor value (0.105R) * Current
		}
		
		sFilterVar( &sU_out_act_flt, &sU_out_act, 16 );
		sFilterVar( &sU_in_act_flt, &sU_in_act, 16 );
		
//		if(sI_out_act > 2500)
			ADC_ActivateHiCurrentMeas();  
	//	else
		//	if(sI_out_act < 2000)
			//	ADC_ActivateLoCurrentMeas();

		sFilter( &sI_out_act_flt, &sI_out_act );

		int32_t nConverterPower_mW = ( ( sI_out_act )
				* ( sU_out_act /*- usU_in_act*/) ) / 1000;

		OS_MutexGet( OSMTXBattInfo );
		g_tBattery_Info.sActVoltage_mV = sU_out_act_flt;
		g_tBattery_Info.sActCurrent_mA = sI_out_act_flt;
		g_tBattery_Info.sSupplyVolt_mV = sU_in_act_flt;
		g_tBattery_Info.usConverterPower_W = (uint16_t)abs(nConverterPower_mW/1000);
		OS_MutexRelease( OSMTXBattInfo );

		// just in case...

		// supply undervoltage
		if(sU_in_act < 7000)
			emstop( 6 );
		// supply overvoltage
		if(sU_in_act > 24000)
			emstop( 7 );

		if(g_tBattery_Info.eState == eBattCharging)
		{
			if(sI_out_act > 10000 && abs(sI_out_act_flt) > 100)
				emstop( 8 );
		}

		static uint8_t errcntOverVolt = 0;
		if(sU_out_act > 4350 * g_tBattery_Info.ucNumberOfCells // FIXME war vorher auf 4250 aber mein Lader misst dermaßen falsch, wert auf 4350
				&& g_tBattery_Info.ucNumberOfCells >0
				&& g_tBattery_Info.eState == eBattCharging)
			errcntOverVolt++;
		else
			errcntOverVolt = 0;

		if(errcntOverVolt > 10)
			emstop( 9 ); // after 10 ms...

		OS_DISABLEALLINTERRUPTS;
//		int16_t myISetpoint = g_tCommand.sCurrentSetpoint;
		uint16_t myUSetpoint = g_tCommand.usVoltageSetpoint_mV	* g_tBattery_Info.ucNumberOfCells;
		g_tBattery_Info.sVSetpoint = myUSetpoint;
		OS_ENABLEALLINTERRUPTS;


		vGovernor( BalancerGetCurrentSetp(), sI_out_act );
		
	}
}

// do the stuff, which is to be done every second.
void TaskMonitor(void)
{

	OS_WaitTicks( OSALMonitorRepeat, 100 );
	// wait for ADC init

	OS_SetAlarm( OSALMonitorRepeat, 1000 );
	while(1)
	{
		OS_WaitAlarm( OSALMonitorRepeat );
		OS_SetAlarm( OSALMonitorRepeat, 1000 );
		// count the charged total Q
		if(g_tBattery_Info.eState == eBattCharging)
		{
			OS_MutexGet( OSMTXBattInfo );
			g_tBattery_Info.unCharge_mAs += g_tBattery_Info.sActCurrent_mA;
			g_tBattery_Info.unTimeCharging_s++;
			OS_MutexRelease( OSMTXBattInfo );
		}
	}
}

#define CELLDIFF_mV 300 // millivolt tolerance per cell to total voltage
#define MINCELLVOLTAGE_mV 2000 // minimum cell voltage
// Calculate cell count ; Return cell count. 0 = error
uint8_t GetCellcount(void) // fixme irgendwas, um zu erkennen, dass der Balancer-Stecker verrutscht ist.
{
	uint8_t i, ucCellCount = 0;
	uint16_t usUges_mV;
	int16_t diff;
	int16_t myCellVoltage[6];
	int16_t myBattVoltage;

	usUges_mV = 0;

	OS_MutexGet( OSMTXBattInfo );
	myBattVoltage = g_tBattery_Info.sActVoltage_mV;
	for(i = 0; i < 6 ; i++)
	{
		myCellVoltage[i] = g_tBattery_Info.Cells[i].sVoltage_mV;
	}
	OS_MutexRelease( OSMTXBattInfo );

	for(i = 0; i < 6 ; i++) // 0..5 iterate over possible cell count
	{
		if(myCellVoltage[i] > MINCELLVOLTAGE_mV)
		{
			if(ucCellCount < i) return 0; // there was a cell missing.
			usUges_mV += myCellVoltage[i]; // sum up cell voltage
			ucCellCount++;
		}
	}

	diff = usUges_mV - myBattVoltage;
	if(abs(diff) < CELLDIFF_mV * ucCellCount)
	{
		// correct!
		return ucCellCount;
	}
	else
	{
		// voltage error -> no exact match
		return 0;
	}

}

void ResetLastBatteryInfo(void)
{
	uint8_t i;
	OS_MutexGet( OSMTXBattInfo );
	g_tBattery_Info.unCharge_mAs = 0;
	g_tBattery_Info.unCharge_mWs = 0;
	g_tBattery_Info.unTimeCharging_s = 0;
	for(i = 0; i < 6 ; ++i)
	{
		g_tBattery_Info.Cells[i].unDisCharge_mAs = 0;
		g_tBattery_Info.Cells[i].unDisCharge_mWs = 0;
	}

	OS_MutexRelease( OSMTXBattInfo );
}

#define CHARGEDELAY 5 // equals 0,5s
void TaskState(void)
{
	uint8_t i, j, t, to, offsetRestart;
	static uint8_t BattFullDelayCounter;

	OS_WaitTicks( OSALMStateWait, 500 );

	while(1)
	{
		OS_WaitEvent( OSEVTState );

		uint8_t NumberOfCells = 0;

		OS_MutexGet( OSMTXBattInfo );
//		uint16_t myBattVoltage = g_tBattery_Info.sActVoltage_mV;
		int16_t myBattCurrent = g_tBattery_Info.sActCurrent_mA;
		int16_t mySuppVoltage = g_tBattery_Info.sSupplyVolt_mV;

		uint16_t myBattSumVoltage=0;
		uint16_t myBattMaxCellVoltage=0;
		for(i=0;i<g_tBattery_Info.ucNumberOfCells;i++)
		{
			myBattSumVoltage+= g_tBattery_Info.Cells[i].sVoltage_mV;									// Ermittlung der Akku-Gesamtspannung
			myBattMaxCellVoltage = max(g_tBattery_Info.Cells[i].sVoltage_mV,myBattMaxCellVoltage);		// Ermittlung der höchsten Zellspannung
		}
		OS_MutexRelease( OSMTXBattInfo );


		OS_MutexGet( OSMTXCommand );
		uint16_t usCommandCurrent = g_tCommand.sCurrentSetpoint;
		OS_MutexRelease( OSMTXCommand );


		if (mySuppVoltage < g_tCommand.SuppMin_mV )
			g_tBattery_Info.eState = eBattSupplyUntervolt;
		

		switch(g_tBattery_Info.eState)
		{
			case eBattWaiting:
				// nicht vollständig angesteckt

				switch(g_eChargerMode)
				{
					case eModeAuto:
						// charge if ok.
						j = 0;
						to = GetCellcount();
						for(i = 0; i < CHARGEDELAY ; i++)
						{
							OS_WaitTicks( OSALMStateWait, 100 );
							// sums up to 1s
							t = GetCellcount();
							if(t == to)
								j++;
							to = t;
						}

						NumberOfCells = GetCellcount();
						if(NumberOfCells > 0 && j == CHARGEDELAY) // it was equal for 1s...
						{
							// safe the actual setting, which is used to charge
							eeprom_WriteBlockWCRC((uint8_t*)&g_tCommand, EEPROM_COMMAND_START, sizeof(Command_t));

							PWM_Setfrequency(60); // in kHz!!!
							PWM_SetRatio(g_tCommand.refreshrate);
							
							OS_WaitTicks( OSALMStateWait, 100 );
							g_tBattery_Info.ucNumberOfCells = NumberOfCells;
							g_tBattery_Info.eState = eBattCharging;
							ResetLastBatteryInfo();
						}
						break;
					case eModeManual:
						// Manual mode
						if(GetCellcount() == g_tCommand.ucUserCellCount
								&& g_tCommand.ucUserCellCount > 0) // todo manual mode aktivieren
						{
							OS_WaitTicks( OSALMStateWait, 100 );
							g_tBattery_Info.ucNumberOfCells =
									g_tCommand.ucUserCellCount;
							g_tBattery_Info.eState = eBattCharging;
							ResetLastBatteryInfo();
						}
						else
						{
							g_tBattery_Info.eState = eBattError; // set Error for Display
						}
						break;
					case eModeStop:
						// Manual Stop mode
						// how to get out of here? -> the mode is set manually to another.
						break;
					default:
						break;
				}
				break;
			case eBattCharging:
				// Charging!
				switch(g_eChargerMode)
				{
					case eModeManual: // todo NOT YET IMPEMENTED
					case eModeAuto:
						if (g_tCommand.usMinBalanceVolt_mV < g_tCommand.usVoltageSetpoint_mV)
						{	// wenn balanced geladen wird
							if(myBattSumVoltage	>= ((g_tCommand.usVoltageSetpoint_mV - 1)	* g_tBattery_Info.ucNumberOfCells)		// Wenn Abschaltspannung erreicht
								&& Balancer_GetFinished()																			// wenn der Balancer fertig ist --> es kann abgeschalten werden
								&& (myBattCurrent < usCommandCurrent / 20 || myBattCurrent < 30))									// wenn Iist < Isoll / 20
							{
								BattFullDelayCounter++;
							}
							else
							{
								BattFullDelayCounter = 0;						
							}
						}
						else
						{	// wenn unbalanced geladen wird
							if(myBattMaxCellVoltage	>= (g_tCommand.usVoltageSetpoint_mV - 1)					// Wenn die Zelle mit der höchsten Spannung die Abschaltspannung erreicht
							&& (myBattCurrent < usCommandCurrent / 20 || myBattCurrent < 30))					// wenn Iist < Isoll / 20
							{
								BattFullDelayCounter++;
							}
							else
							{
								BattFullDelayCounter = 0;
							}
						}
						if (BattFullDelayCounter >= 10)										// Zeitverzögerung
						{
							g_tBattery_Info.eState = eBattFull;								// Akku voll
							BattFullDelayCounter = 0;
						}

						if (g_tBattery_Info.unCharge_mAs / 3600 >= g_tCommand.unQ_max_mAh)	//Maximale Kapazität erreicht
						{
							g_tBattery_Info.eState = eBattMaxCap;
						}
						if (g_tBattery_Info.unTimeCharging_s / 60  >= g_tCommand.usT_max_min)	//Maximale Ladezeit erreicht
						{
							g_tBattery_Info.eState = eBattMaxTime;
						}
						if(GetCellcount() != g_tBattery_Info.ucNumberOfCells)
						{
							g_tBattery_Info.ucNumberOfCells = 0;
							g_tBattery_Info.eState = eBattUnknown;
						}
						break;
					case eModeStop:
						// Manual Stop mode
						g_tBattery_Info.eState = eBattWaiting;
						// how to get out of here? -> the mode is set manually to another.
						break;
					default:
						break;
				}
				break;

				//		case eBattEmpty:
				//			// vollständig angesteckt, Sollwert nicht erreicht
				//			if(1/*all cells >= setpoint*/)
				//				eBattState = eBattFull;
				//			break;
			case eBattFull:
				// vollständig geladen, Sollwert erreicht
				if(GetCellcount() != g_tBattery_Info.ucNumberOfCells)		// wenn Akku abgesteckt wird
				{
					g_tBattery_Info.ucNumberOfCells = 0;
					g_tBattery_Info.eState = eBattUnknown;
				}
				if(g_tCommand.usMinBalanceVolt_mV < g_tCommand.usVoltageSetpoint_mV) {offsetRestart = 4;} else { offsetRestart = 15; }  // Wenn unbalanced geladen wird, schaltet der Lader nicht so schnell wieder auf laden
				if(myBattSumVoltage	< (g_tCommand.usVoltageSetpoint_mV - offsetRestart)	* g_tBattery_Info.ucNumberOfCells)				// Wenn die Einzelzellenspannungen um die Spannung "offsetRestart" unter der Sollspannung liegt, wird wieder weiter geladen 
				{
					g_tBattery_Info.eState = eBattCharging;
				}
				break;
								
			case eBattMaxCap:
				// maximale Kapazität geladen
				if(GetCellcount() != g_tBattery_Info.ucNumberOfCells)
				{
					g_tBattery_Info.ucNumberOfCells = 0;
					g_tBattery_Info.eState = eBattUnknown;
				}
				break;
						
			case eBattMaxTime:
				// maximale Ladezeit erreicht
				if(GetCellcount() != g_tBattery_Info.ucNumberOfCells)
				{
					g_tBattery_Info.ucNumberOfCells = 0;
					g_tBattery_Info.eState = eBattUnknown;
				}
				break;	

			case eBattUnknown:
				OS_WaitTicks( OSALMStateWait, 100 );
				g_tBattery_Info.eState = eBattWaiting;
				break;

			case eBattSupplyUntervolt:
				OS_WaitTicks( OSALMStateWait, 1000 );
				if (mySuppVoltage > g_tCommand.SuppMin_mV + 500)
					g_tBattery_Info.eState = eBattWaiting;
				break;

			case eBattError:
				OS_WaitTicks( OSALMStateWait, 10000 );
				//g_eChargerMode = eActModeStop;
				g_tBattery_Info.eState = eBattWaiting;
				break;
			default:
				emstop( 10 );
				break;

		}
	}
}
