fabianhu/ueberloader/LipoLoader/AVR/adc.c

/*
	This is the Üeberloader ADC

	(c) 2010 Fabian Huslik

*/

#include <avr/io.h>
#include <avr/interrupt.h>
#include <avr/pgmspace.h>

#include "OS/FabOS.h"
#include "adc.h"
#include "cal.h"
#include "serial.h"


volatile int16_t g_asADCDMAvalues[3];
int16_t ADCZeroOffset; // static correction of 0-value of ADC

extern void emstop(uint8_t e);

/*! \brief Function for GCC to read out calibration byte.
 *
 *  \note For IAR support, include the adc_driver_asm.S90 file in your project.
 *
 *  \param index The index to the calibration byte.
 *
 *  \return Calibration byte.
 */
uint8_t SP_ReadCalibrationByte( uint8_t index )
{
	uint8_t result;

	/* Load the NVM Command register to read the calibration row. */
	NVM_CMD = NVM_CMD_READ_CALIB_ROW_gc;
 	result = pgm_read_byte(index);

	/* Clean up NVM Command register. */
 	NVM_CMD = NVM_CMD_NO_OPERATION_gc;

	return result;
}


/*! \brief This function get the calibration data from the production calibration.
 *
 *  The calibration data is loaded from flash and stored in the calibration
 *  register. The calibration data reduces the non-linearity error in the adc.
 *
 *  \param  adc          Pointer to ADC module register section.
 */
void ADC_CalibrationValues_Load(ADC_t * adc)
{
	if(&ADCA == adc){
		 /* Get ADCACAL0 from production signature . */
		adc->CALL = SP_ReadCalibrationByte( PROD_SIGNATURES_START + ADCACAL0_offset );
		adc->CALH = SP_ReadCalibrationByte( PROD_SIGNATURES_START + ADCACAL1_offset );
	}else {
		/* Get ADCBCAL0 from production signature  */
		adc->CALL = SP_ReadCalibrationByte( PROD_SIGNATURES_START + ADCBCAL0_offset );
		adc->CALH = SP_ReadCalibrationByte( PROD_SIGNATURES_START + ADCBCAL1_offset );
	}
}

void ADCinit(void)
{
	int16_t temp;

	// ADC concept new:
	/* CH0..2 : event triggered conversion of input and output voltage and Current - resulting in DMA0 ISR.
	 * CH3 : VCC_mVolt / zero offset / temperature internal / temperature external and Balancer channels -- cyclic
	 * */

	/* Move stored calibration values to ADC A. */
	ADC_CalibrationValues_Load(&ADCA);

	g_tCalibration.usCPUTemp85C = SP_ReadCalibrationByte( PROD_SIGNATURES_START + 0x2f )<<8;
	g_tCalibration.usCPUTemp85C |= SP_ReadCalibrationByte( PROD_SIGNATURES_START + 0x2e );

	/* Set up ADC A to have signed conversion mode and 12(11) bit resolution. */
	ADCA.CTRLA = 0b00000000;
	ADCA.CTRLB = 0b00010000; // signed !

	/* Set sample rate */
	ADCA.PRESCALER = ADC_PRESCALER_DIV512_gc;// resulting in 62,5 kHz !!! ADC clock (maximum slowed down for accuracy)

	/* Set reference voltage on ADC A to be VCC_mVolt/1.6 V.*/
	ADCA.REFCTRL = ADC_REFSEL_VCC_gc | ADC_TEMPREF_bm | ADC_BANDGAP_bm; // VCC_mVolt/1.6 reference

	ADCA.EVCTRL = ADC_SWEEP_012_gc | ADC_EVSEL_7_gc | ADC_EVACT_SWEEP_gc; // Event 7 triggers sweep over ch 0-2



	ADCA.CH0.CTRL = ADC_CH_INPUTMODE_DIFF_gc;
	ADCA.CH0.MUXCTRL = 0x09<<3 ;// ADC_CH_MUXPOS_PIN9_gc; Supply
	ADCA.CH0.INTCTRL = 0; // no ISR

	ADCA.CH1.CTRL = ADC_CH_INPUTMODE_DIFF_gc;
	ADCA.CH1.MUXCTRL = 0x08<<3 ;// ADC_CH_MUXPOS_PIN8_gc; Battery
	ADCA.CH1.INTCTRL = 0; // no ISR

	ADCA.CH2.CTRL = ADC_CH_INPUTMODE_DIFF_gc;
	ADCA.CH2.MUXCTRL = ADC_CH_MUXPOS_PIN6_gc ; // actual current
	ADCA.CH2.INTCTRL = 0; // no ISR

	ADCA.CH3.CTRL = ADC_CH_INPUTMODE_DIFF_gc;
	ADCA.CH3.MUXCTRL = ADC_CH_MUXPOS_PIN0_gc ;
	ADCA.CH3.INTCTRL = 0; // no ISR


	ADCA.CTRLA |= ADC_ENABLE_bm;
	//ADCA.CTRLA |= ADC_DMASEL_CH0123_gc; // check, if necessary: it is not.
	
	ADCA.CH0.CTRL |= ADC_CH_START_bm;
	/* Wait until common mode voltage is stable. */
	do{
		/* If the conversion on the ADCA channel 0 never is
		 * complete this will be a deadlock. */
	}while(!(ADCA.CH0.INTFLAGS & 1));
	ADCA.INTFLAGS = 0b00001111; // clear interrupt flags

 // setup DMA to transfer 3 successive conversions of ch 0-2 to the g_asADCvalues array.

	//DMA.INTFLAGS = DMA_CH_TRNINTLVL_HI_gc;
	DMA.CH0.SRCADDR0 = (int)(&ADCA.CH0RES) & 0xff;
	DMA.CH0.SRCADDR1 = ((int)(&ADCA.CH0RES) & 0xff00)>>8;
	DMA.CH0.SRCADDR2 = ((int)(&ADCA.CH0RES) & 0xff0000)>>16;
	DMA.CH0.DESTADDR0 = (int)(&g_asADCDMAvalues[0]) & 0xff;
	DMA.CH0.DESTADDR1 = ((int)(&g_asADCDMAvalues[0]) & 0xff00)>>8;
	DMA.CH0.DESTADDR2 = ((int)(&g_asADCDMAvalues[0]) & 0xff0000)>>16;
	DMA.CH0.CTRLA = DMA_CH_BURSTLEN_2BYTE_gc | DMA_CH_SINGLE_bm;//0b00000001;
	DMA.CH0.CTRLB = DMA_CH_TRNINTLVL_HI_gc; // Hi isr for complete
	DMA.CH0.ADDRCTRL = DMA_CH_SRCRELOAD_BLOCK_gc | DMA_CH_SRCDIR_INC_gc | DMA_CH_DESTRELOAD_TRANSACTION_gc | DMA_CH_DESTDIR_INC_gc;//0b01011101;
	DMA.CH0.TRIGSRC = DMA_CH_TRIGSRC_ADCA_CH2_gc; // Channel 2 triggers DMA. (attention: channel 4 does not exist!!!)
	DMA.CH0.TRFCNT = 6; // 3 ADC-values with 16 bit
	DMA.CH0.REPCNT = 1;
	DMA.CH0.CTRLA |= DMA_CH_ENABLE_bm;

	DMA.CTRL |= DMA_ENABLE_bm;
	//ADCA.CTRLA |= 0b00111100; // start conversion for 4 channels

	// configure curr_sense_switch
	PORTD.DIRSET = 1<<2;
	ADC_ActivateLoCurrentMeas();

	// Event 7 triggers ADC sweep
	EVSYS.STROBE = (1<<7); // dummy conversion = enable continuous firing by dma-isr (ADC-DMA-ISR-EVENT-ADC)

	// Get offset value for ADC A.
	OS_WaitTicks(OSALMWaitGov,1);

	ADC_StartConvCh3Pin(0); // measure offset of GND with GND // todo cyclic??

	OS_WaitTicks(OSALMWaitGov,5);

	temp = ADCA.CH3.RES;
	if(temp < 10 && temp > -10 )
		ADCZeroOffset = temp;
	else
		emstop(1);
}

void ADC_ActivateHiCurrentMeas(void)
{
	ADCA.CH2.MUXCTRL = ADC_CH_MUXPOS_PIN7_gc ; // actual current
	PORTD.OUTCLR = (1<<2);
}

void ADC_ActivateLoCurrentMeas(void)
{
	ADCA.CH2.MUXCTRL = ADC_CH_MUXPOS_PIN6_gc ; // actual current
	PORTD.OUTSET = (1<<2);
}

volatile uint8_t ADCwatchdog;
extern Battery_Info_t g_tBattery_Info;

ISR(DMA_CH0_vect)
{
	// it takes 5600 clk from event activation to here. (calculated with 62500 Hz ADCclk)
	ADCwatchdog = 1;

	// now check values immediately:
	if( ADC_ScaleVolt_mV( g_asADCDMAvalues[1] ) > g_tBattery_Info.ucNumberOfCells*4500 && g_asADCDMAvalues[1] > 10000)
	{
		// switch off
		emstop(2);
	}


	
	DMA.CH0.CTRLB |= DMA_CH_TRNIF_bm;// clear interrupt flag
	DMA.CH0.CTRLA |= DMA_CH_ENABLE_bm;// re-enable DMA
	
	EVSYS.STROBE = ( 1 << 7 ); //fire event 7, which triggers the ADC
}

int16_t ADC_GetISRValue(uint8_t ch)
{
	OS_DISABLEALLINTERRUPTS;
	int16_t ret = g_asADCDMAvalues[ch];
	OS_ENABLEALLINTERRUPTS;
	return ret;
}

/*
 * Start conversion on ADC Channel 3, which is not cyclically triggered.
 *
 * Parameter c = Pin Number.
 *
 * */
void ADC_StartConvCh3Pin(uint8_t c)
{
	/* M32 ADMUX = 0b111 & c;
	ADCSRA |= (1<<ADSC);*/

	ADCA.CH3.CTRL = ADC_CH_INPUTMODE_DIFF_gc; // external
	ADCA.CH3.MUXCTRL = (c << 3 ) & 0b01111000;

	ADCA.CH3.CTRL |= ADC_CH_START_bm;
}

/*
 * Start internal conversion
 *
 * 0 = int temperature
 * 1 = Bandgap voltage
 * 2 = Scaled VCC_mVolt (/10)
 * 3 = DAC
 *
 * */
void ADC_StartConvInt(uint8_t c)
{
	ADCA.CH3.CTRL = ADC_CH_INPUTMODE_INTERNAL_gc; // external
	ADCA.CH3.MUXCTRL = (c << 3 ) & 0b01111000;

	ADCA.CH3.CTRL |= ADC_CH_START_bm;
}

int16_t ADC_ScaleCell_mV(int16_t in)
{
	return ((int32_t)in-(int32_t)ADCZeroOffset) * (int32_t)g_tCalibration.sADCRef_mV / 957L; // 957 = (2048 / factor of amplification (2,14))
	// fixme test return ((int32_t)in-(int32_t)ADCZeroOffset) * 2013L / 957L; // 957 = (2048 / factor of amplification (2,14))
}

int16_t ADC_ScaleVolt_mV(int16_t in)
{
	return ((int32_t)in-(int32_t)ADCZeroOffset) * (int32_t)g_tCalibration.sADCRef_mV / 158; // (2048 / 13(Spannungsteiler))= 158;
}

int16_t ADC_ScaleLowAmp_mA(int16_t raw)
{
	return ((int32_t)raw-(int32_t)ADCZeroOffset) * (int32_t)g_tCalibration.sADCRef_mV / 2048L * 100L / 63L;
	//				(ADC - offset)  / 2048 * Uref  / ( 0.105 * 6 )
	//													 |     |
	//													 |     -> Amplification factor (OpAmp)
	//													  -> Resistor
}


int16_t ADC_ScaleHighAmp_mA(int16_t raw, int16_t zero)
{
	// from simulation: 94mV @ -10.0 A ; 1.027V @0A ; 1,96V@10A
	int32_t temp;
	int32_t umeas_mV;
	if(raw > zero)
	{
		temp = raw-zero;
		// 0mA : temp = 0
		// 10000mA : temp = 933 mV diff
		umeas_mV = temp * (int32_t)g_tCalibration.sADCRef_mV / 2048L;
		return umeas_mV * 10000 / 1410;  // old 933mV by simulation ; 1410 by test
		
	}
	else
	{
		return 0; // todo negative measurements
		// 0mA : temp = 0
		// -10000mA : temp = -933 mV diff
		
	}
	
	// alter mist: return ((int32_t)raw-(int32_t)zero) * (int32_t)g_tCalibration.sADCRef_mV / 2048L * 1000L / 95L;
		// ADC / 2048 * Uref  / ( 0.005 * 19 )
		//                          |     |
		//                          |     -> Amplification factor (OpAmp)
		//                          -> Resistor
}
