fabianhu/ueberloader/LipoLoader/AVR/pwm.h

/*
 * PWM settings for the Üeberloader
 *
 * */

#include <avr/io.h>

// Prototypes
void vPWM_Init(void);
void vPWM_Set(uint16_t usPower, uint16_t usStartstep);
void PWM_Setfrequency(int16_t f); // in kHz!!!
void PWM_SetRatio(uint16_t r); // main / x = slow(refresh) frq.


void SetEnableBuck(uint16_t usStartstep); // 1000-0 scaled; 0= fully started
void SetEnableBoost(uint16_t usStartstep); // 1000-0 scaled; 0= fully started

void vGovernor(	int16_t _I_Set_mA,	int16_t _I_Act_mA );

int16_t PID(int32_t diff, int32_t* I, uint16_t kP, uint16_t kI, uint16_t kD, int16_t lowerLimit, int16_t upperLimit) ;
/*void RampUpDn(uint16_t* ramped, uint16_t target, uint16_t upper,uint16_t lower);
void RampUp(uint16_t* ramped, uint16_t target);
void RampDn(uint16_t* ramped, uint16_t target);*/

// Defines
#define ENABLE_A_OFF	TCC0.CCBBUF = 0;
#define ENABLE_B_OFF	TCD0.CCBBUF = TCD0.PERBUF +4; // inverted


//define PERIOD_L pwm_us_period_H + (pwm_us_period_H +4)* pwm_us_period_div // common divider...
//#define PERIOD_L pwm_us_period_H + (pwm_us_period_H )* pwm_us_period_div // odd divider...
#define PERIOD_MAX 0xffff
#define CHANGEOVER 100
#define MINSWITCHOFFPWM 50 // gemessen, viel weniger geht nicht. (Oszi am Gate)

#if CHANGEOVER < MINSWITCHOFFPWM
	#error nein.
#endif

#define STARTMAX 1000ul // start value

#define STARTUPLEVEL_mA 300 // minimum current for syncronous op.
#define MAXCONVERTERPOWER_W 100 // maximum converter power


#define min(x,y) (((x)<(y))?(x):(y))
#define max(x,y) (((x)>(y))?(x):(y))
#define limit(v,l,u) (((v)<(l))?(l):(((v)>(u))?(u):(v)))
