fabianhu/ueberloader/LipoLoader/AVR/serial.h

/*
 * SHARED serial.h
 *
 *  Created on: 25.05.2010
 *      Author: Fabian
 */

#ifndef SERIAL_H_
#define SERIAL_H_

#include <avr/io.h>

//Masters Commands:
#define UCI_SET_CMDs 			22 // Set actual command struct (Command_t) (no answer expected)
#define UCI_GET_CMDs			33 // Get Actual command setting (Command_t)
#define UCI_GET_OPVs 			44 // Get actual Operating values (Battery_Info_t)
#define UCI_WRITE_EEPROM		66 // Write settings into eeprom of slave
#define UCI_ACTION				77 // perform action (see payload string e.g. ACT_AUTO_RUN)

typedef enum //BatteryStatus
{
	eBattWaiting, // = idle
	eBattCharging,
	eBattFull,
	eBattError,
	eBattSupplyUntervolt,
	eBattMaxCap,
	eBattMaxTime,
	eBattUnknown,
	//eBattEmpty,
}eBatteryStatus_t;

typedef struct BatteryCell_tag
{
	int16_t  sVoltage_mV;
	uint32_t unDisCharge_mAs;
	uint32_t unDisCharge_mWs; // todo fill
}BatteryCell_t;

typedef struct Battery_Info_tag
{
	eBatteryStatus_t eState;
	int16_t  sActVoltage_mV;
	int16_t  sActCurrent_mA;
	uint8_t  ucNumberOfCells;
	uint32_t unCharge_mAs;
	uint32_t unCharge_mWs;
	uint32_t unTimeCharging_s;
	uint16_t usConverterPower_W;
	int16_t  sISetpoint;
	int16_t  sVSetpoint;
	uint16_t usPWM; 
	BatteryCell_t Cells[6];
	int16_t ucDegC; // Temperature in degrees C
	int16_t  sSupplyVolt_mV; // supply voltage
}Battery_Info_t;

typedef enum
{
	eActNop = 0,
	//eActModeStop,
	eActModeAuto,
	//eActModeManual,
	eActCalLow,
	eActCalHigh
}ChargerAction_t;

typedef enum
{
	eModeStop = 0,
	eModeAuto,
	eModeManual
}ChargerMode_t;


typedef struct Command_tag
{
	int16_t  sCurrentSetpoint;  // max current
	uint8_t  ucUserCellCount; // 0 for auto
	uint8_t  dummy; // "size of Command must be 16 bit aligned for CRC"
	uint16_t usVoltageSetpoint_mV; // volt per cell
	uint16_t unQ_max_mAh; // max Capacity
	uint16_t usT_max_min; // max Time
	uint16_t usMinBalanceVolt_mV; // voltage to start balancing

	uint16_t refreshrate; // 10
	uint16_t SuppMin_mV;
}Command_t;


typedef struct UCIFrame_tag
{
	uint8_t ID;
	uint8_t UCI;
	uint8_t crc;
	uint8_t len;
	uint8_t values[sizeof(Battery_Info_t)]; // biggest element to be sent/recvd
}UCIFrame_t;

#define UCIHEADERLEN 4



#endif /* SERIAL_H_ */
