fabianhu/ueberloader/(commit log)

2010-01-03 PCB: etwas weitergezeichnet Code: Comand struct eingeführt
    [LiPoLoader.brd, LiPoLoader.sch]
2010-01-03 updated FET driver.asc with correct order. (No influence on driver) Warum kommentier ich hier in Englisch??
2010-01-05 transistoren und dioden ausgewechselt.
    [LiPoLoader.brd, LiPoLoader.sch]
2010-01-05 bissle weitergemacht.
    [LiPoLoader.brd, LiPoLoader.sch]
2010-01-05 added balancer outputs
    [LiPoLoader.brd, LiPoLoader.sch]
2010-01-06 mal alles platziert
    [LiPoLoader.brd, LiPoLoader.sch]
2010-01-06 Entladewiderstände auf richtige Bauform BOM angelegt
    [LiPoLoader.brd, LiPoLoader.sch]
2010-01-06 added comment
    [LiPoLoader.brd, LiPoLoader.sch]
2010-01-06 transis alle npn gleicher typ
    [LiPoLoader.brd, LiPoLoader.sch]
2010-01-06 spannungsteiler eingef.
    [LiPoLoader.brd, LiPoLoader.sch]
2010-01-06 Bereichsumschaltung hinzu
    [LiPoLoader.brd, LiPoLoader.sch]
2010-01-06 cs hinzu bereichsumsch. richtig
    [LiPoLoader.brd, LiPoLoader.sch]
2010-01-06 diverse änderungen
    [LiPoLoader.brd, LiPoLoader.sch, LiPoLoader_bom.csv]
2010-01-07 layout; Fehler GND - Minus Messeingang
    [LiPoLoader.brd, LiPoLoader.sch]
2010-01-07 Einen ganzen haufen Teilenummern eingeklopft.
    [LiPoLoader.brd, LiPoLoader.sch, LiPoLoader_bom.csv]
2010-01-07 Bestellnummern hinzu, Packages geändert... NTC hinzu
    [LiPoLoader.brd, LiPoLoader.sch, NTC measure.ods]
2010-01-07 temperaturmessung besser
    [LiPoLoader.brd, LiPoLoader.sch, NTC measure.ods]
2010-01-07 mit Verpolschutz
    [LiPoLoader.brd, LiPoLoader.sch]
2010-01-07 schau mal bitte
    [LiPoLoader.brd, LiPoLoader.sch]
2010-01-07 Verpolschutz Akku
    [LiPoLoader.brd, LiPoLoader.sch]
2010-01-07 roh platziert
    [LiPoLoader.brd, LiPoLoader.sch]
2010-01-08 layouted weiter
    [LiPoLoader.brd, LiPoLoader.sch]
2010-01-08 bla ljhlkglkglkg
    [LiPoLoader.brd, LiPoLoader.sch]
2010-01-09 layout optimisiert, geht fast, aber noch nicht ganz.
    [LiPoLoader.brd, LiPoLoader.sch]
2010-01-09 Differential measure.asc aktualisiert auf 3.3V
2010-01-09 nach einer langen Nacht gings in der Früh ganz leicht...
    [LiPoLoader.brd]
2010-01-10 alles drauf und routet durch! Anpassungen für 3.3V ok
    [LiPoLoader.brd, LiPoLoader.sch, NTC measure.ods]
2010-01-10 nun mit seriellem Bus und routet auch.
    [LiPoLoader.brd, LiPoLoader.sch]
2010-01-10 display board roh hinzu
    [LiPoDisp.brd, LiPoDisp.sch]
2010-01-11 Angstwiderstände hinzu layout in new case
    [LiPoLoader.brd, LiPoLoader.sch]
2010-01-13 changed for N-channel Mosfet
2010-01-16 mosfet driver hinzu
    [LiPoLoader.brd, LiPoLoader.sch]
2010-01-16 minus nach oben gedreht
    [LiPoLoader.brd, LiPoLoader.sch]
2010-01-16 no bisserl blöd rumgeschoben
    [LiPoLoader.brd, LiPoLoader.sch]
2010-01-17 noch weiter probiert
    [LiPoLoader.brd, LiPoLoader.sch]
2010-01-18 added dcdc calc, better layout
    [DCDC.ods, LiPoLoader.brd, LiPoLoader.sch]
2010-01-19 max PWM auf achzig
2010-01-20 Berechnungen hinzu
    [LiPoLoader.brd]
2010-01-22 added xmega prototype board
    [xmegaproto.brd, xmegaproto.sch]
2010-01-22 messungen geändert für 2V (= 3.3V / 1.6)
2010-01-25 updated some parts
    [LiPoLoader.brd, LiPoLoader.sch]
2010-01-26 vor umdrehen der power-Abteilung
    [LiPoLoader.brd, LiPoLoader.sch]
2010-01-26 bissel gedreht.
    [LiPoLoader.brd, LiPoLoader.sch]
2010-01-27 layout sieht gar nicht so übel aus
    [LiPoLoader.brd, LiPoLoader.sch]
2010-01-27 Bestellnummern Mosfets eingetragen
    [LiPoLoader.brd, LiPoLoader.sch]
2010-01-27 updated some packages and numbers
    [LiPoLoader.brd, LiPoLoader.sch, bom.ods]
2010-01-27 updated bom.ods
    [bom.ods]
2010-01-27 new layout mit tel
    [LiPoLoader.brd, LiPoLoader.sch]
2010-01-27 sicherunngen auf platine
    [LiPoLoader.brd, LiPoLoader.sch]
2010-01-27 balancer n kanal
    [LiPoLoader.brd, LiPoLoader.sch]
2010-01-27 bedrahtete balancer
    [LiPoLoader.brd, LiPoLoader.sch]
2010-01-27 aux-Anschlüsse umgelegt, 2. Temp eingang hinzu, FAN vorbereitet.
    [LiPoLoader.brd, LiPoLoader.sch]
2010-01-28 new version with changed headers and smd-resistors
    [LiPoLoader.brd, LiPoLoader.sch]
2010-01-28 Überarbeitete Stüli; Mit Lüfter-Anschluss
    [LiPoLoader.brd, LiPoLoader.sch, bom.ods]
2010-01-31 Farnell bestellt
    [bom.ods]
2010-02-02 xmega RETI issue adc init
    [adc.c, adc.h, main.c, ueberloader.c]
2010-02-02 Lüfter-Anschluss mit zwischen-R
    [LiPoLoader.brd, LiPoLoader.sch]
2010-02-02 bissel layout
    [LiPoLoader.brd, LiPoLoader.sch]
2010-02-04 bissel besser, aber immer noch doof (DMA)
2010-02-06 ADC works now. Must use an event to trigger the DMA correctly. Now, if Event 7 is fired, 4 channels are converted in 248 ck. (7µs)
    [adc.c]
2010-02-07 prototype description text
    [LiPoLoader.brd, LiPoLoader.sch, xmegaproto.brd, xmegaproto.sch]
2010-02-08 swapped gate pins
    [LiPoLoader.brd, LiPoLoader.sch]
2010-02-08 updated pwm / ADC
2010-02-08 anderer mosfet-treiber
    [LiPoLoader.brd, LiPoLoader.sch]
2010-02-14 neue mosfet-treiber und Spannungen angepasst
    [LiPoLoader.brd, LiPoLoader.sch]
2010-02-14 layout noch besser
    [LiPoLoader.brd, LiPoLoader.sch]
2010-02-15 improved serial bus
    [LiPoLoader.brd, LiPoLoader.sch]
2010-02-15 fixed umschaltfix
    [LiPoLoader.brd, LiPoLoader.sch]
2010-02-15 seriell gedreht
    [LiPoLoader.brd, LiPoLoader.sch]
2010-02-15 decoupling of bus supply
    [LiPoLoader.brd, LiPoLoader.sch]
2010-02-15 steckerzuordnung anders
    [LiPoLoader.brd, LiPoLoader.sch]
2010-02-16 super layout, nicht auflösen
    [LiPoLoader.brd, LiPoLoader.sch]
2010-02-18 improved layout
    [LiPoLoader.brd, LiPoLoader.sch]
2010-02-21 first try with startup mode, which does not work yet.
    [adc.c, main.c, ueberloader.c]
2010-02-21 Layout der Mosfetansteuerung optimiert
    [LiPoLoader.brd]
2010-02-22 Stromregler super, Spannungsregler super, Übergang Buck-Boost super; Übergang enable rechts aus-an super. Was will man mehr?
2010-02-22 modularized code for PWM (little bit)
2010-02-23 mimimal geändert
    [LiPoLoader.brd]
2010-02-24 Beschriftungen hingeschoben
    [LiPoLoader.brd, LiPoLoader.sch]
2010-02-24 minor changes
    [LiPoLoader.brd, LiPoLoader.sch]
2010-02-24 mosfet footprint dpak
    [LiPoLoader.brd, LiPoLoader.sch]
2010-02-24 Grosse Cs verschoben, Massefläche hinzu
    [LiPoLoader.brd, LiPoLoader.sch]
2010-02-24 renewed display pcb
    [LiPoDisp.brd, LiPoDisp.sch]
2010-02-27 enable pulldowns neu pos. masseflächen routing von temp1
    [LiPoLoader.brd, LiPoLoader.sch]
2010-02-28 Layout aufgehübscht
    [LiPoLoader.brd]
2010-02-28 updated BOM
2010-03-01 led, hübsch, pad von q4 größer
    [LiPoLoader.brd, LiPoLoader.sch]
2010-03-01 uli sagt fertig. Sicherungen müssen noch!
    [LiPoLoader.brd, LiPoLoader.sch]
2010-03-01 seriell i.o. temperatur i.o.
    [LiPoDisp.brd, LiPoDisp.sch, LiPoLoader.brd, LiPoLoader.sch]
2010-03-01 tempmess auf 2v angepasst
    [NTC measure.ods]
2010-03-02 added teardropped board, minor movements of signals
    [LiPoLoader.brd, LiPoLoader_td.brd, LiPoLoader_td.sch]
2010-03-03 adc functions for channel 3
2010-03-03 adapted BOM for second order
    [bom.ods]
2010-03-10 bestellfix, Werte geändert. !!! Fehlen im Schaltplan!!
    [LiPoDisp.brd, LiPoDisp.sch, bom.ods]
2010-03-10 now with slider control (ahemm prototype...)
2010-03-21 added display adapter
    [LiPoDisp.brd, LiPoDisp.sch, bom.ods, disp_adapter.brd, disp_adapter.sch]
2010-03-22 finished as built drawings
    [LiPoLoader_td.brd, bom.ods]
2010-03-29 lädt mit 1A und misst recht gut
2010-03-29 added some stuff and changed bom.ods
    [LiPoDisp_ULN.brd, LiPoDisp_ULN.sch, Voltage Measurement.ods, bom.ods]
2010-04-10 some optimizing with ADC
2010-04-10 added folders and moved stuff for display project
    [LiPoDisp.brd, LiPoDisp.sch, LiPoDisp_ULN.brd, LiPoDisp_ULN.sch, LiPoLoader.brd, LiPoLoader.sch, LiPoLoader_td.brd, LiPoLoader_td.sch]
2010-04-15 done some adc optimizing, but not yet satisfied.
2010-04-27 implemented layout change
    [LiPoLoader.brd, LiPoLoader.sch, LiPoLoader_td.brd, LiPoLoader_td.sch, Voltage Measurement.ods]
2010-04-27 adc etwas entschlackt
2010-04-28 some layout for the display
    [LiPoDisp.brd, LiPoDisp.sch, disp_adapter.brd]
2010-04-28 slightly optimized layout
    [LiPoDisp.brd, LiPoDisp.sch]
2010-05-02 -Spannungsquellen angepasst (Widerstandsteiler bestimmt): 3V3 -> VCCIO (+2V für LCDIO & MCU) VDD -> VDD (+3V für LCDVDD & SD-Card) -Vorwiderstände LED-Backlight bestimmt -Pull-Down für LED-BL-Switch 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
    Todo:
    -Routing VCCIO & VDD an LCD-Stecker (hab schon Platz gemacht)
    -Stecker von LCD passt durch Bohrung
    (ACHTUNG: COM-Stecker verdeckt das Loch, evtl. verschieben?)
    -Evtl. VDD mit 3V zu niedrig für Kommunikation mit Akku-Lader?
    [LiPoDisp.brd, LiPoDisp.sch]
2010-05-02 littele bittele layout
    [LiPoDisp.brd, LiPoDisp.sch]
2010-05-03 layout optimiert
    [LiPoDisp.brd, LiPoDisp.sch]
2010-05-04 display updated
    [LiPoDisp.brd, LiPoDisp.sch]
2010-05-04 Fertigungsfaehig machen
    [LiPoDisp.brd, LiPoDisp.sch, LiPoDisp_td.brd, LiPoDisp_td.sch]
2010-05-04 added BOM.
2010-05-22 reworked some stuff and working usart
    [adc.c, main.c, ueberloader.c, ueberloader.h, usart.c, usart.h]
2010-05-22 Erste Änderungen am Schaltpaln und Layout. Kompatibel mit der Fädelung.
    [LiPoLoader.brd, LiPoLoader.sch, USART.ods]
2010-06-01 fixed FabOS event error
    [pwm.c, pwm.h, serial_slave.c]
2010-06-02 noch nicht wirklich fertig
2010-06-08 some layout opt
    [LiPoDisp_td.brd, LiPoDisp_td.sch, touch.brd]
2010-06-21 -lcd.c & lcd.h hinzugefügt und portiert. -Displayausgabe gedreht
2010-06-22 while checking against rev. 191 I found only one minor mistake.
    [lcd.c]
2010-06-22 labels richtig hingeschoben
    [LiPoDisp.brd]
2010-06-22 found another Error in FabOS ;-(
    [main.c]
2010-06-22 updated FabOS with now lesser errors ;-)
    [FabOS_config.h, lcd.c, lcd.h]
2010-06-29 changed uart for different baud rates
2010-06-29 Schaltpläne etwas aufgehübscht (Layers Rework!!!)
    [ATxmega_Baud_Rate_Calculator_v1.0.ods, LiPoDisp.brd, LiPoDisp.sch, LiPoLoader_td.brd, LiPoLoader_td.sch]
2010-06-29 first serial comm seems to work (with errors)
    [main.c]
2010-07-01 fixed the rework changes for the next release (Serial RX)
    [LiPoLoader.brd, LiPoLoader.sch]
2010-07-04 instrumented PWM, switch balancer on, if no cell detected.
2010-07-04 Schaltplan etwas aufgehübscht
    [LiPoLoader.brd, LiPoLoader.sch]
2010-07-05 added PID for current gov
2010-07-05 PID etwas besser, P fehlt noch
2010-07-07 added resistor for coupling cell0 minus to gnd.
    [LiPoLoader.brd, LiPoLoader.sch, LiPoLoader_td.brd]
2010-07-14 added discharge resistor at battery side
    [LiPoLoader.brd, LiPoLoader.sch]
2010-07-19 Resistor between minus of batt and lowest balancer input moved to correct pos.
    [LiPoLoader.brd, LiPoLoader.sch]
2010-07-19 added display of charge and time
2010-07-19 - Added correct current measurement - added Battery charge counter - added single cell battery counter - current measurement: now accurate. - reduce current if one cell has reached limit. - ResetLast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
    [adc.c, adc.h, ueberloader.c, ueberloader.h]
2010-07-19 Resistor between minus of batt and lowest balancer input opt.
    [LiPoLoader.brd, LiPoLoader.sch]
2010-07-19 fixed overvolt per cell recognition
    [ueberloader.c]
2010-07-23 try to fix serial comm
    [main.c, serial.h]
2010-07-24 added LED Task added State-machine Task
2010-08-08 updated PCBs for stackable charger and display
    [LiPoDisp.brd, LiPoDisp.sch, LiPoLoader.brd, touch.brd]
2010-08-09 updated PCBs
    [LiPoDisp.brd, LiPoDisp.sch, LiPoLoader.brd, LiPoLoader.sch]
2010-08-09 Display um 0.5mm verschoben
    [LiPoDisp.brd]
2010-08-15 fiddling around with touchpad (not working)
    [main.c, touchpad.c, touchpad.h]
2010-10-05 add Jörgs changes Update PCB
    [LiPoLoader.brd, LiPoLoader.sch]
2010-10-19 added action prototypes
2010-11-09 some really minor changes the "Timer issue" still persists.
    [FabOS_config.h, lcd.h, main.c, touchpad.c, usart.c]
2010-11-24 files gelöscht, die irrtümlich waren ;-)
2010-12-04 fixed DMA error - finally
    [FabOS_config.h, lcd.c, lcd.h, main.c, usart.c]
2010-12-04 undo test switch-offs remove "naked" from OS Tasks, because they really NEED a valid stack frame.
2010-12-05 fixed overload/timing issue with display task
    [main.c]
2010-12-05 fixed some stuff with timing and init of OS
    [FabOS_config.h, ueberloader.c]
2011-01-16 updated casing
    [disp_adapter.brd, disp_adapter.sch, touch3.brd, touch5.brd]
2011-01-25 Uli sagt: Zur Not könnten wir das vorerst mal so lassen.
    [main.c, touchpad.c, touchpad.h]
2011-02-02 Jörg war da und nichts geht mehr...
2011-02-10 geht brauchbar, sagt Uli
    [lcd.c, lcd.h, main.c, touchpad.c, touchpad.h]
2011-03-23 hw updates vom Papier
    [DCDC.ods, LiPoDisp.brd, LiPoDisp.sch, LiPoLoader.brd, LiPoLoader.sch]
2011-03-23 übertragen des Spannungssollwertes
2011-04-16 added overall voltage setpoint parameter
2011-04-16 fixed overflow before 32bit calc
    [touchpad.c]
2011-05-21 Layout geändert, jetzt passt auch die LED rein
    [LiPoLoader.brd, LiPoLoader.sch]
2011-06-22 fixed comm error - finally and fixed to winavr20100110
    [FabOS_config.h, command.c, display.c, main.c]
2011-06-24 with internal reset reason logging softened the reset criteria
    [main.c, ueberloader.c]
2011-08-03 nun mit Änderung des Ladestroms während "Idle"
2011-08-16 adjust power reduction register delay charge mode after connect / disconnect.
2011-08-16 new way of adjusting current while charge
2011-08-16 advanced filter (10% filter, more direct) stop on "mode stop" also while charging.
2011-10-27 dxf gehäuse hinzu
    [GEH.DXF]
2011-11-07 added battery sim
    [Battery_sim.brd, Battery_sim.sch]
2011-11-13 first try of calibration
2011-11-16 changed base calibration to expect 1.1050 V before new governor;
2011-11-21 Stromregler zweikreisig mit PID
2012-01-05 added case drawing pdf
2012-02-16 Spule in die BOM
    [bom.ods]
2012-05-13 added calibration save and restore; minimal cleanup
2012-05-13 working calibration to and from eeprom
2012-05-15 a lot of relocations and changes... see the FIXME keyword for remaining stuff
    [FabOS_config.h, adc.c, adc.h, balancer.c, cal.c, cal.h, filter.c]
2012-05-16 hardware comment added
    [LiPoLoader.sch]
2012-05-16 fixed balancer charge counting
    [balancer.c]
2012-05-17 now the balancer works. Kann sein, dass es etwas dauert, bis die Batterie feritg geladen ist, da erst der Balancer fertig sein muss (15 Zyklen ohne Balancieren)
2012-05-17 changed filter values for balancer measurement
    [LiPoLoader_td.brd]
2012-05-17 messung des Balancer nun VIEL besser
2012-05-17 some hardware remarks.
    [LiPoLoader.sch]
2012-05-17 reduced balancer filter to 1/8
    reduced minimum current while balancing to 30mA
2012-05-18 emstop langsamer und Überspannungserkennung abh von der Zellenzahl
2013-08-06 added the changes, which were missing from last backup
    [LiPoLoader.brd, LiPoLoader.sch]
2013-08-13 save to eeprom at start of charge; do not begin charge at missing cell changed presets menue emergency stop with auto reset
    [command.c, main.c, ueberloader.c]
2014-03-21 added comments to fix
    [main.c]
2014-04-13 minor fixes and Ulis hack working again
    [eeprom.h, main.c]
2014-04-14 Verbessertes Verhalten des Touchpads beim Gerätestart
2014-04-19 Tasten umgebaut, reagieren jetzt auf loslassen. Netter Nebeneffekt den ich nicht erklären kann, wenn man eine Taste gedrückt hält, läuft der Wert.
2014-04-21 Move jetzt zeitabhängig. --> Volle Funktionalität erreicht Habe TOUCHMINSIGNAL von 32 auf 20 gestellt. Könnte evtl. zu empfindlich sein und evtl. sich auf anderer HW anders verhalten. Sonst Code aufg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
2014-04-21 bugfix, es wurde manchmal move statt Taste erkannt
    [touchpad.c]
2014-04-27 Beim umschalten von mAh auf Ah, Anzeige verbessert - untested Anzeige Supply undervoltage geändert - geht nicht MaxTime und MaxCap implementiert - geht auch nicht Variable für MaxCap von 32 bit auf 1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
    [display.c, main.c, serial.h, ueberloader.c]
2014-04-27 irgendwie kommt das Display mit anzeigen nicht nach, die Ladezeit läuft ungleichmäßig? MaxCap, MaxTime, SupplyVoltage funktionierern
2014-08-31 Max. Time in Minuten, Einheiten von Ladestrom und so wurden in Auto-Generierten Code reingehackt. Treebuilder anpassen!!
2014-09-28 Low-Range Strommessung wurde deaktiviert, da Hight Range im unteren Bereich jetzt perfekt misst. Das obere Ende der Strommessung sollte Laderindividuell calibrierbar werden. (Bauteiltoleranzen) Bei e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
2014-10-19 removed low range measurement from PCB/LiPoLoader.sch (with eagle 5.12 !)
    [LiPoLoader.brd, LiPoLoader.sch]
2015-10-18 converted to eagle 7.3
    [LiPoLoader.brd, LiPoLoader.sch]
2016-05-29 Viele Kleinigkeiten geändert: -es gibt mehr Presets und sie lassen sich jetzt abspeichern -Abschaltverhalten verändert -Logik für laden ohne Balancer angepasst -KI-Wert des Soll-Ladestroms von 8000 a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
